danbita/real-steel/docs/img_shop/bearings_1.jpg

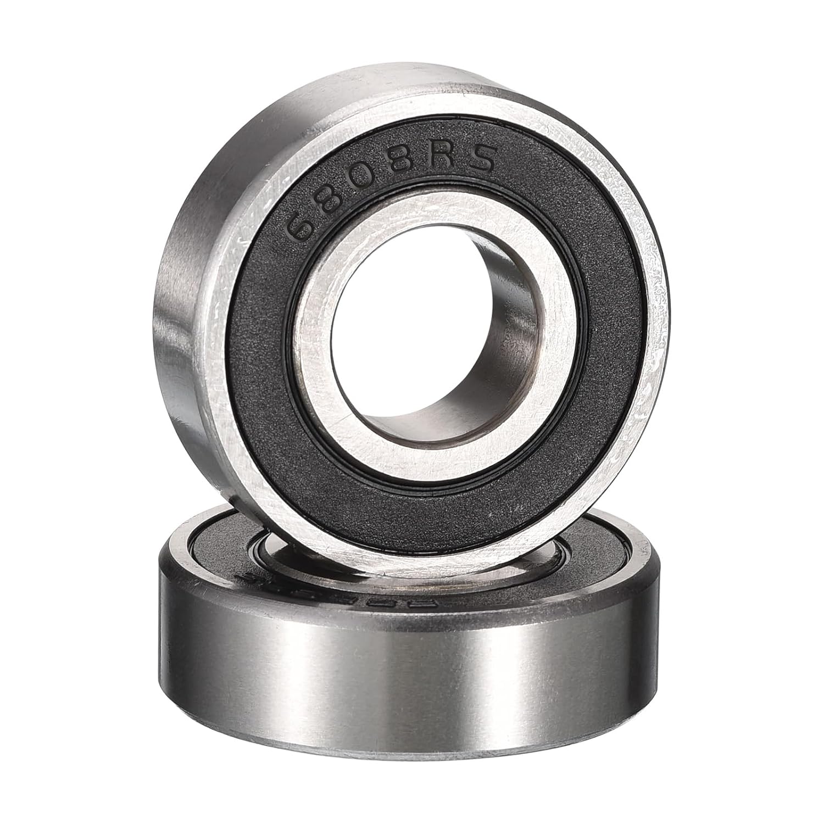
docs/img_shop/bearings_1.jpg
