danbita/real-steel/docs/img_shop/bearings_2.jpg

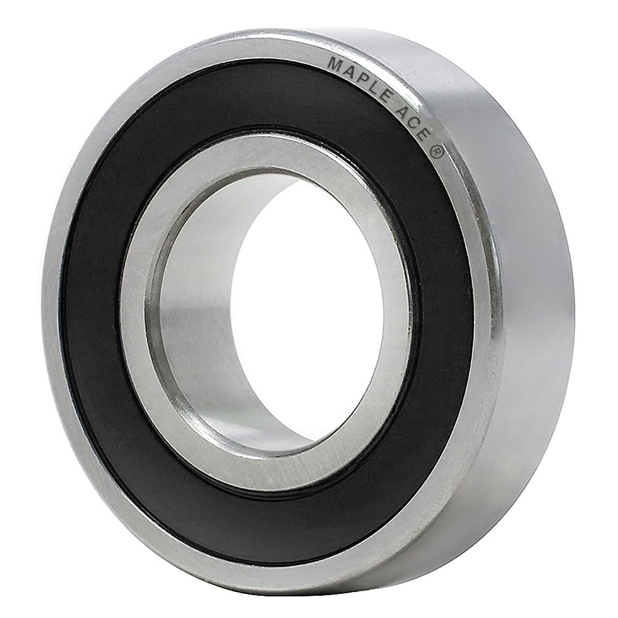
docs/img_shop/bearings_2.jpg
