danbita/real-steel/docs/img_shop/bearings_3.jpg

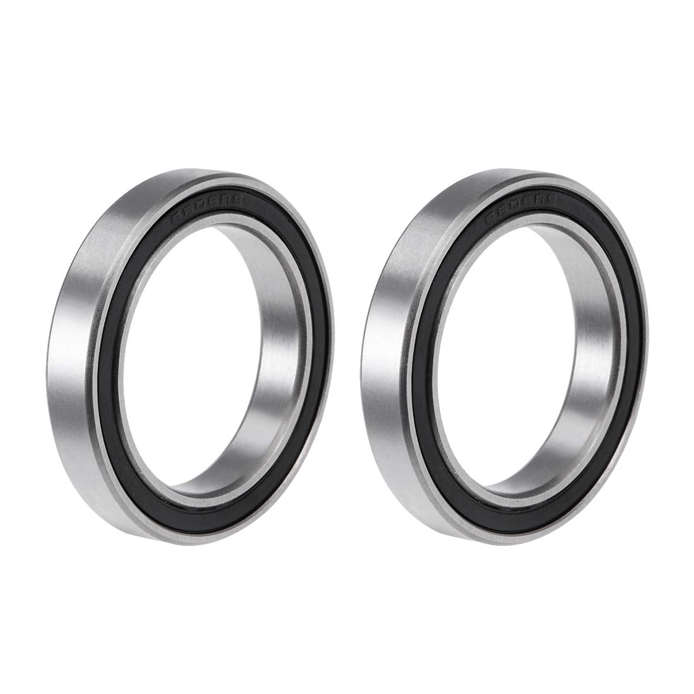
docs/img_shop/bearings_3.jpg
