danbita/real-steel/docs/img_shop/bearings_4.jpg

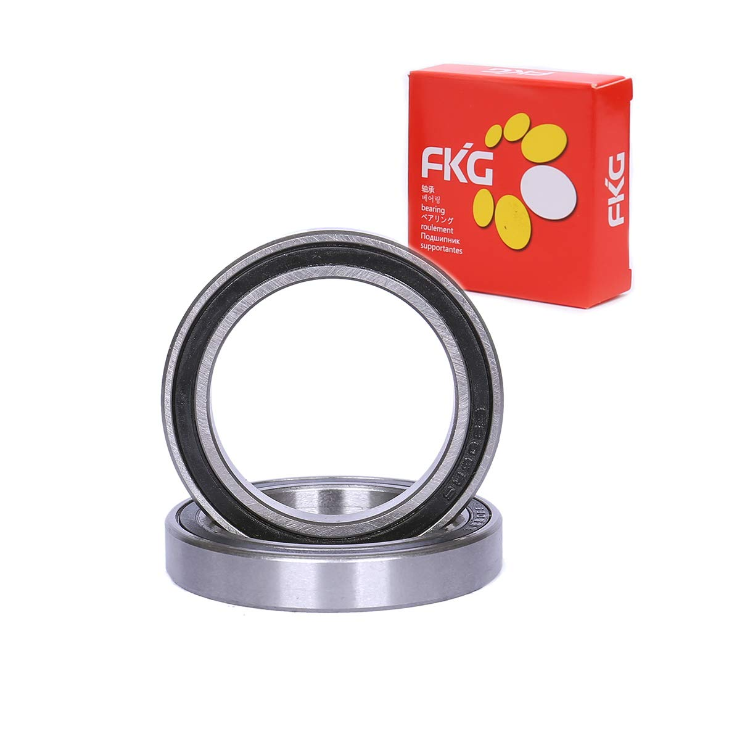
docs/img_shop/bearings_4.jpg
