danbita/real-steel/docs/img_shop/bearings_5.jpg

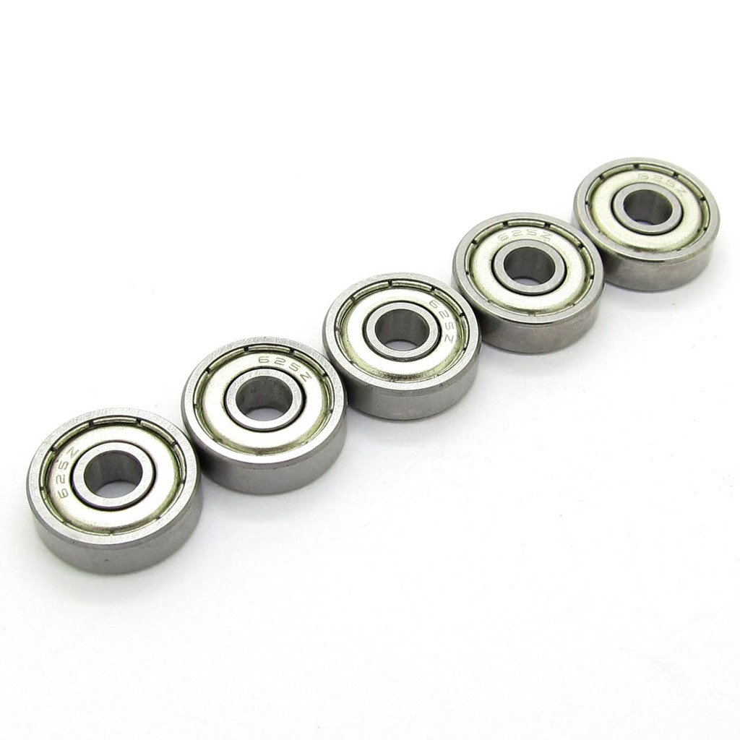
docs/img_shop/bearings_5.jpg
