danbita/real-steel/docs/img_shop/bearings_6.jpg

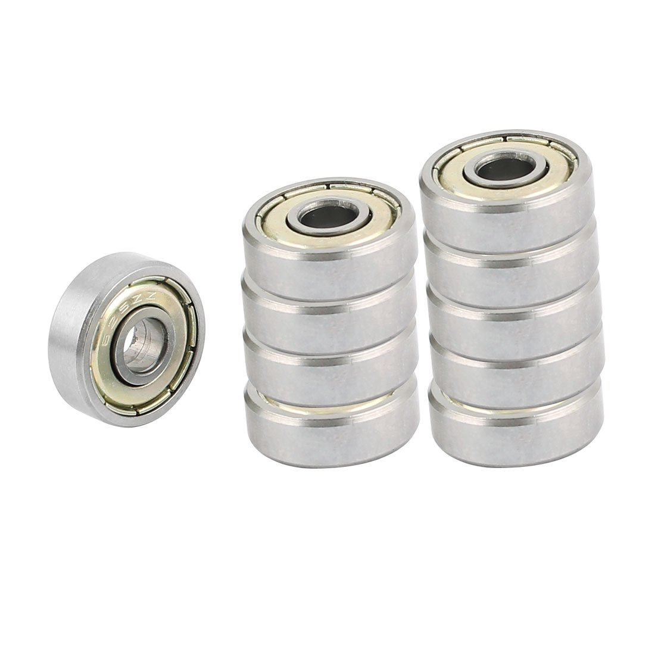
docs/img_shop/bearings_6.jpg
