danbita/real-steel/docs/img_shop/bearings_s1.jpg

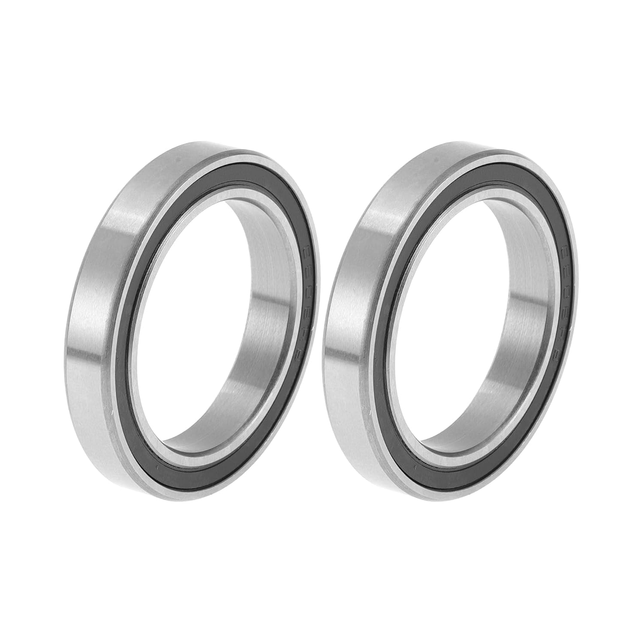
docs/img_shop/bearings_s1.jpg
