danbita/real-steel/docs/img_shop/bearings_s3.jpg

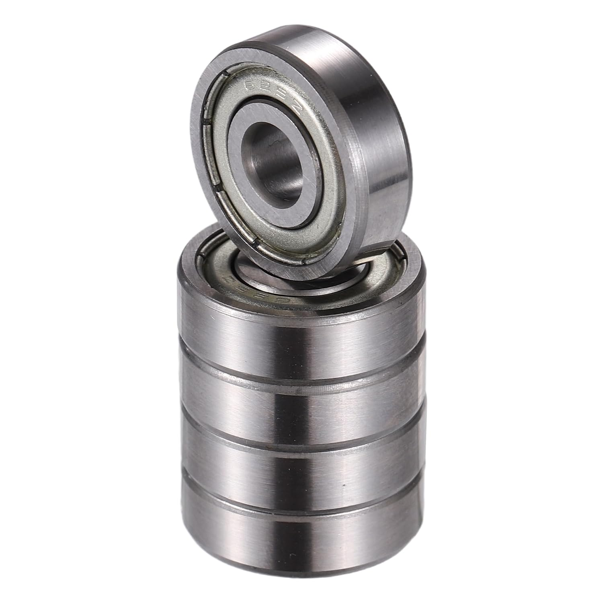
docs/img_shop/bearings_s3.jpg
