danbita/real-steel/docs/img_shop/bearings_s4.jpg

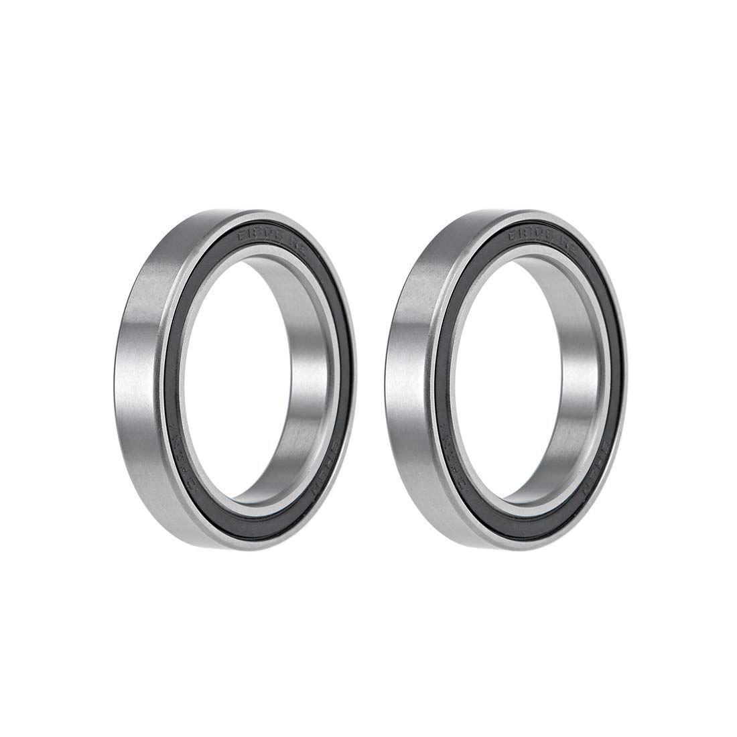
docs/img_shop/bearings_s4.jpg
