danbita/real-steel/docs/img_shop/bearings_s5.jpg

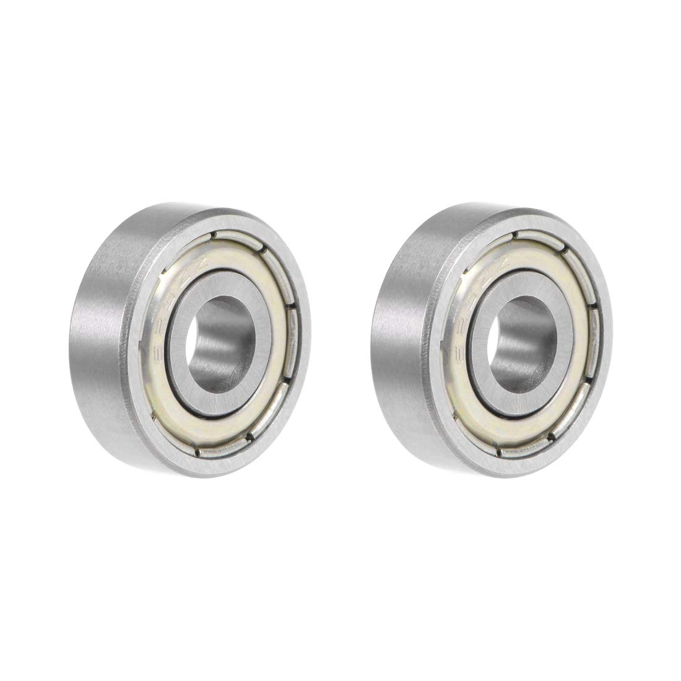
docs/img_shop/bearings_s5.jpg
