danbita/real-steel/docs/img_shop/bearings_s6.jpg

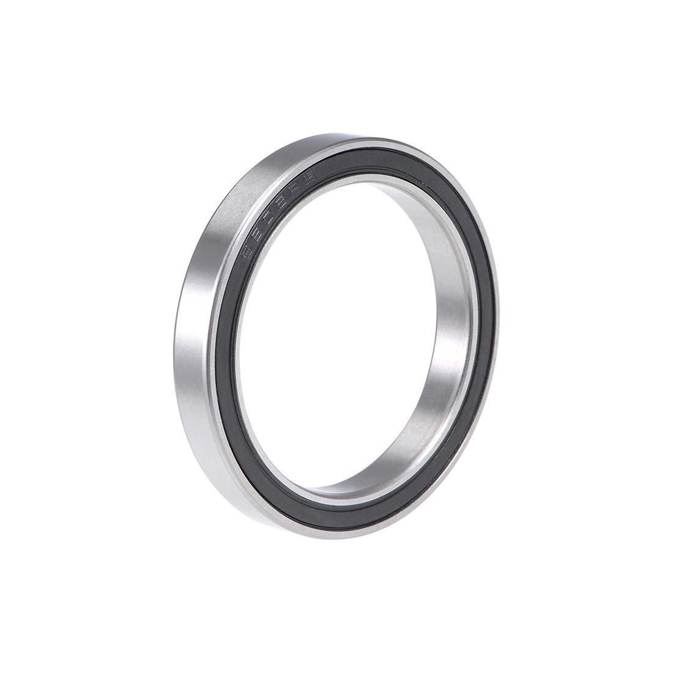
docs/img_shop/bearings_s6.jpg
