danbita/real-steel/docs/img_shop/fasteners_1.jpg

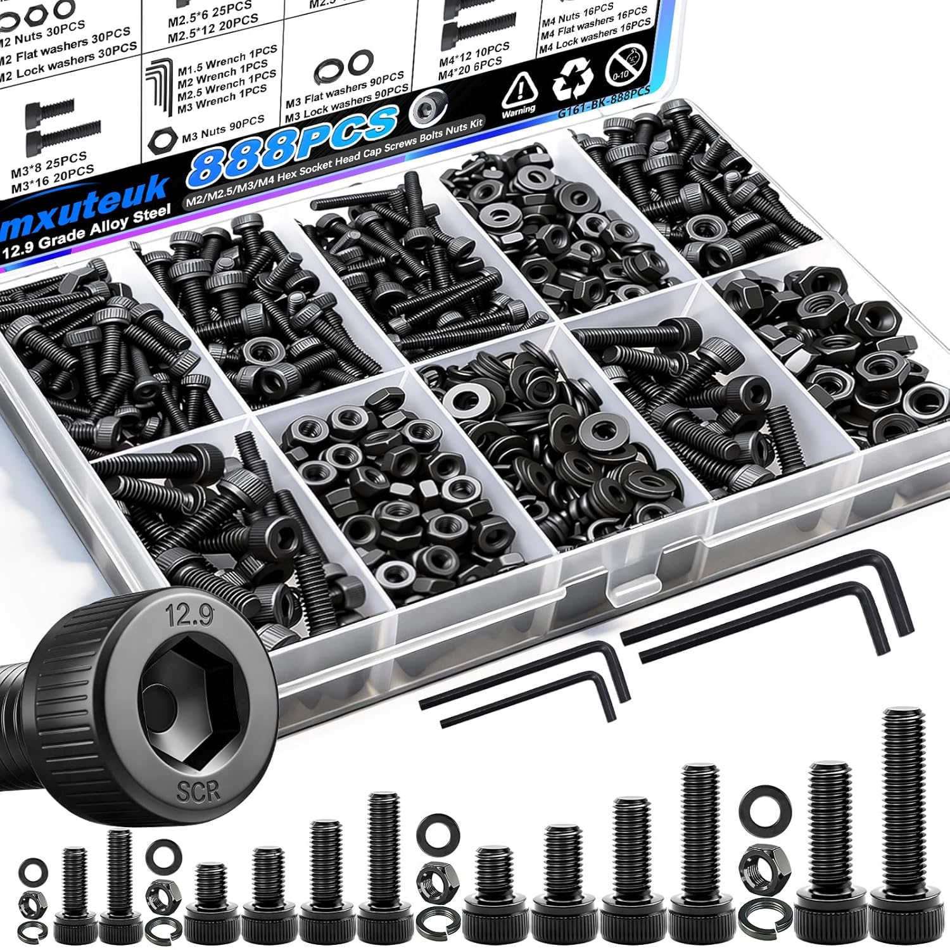
docs/img_shop/fasteners_1.jpg
