danbita/real-steel/docs/img_shop/fasteners_2.jpg

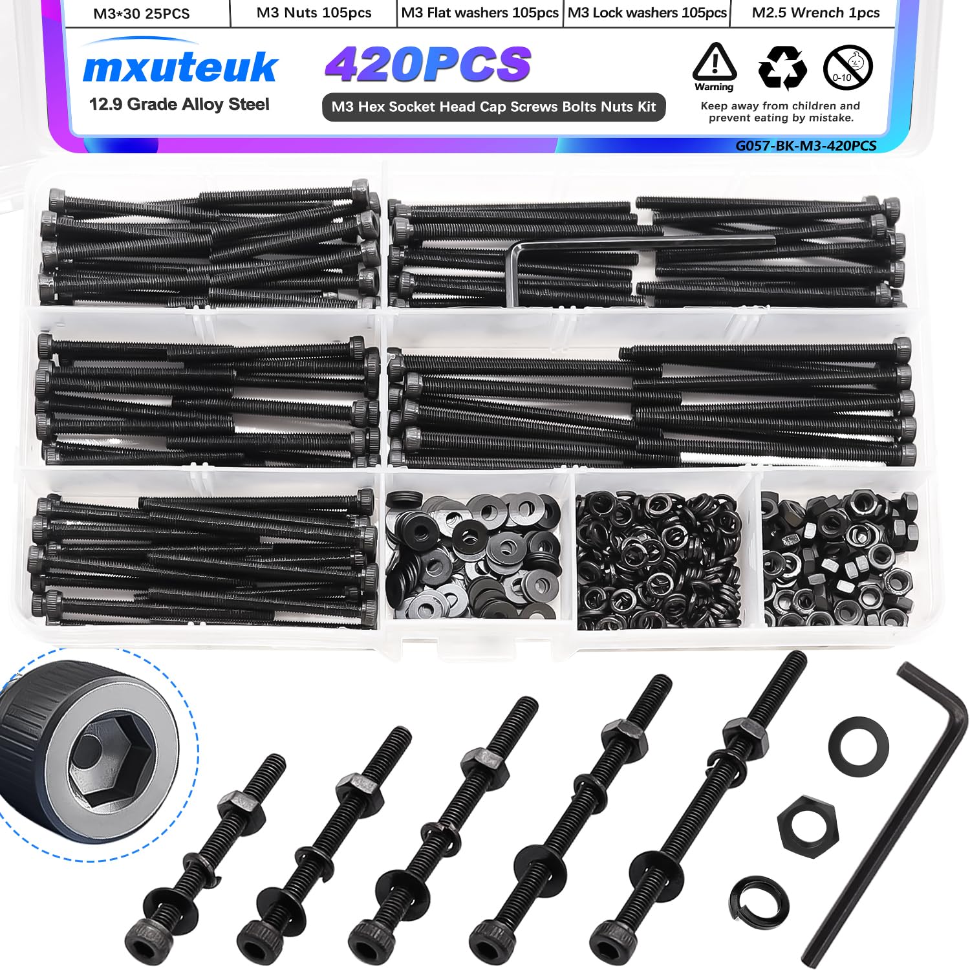
docs/img_shop/fasteners_2.jpg
