danbita/real-steel/docs/img_shop/fasteners_3.jpg

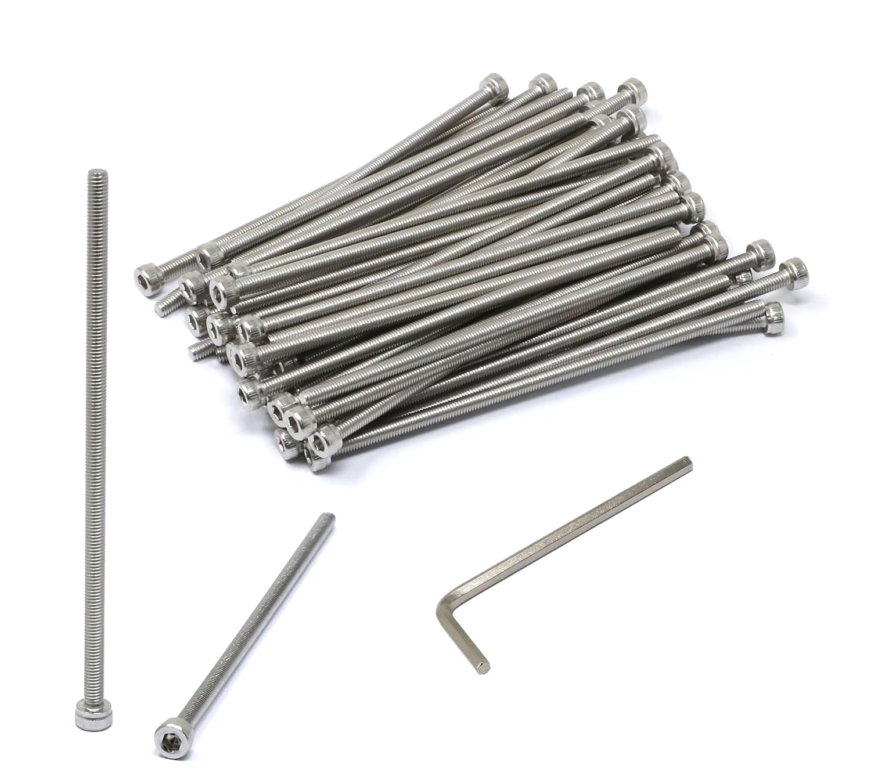
docs/img_shop/fasteners_3.jpg
