danbita/real-steel/docs/img_shop/fasteners_4.jpg

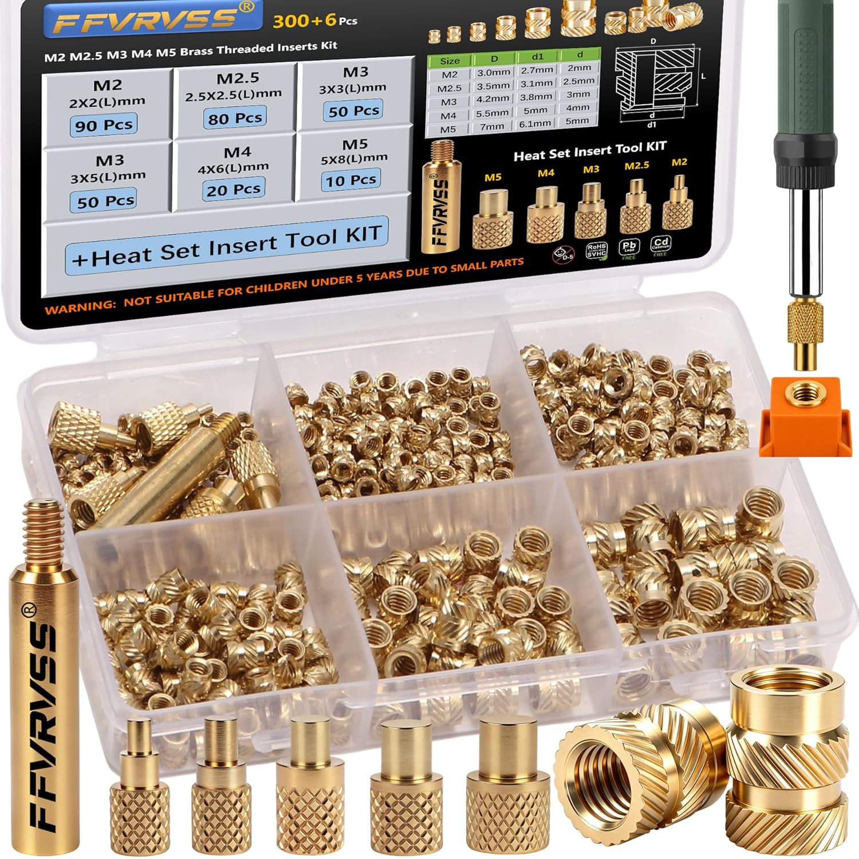
docs/img_shop/fasteners_4.jpg
