danbita/real-steel/docs/img_shop/fasteners_5.jpg

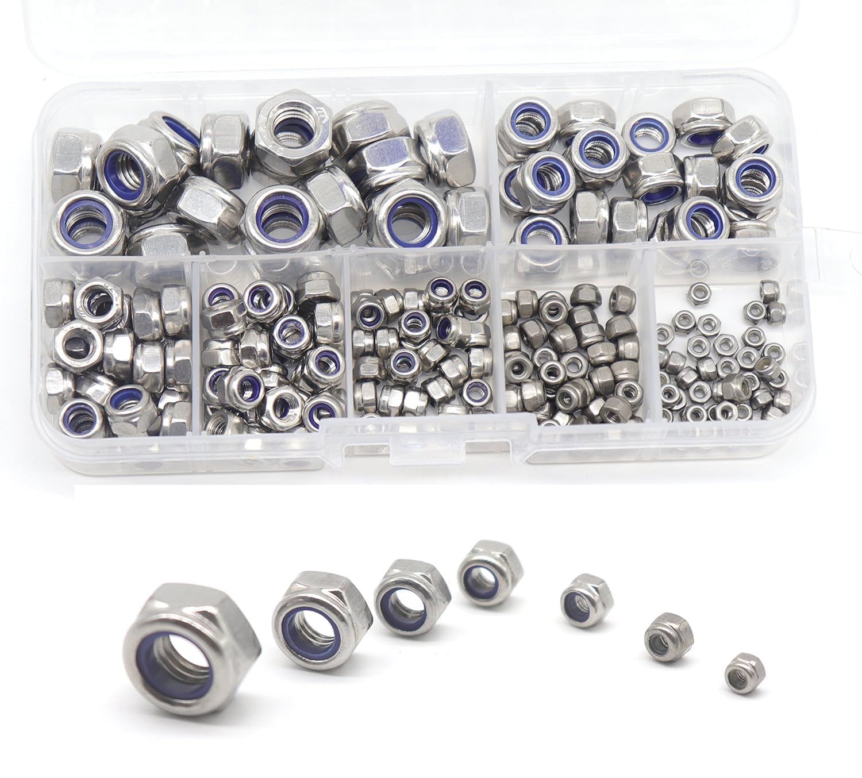
docs/img_shop/fasteners_5.jpg
