danbita/real-steel/docs/img_shop/fasteners_6.jpg

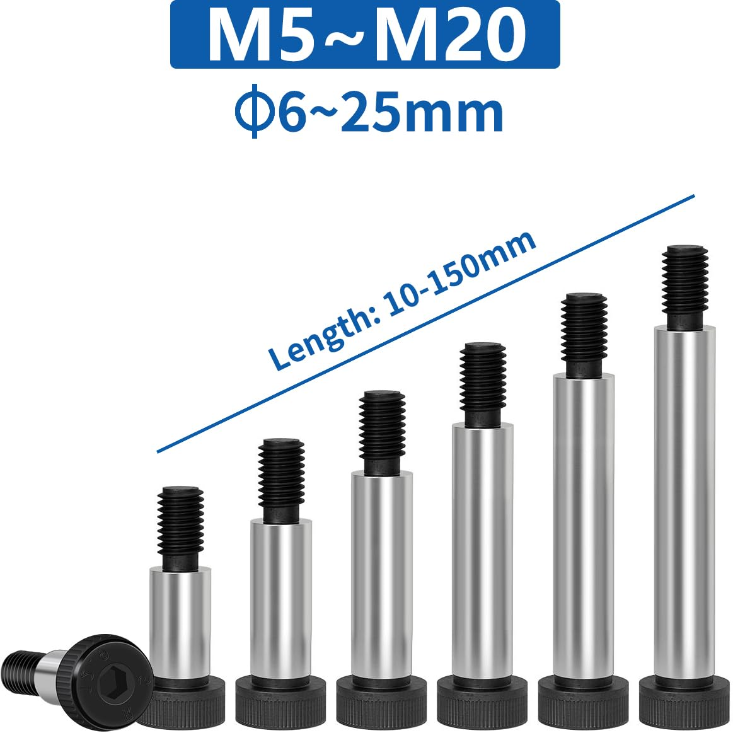
docs/img_shop/fasteners_6.jpg
