danbita/real-steel/docs/img_shop/fasteners_s1.jpg

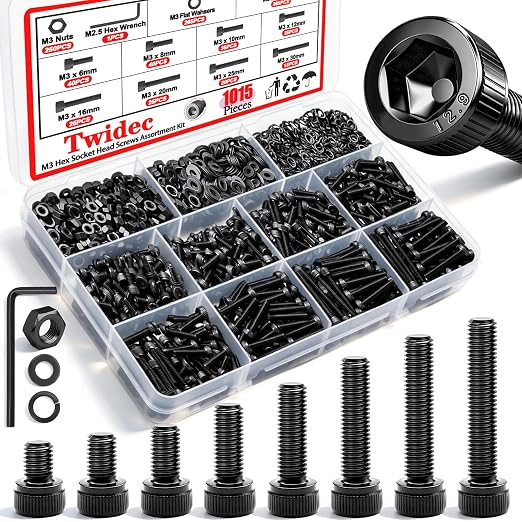
docs/img_shop/fasteners_s1.jpg
