danbita/real-steel/docs/img_shop/fasteners_s2.jpg

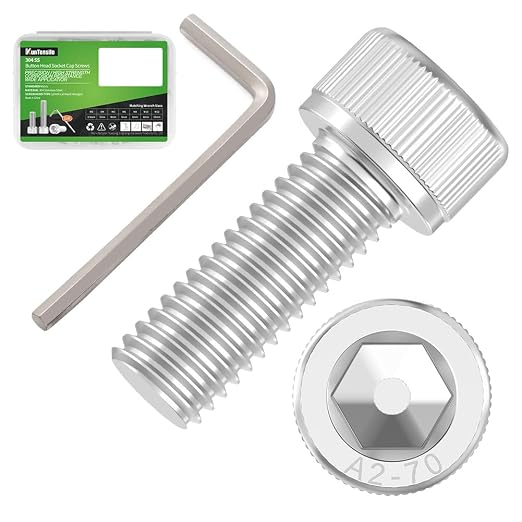
docs/img_shop/fasteners_s2.jpg
