danbita/real-steel/docs/img_shop/fasteners_s3.jpg

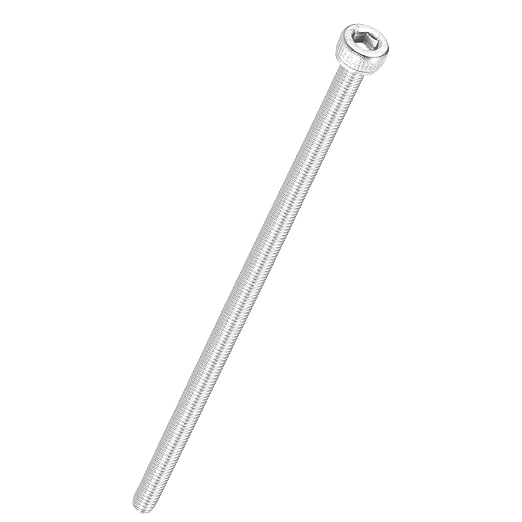
docs/img_shop/fasteners_s3.jpg
