danbita/real-steel/docs/img_shop/fasteners_s4.jpg

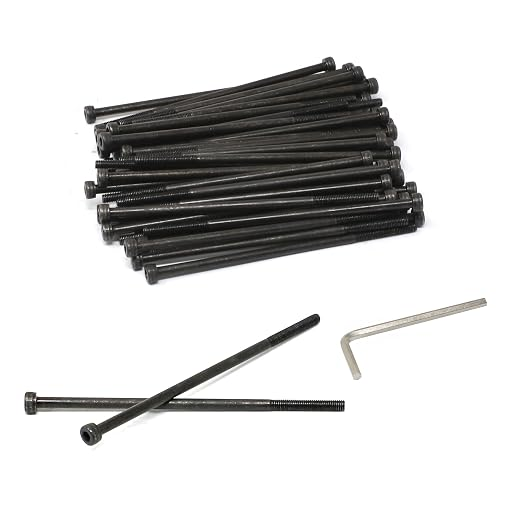
docs/img_shop/fasteners_s4.jpg
