danbita/real-steel/docs/img_shop/fasteners_s5.jpg

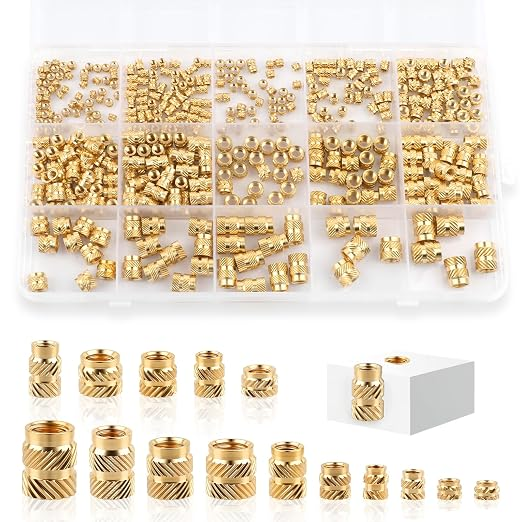
docs/img_shop/fasteners_s5.jpg
