danbita/real-steel/docs/img_shop/fasteners_s6.jpg

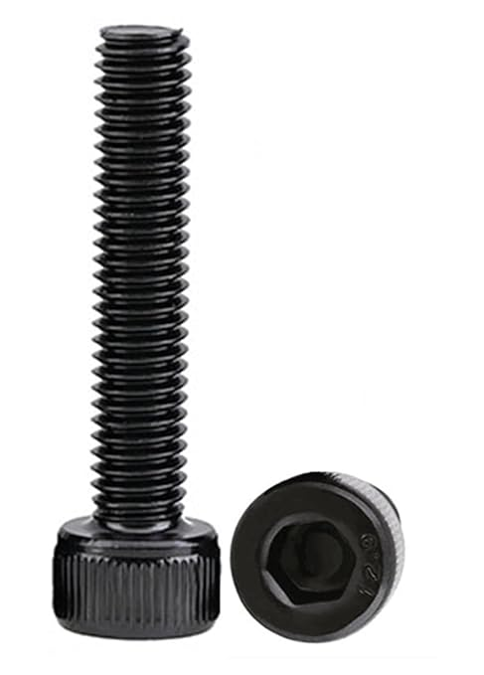
docs/img_shop/fasteners_s6.jpg
