danbita/real-steel/docs/img_shop/hts35h_ref_1.jpg

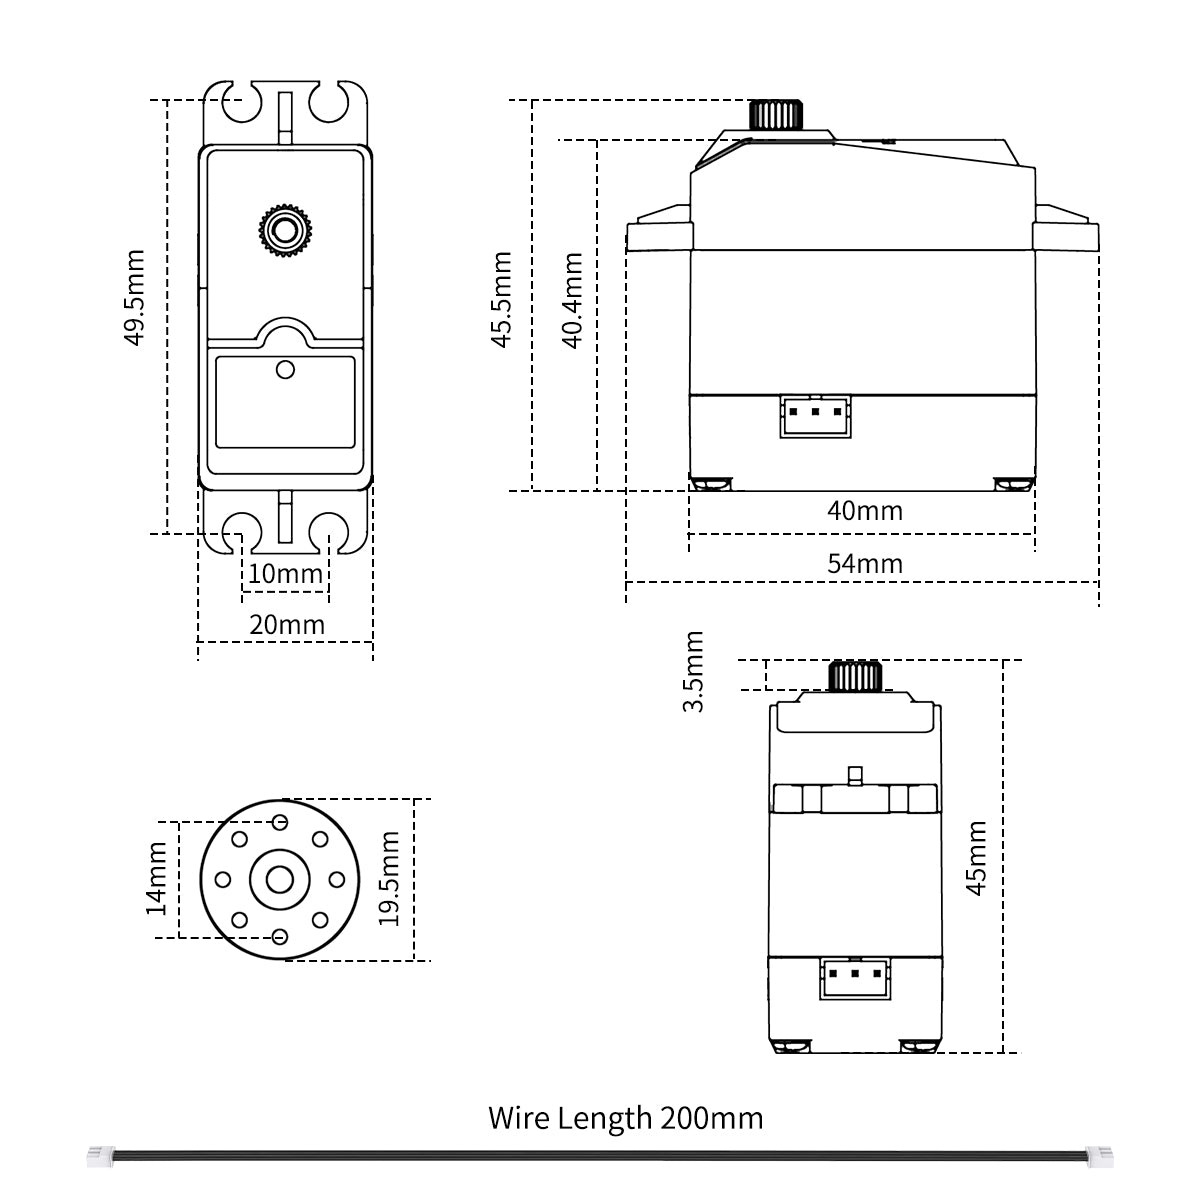
docs/img_shop/hts35h_ref_1.jpg
