danbita/real-steel/docs/img_shop/hts35h_ref_4.jpg

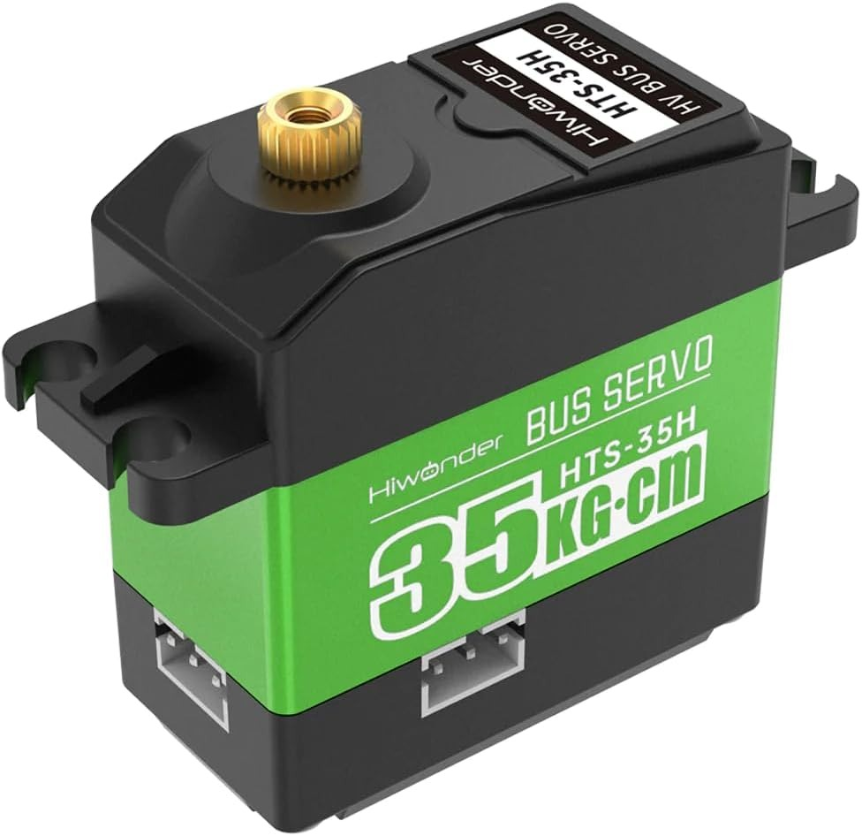
docs/img_shop/hts35h_ref_4.jpg
