danbita/real-steel/docs/img_shop/hts35h_ref_8.jpg

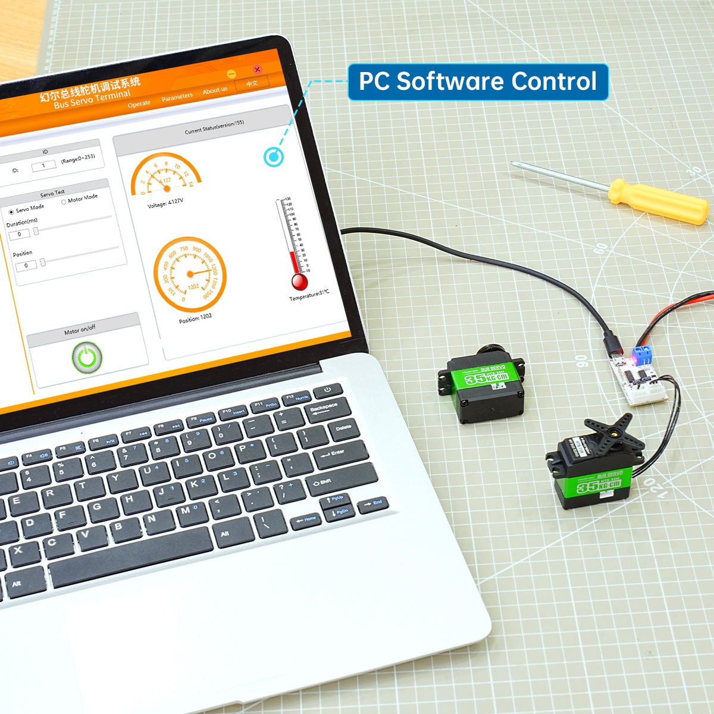
docs/img_shop/hts35h_ref_8.jpg
