danbita/real-steel/docs/img_shop/servo_6.jpg

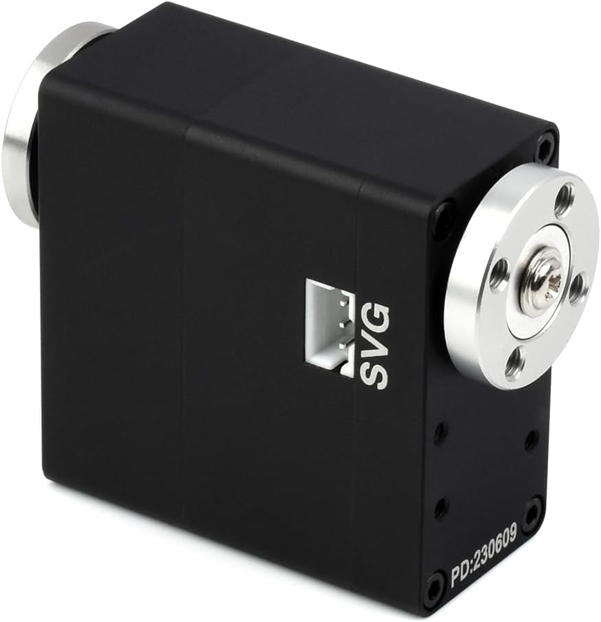
docs/img_shop/servo_6.jpg
