danbita/real-steel/docs/img_shop/servo_distal_1.jpg

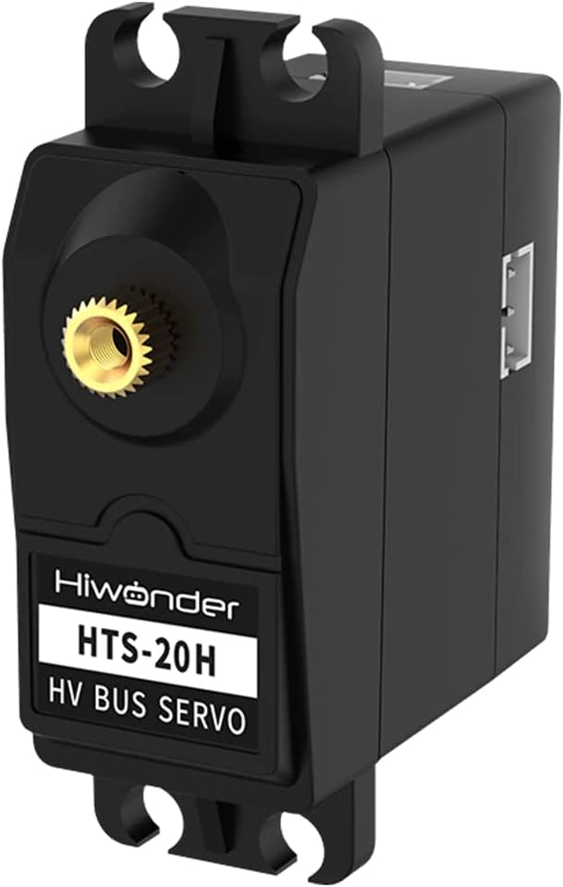
docs/img_shop/servo_distal_1.jpg
