danbita/real-steel/docs/img_shop/servo_distal_2.jpg

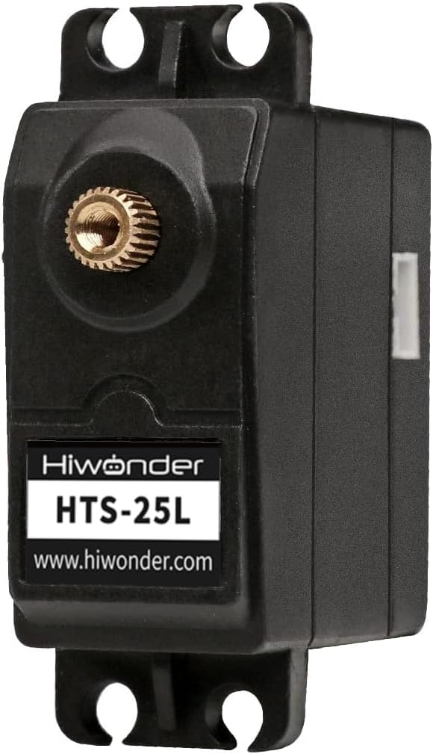
docs/img_shop/servo_distal_2.jpg
