danbita/real-steel/docs/img_shop/servo_distal_3.jpg

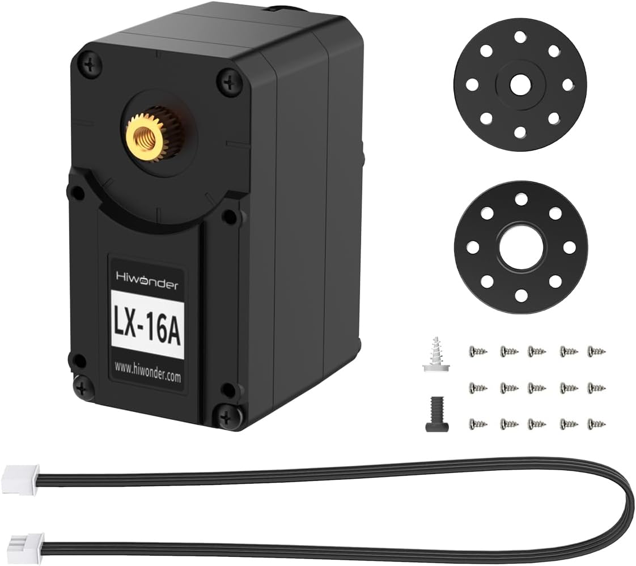
docs/img_shop/servo_distal_3.jpg
