danbita/real-steel/docs/img_shop/servo_distal_4.jpg

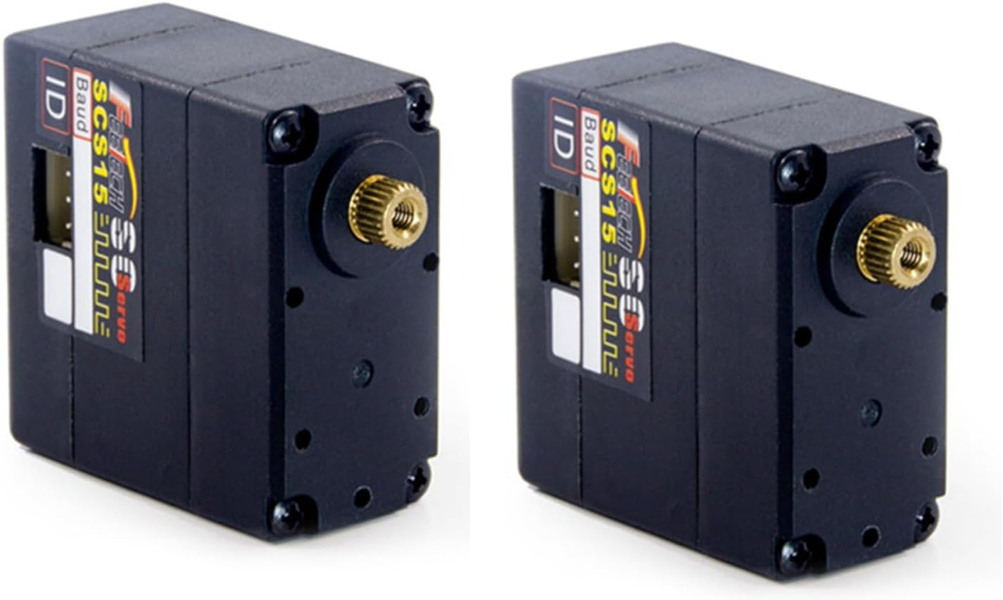
docs/img_shop/servo_distal_4.jpg
