danbita/real-steel/docs/img_shop/servo_distal_5.jpg

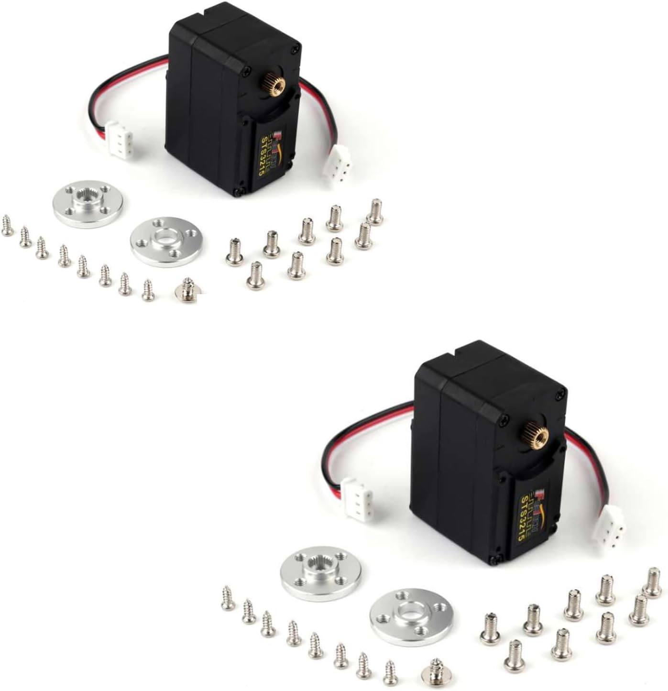
docs/img_shop/servo_distal_5.jpg
