danbita/real-steel/docs/img_shop/servo_distal_6.jpg

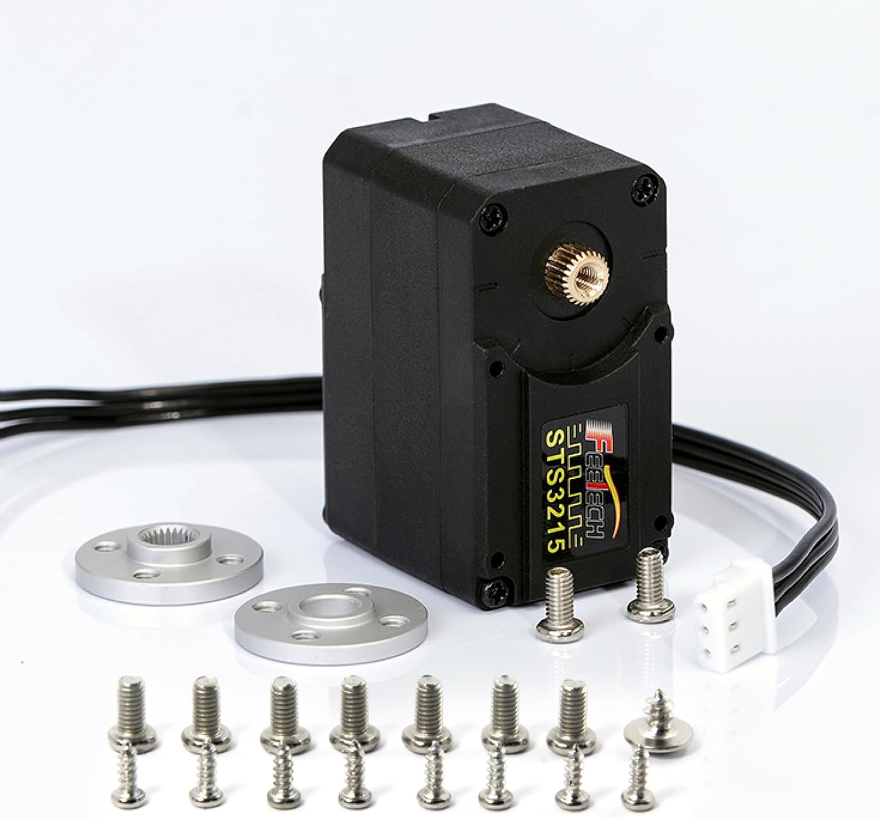
docs/img_shop/servo_distal_6.jpg
