danbita/real-steel/docs/img_shop/servo_open_1.jpg

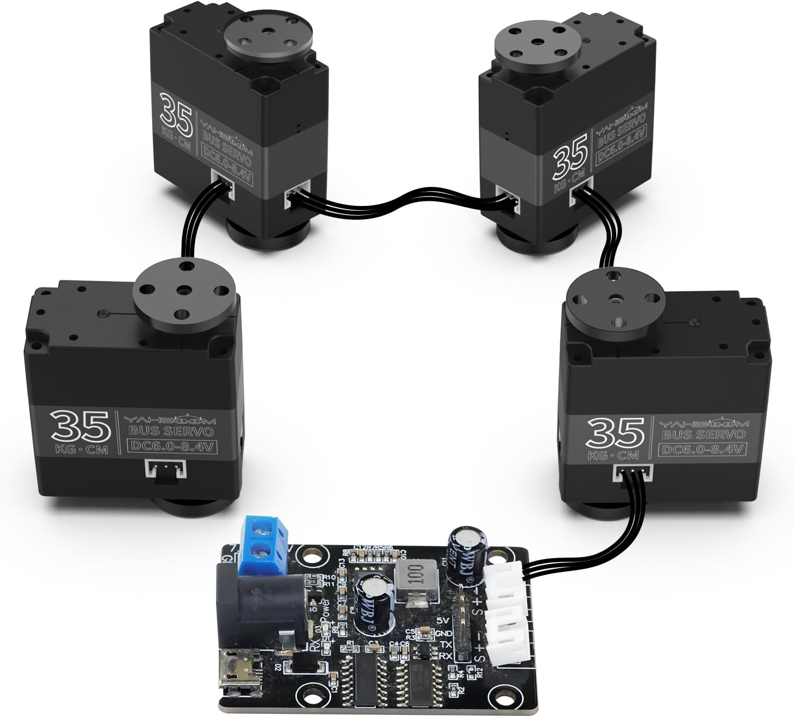
docs/img_shop/servo_open_1.jpg
