danbita/real-steel/docs/img_shop/servo_open_3.jpg

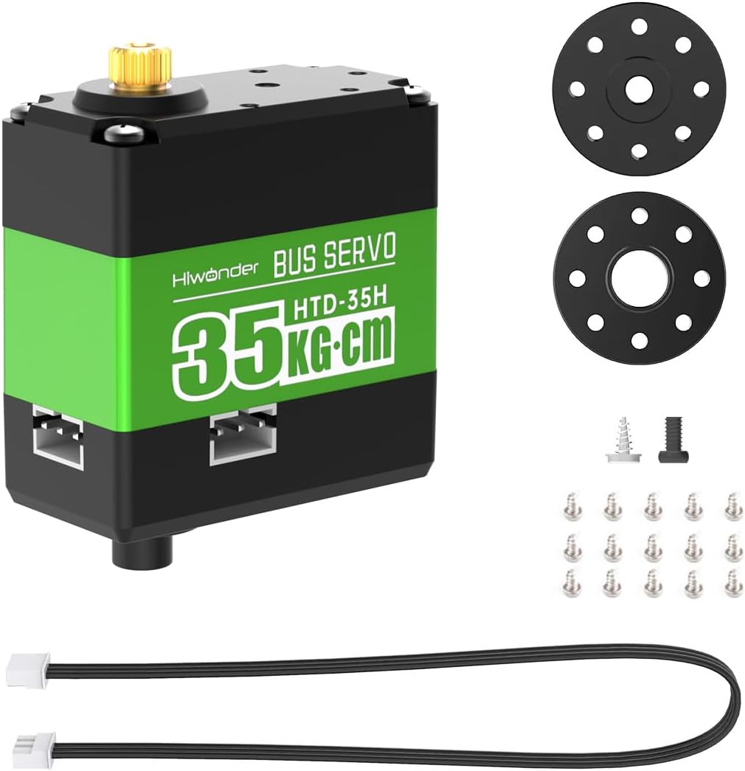
docs/img_shop/servo_open_3.jpg
