danbita/real-steel/docs/img_shop/servo_open_5.jpg

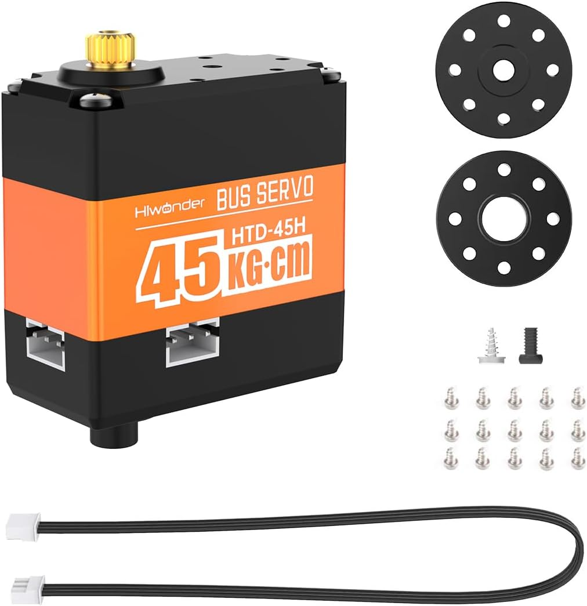
docs/img_shop/servo_open_5.jpg
