danbita/real-steel/docs/img_shop/servo_open_6.jpg

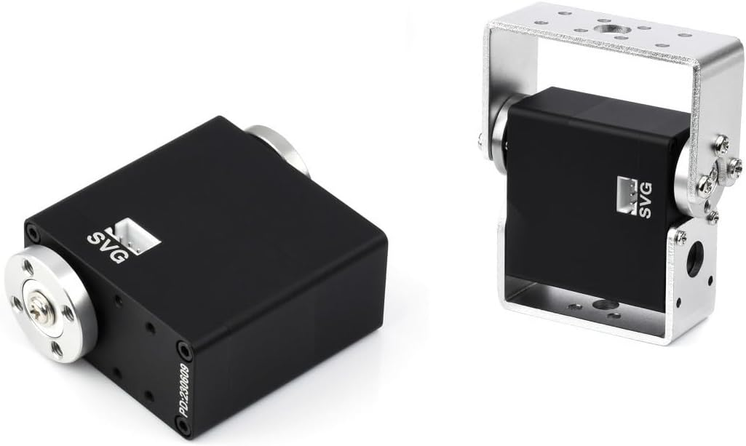
docs/img_shop/servo_open_6.jpg
