danbita/real-steel/docs/img_shop/servo_open_7.jpg

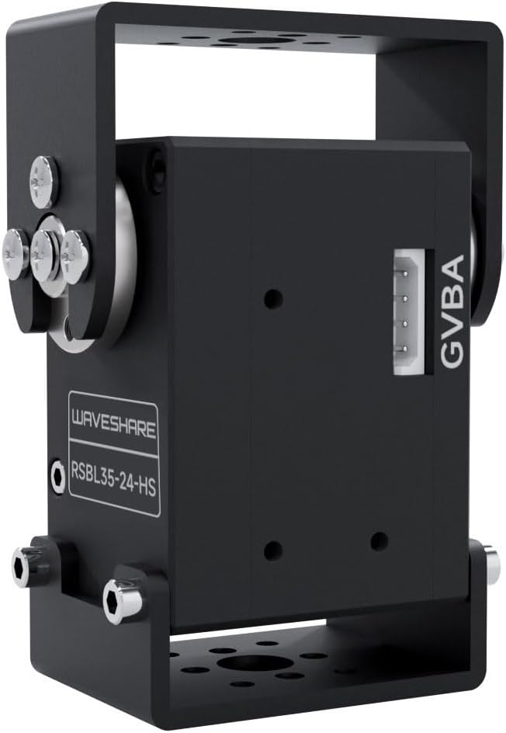
docs/img_shop/servo_open_7.jpg
