danbita/real-steel/docs/img_shop/servohorn_1.jpg

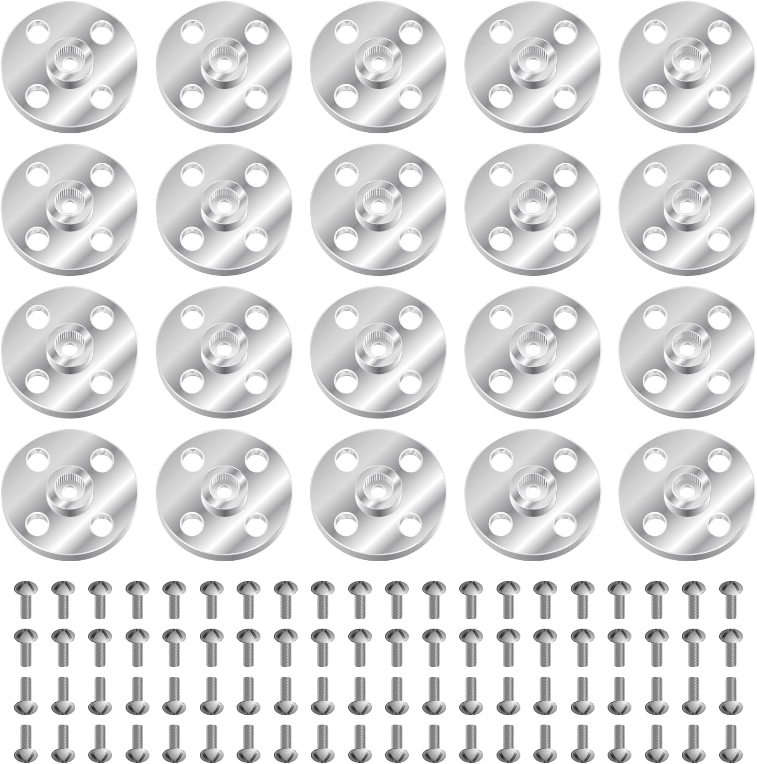
docs/img_shop/servohorn_1.jpg
