danbita/real-steel/docs/img_shop/servohorn_2.jpg

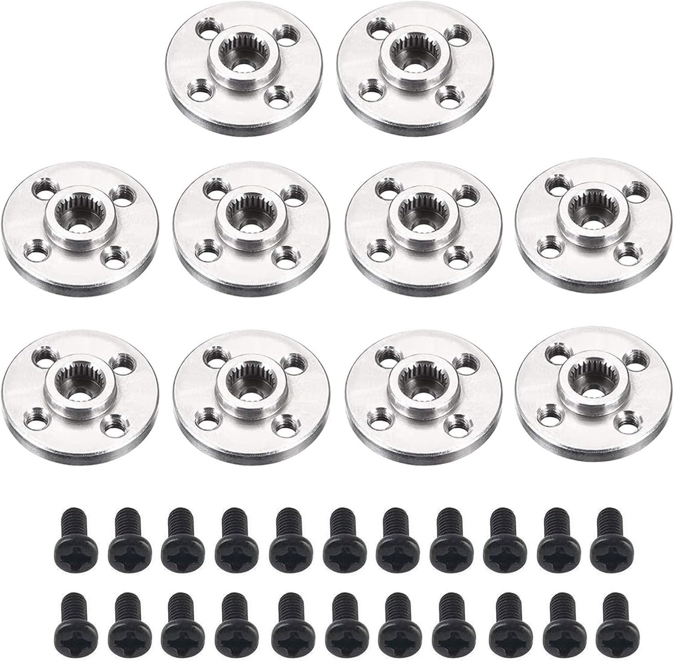
docs/img_shop/servohorn_2.jpg
