danbita/real-steel/docs/img_shop/servohorn_3.jpg

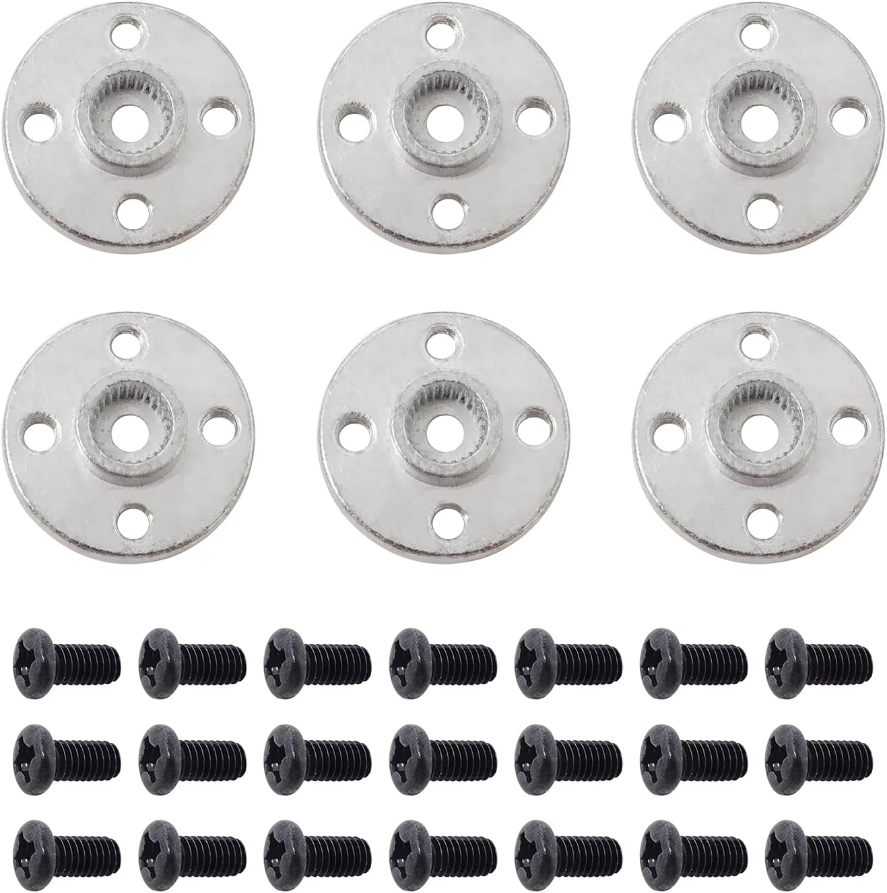
docs/img_shop/servohorn_3.jpg
