danbita/real-steel/docs/img_shop/servohorn_4.jpg

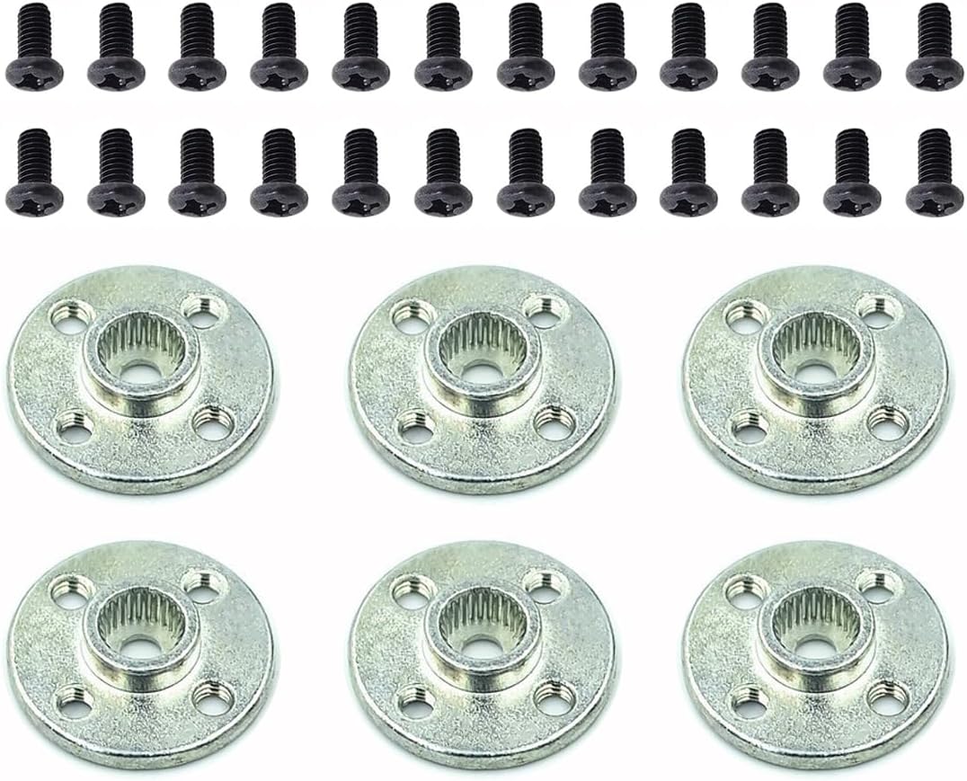
docs/img_shop/servohorn_4.jpg
