danbita/real-steel/docs/img_shop/servohorn_5.jpg

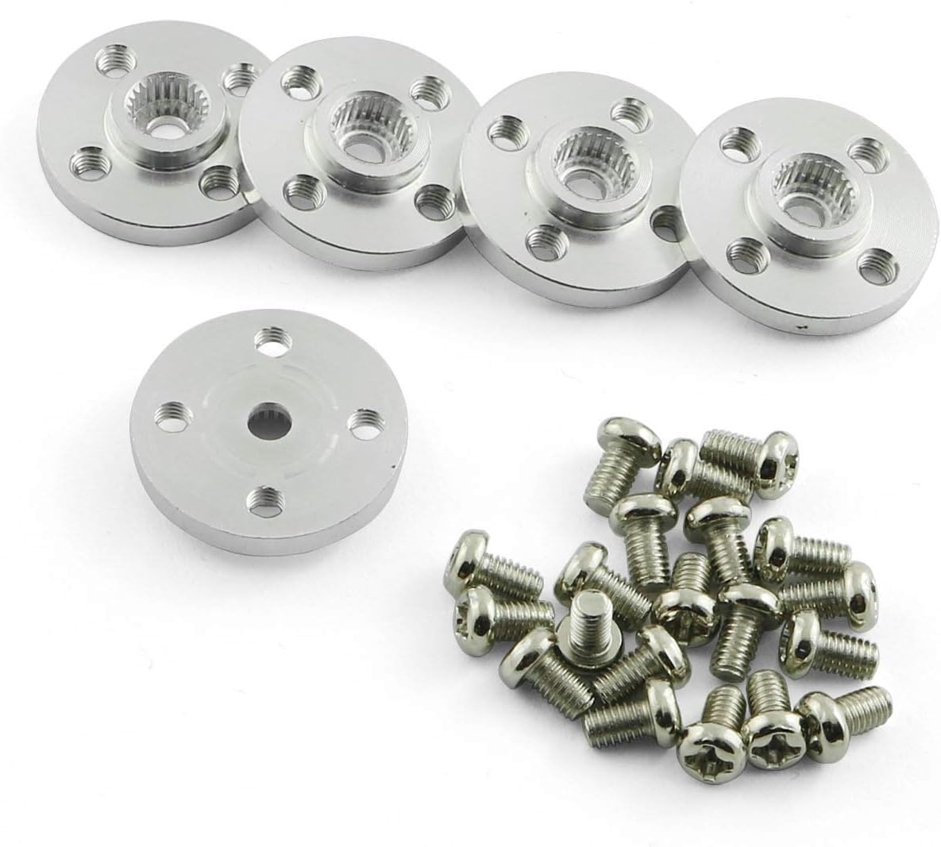
docs/img_shop/servohorn_5.jpg
