danbita/real-steel/docs/img_shop/servohorn_6.jpg

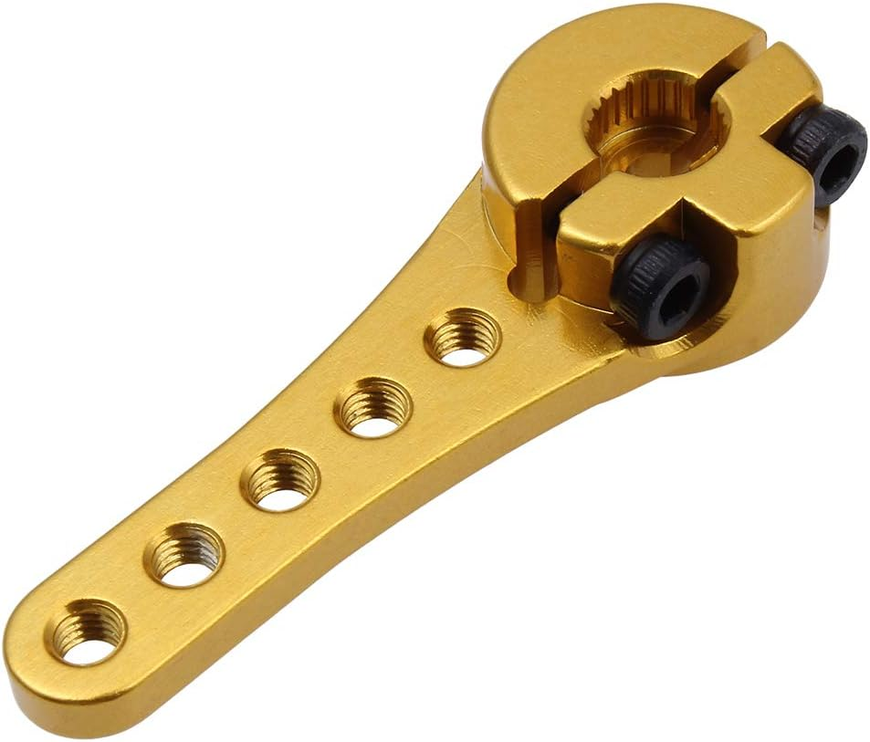
docs/img_shop/servohorn_6.jpg
