danbita/real-steel/docs/img_shop/servohorn_s3.jpg

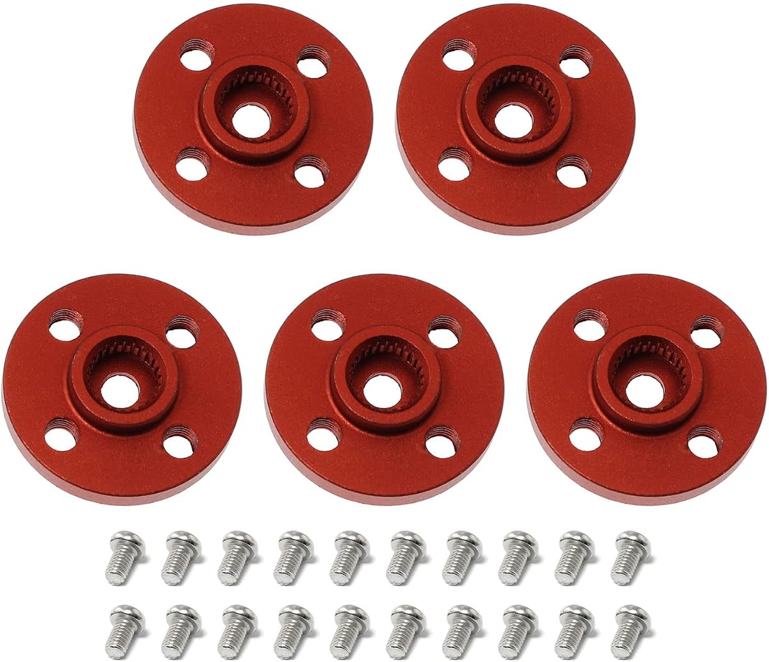
docs/img_shop/servohorn_s3.jpg
