danbita/real-steel/docs/img_shop/servohorn_s5.jpg

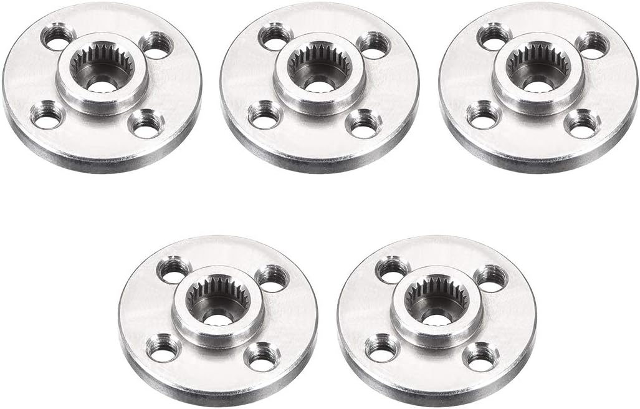
docs/img_shop/servohorn_s5.jpg
