danbita/real-steel/docs/img_shop/servohorn_s6.jpg

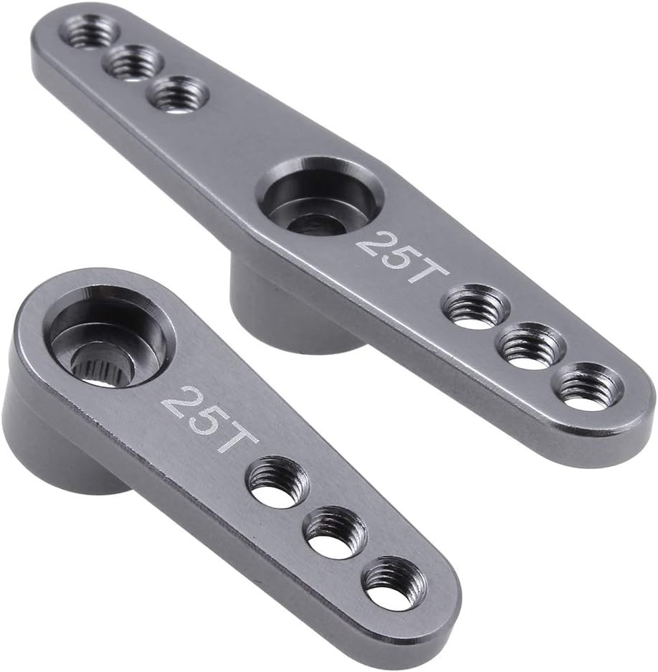
docs/img_shop/servohorn_s6.jpg
