danbita/real-steel/docs/img_shop/servos_s2.jpg

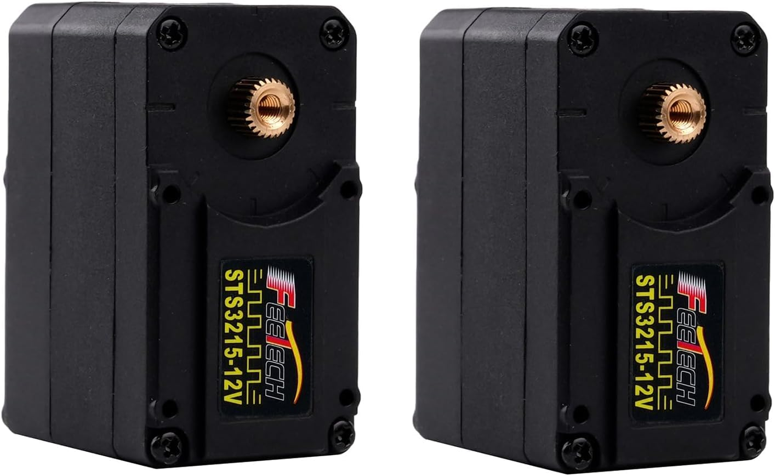
docs/img_shop/servos_s2.jpg
