danbita/real-steel/docs/img_shop/servos_s3.jpg

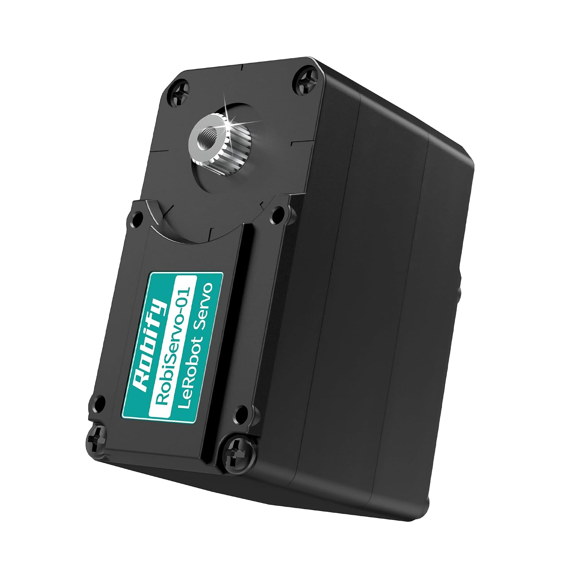
docs/img_shop/servos_s3.jpg
