danbita/real-steel/docs/img_shop/servos_s5.jpg

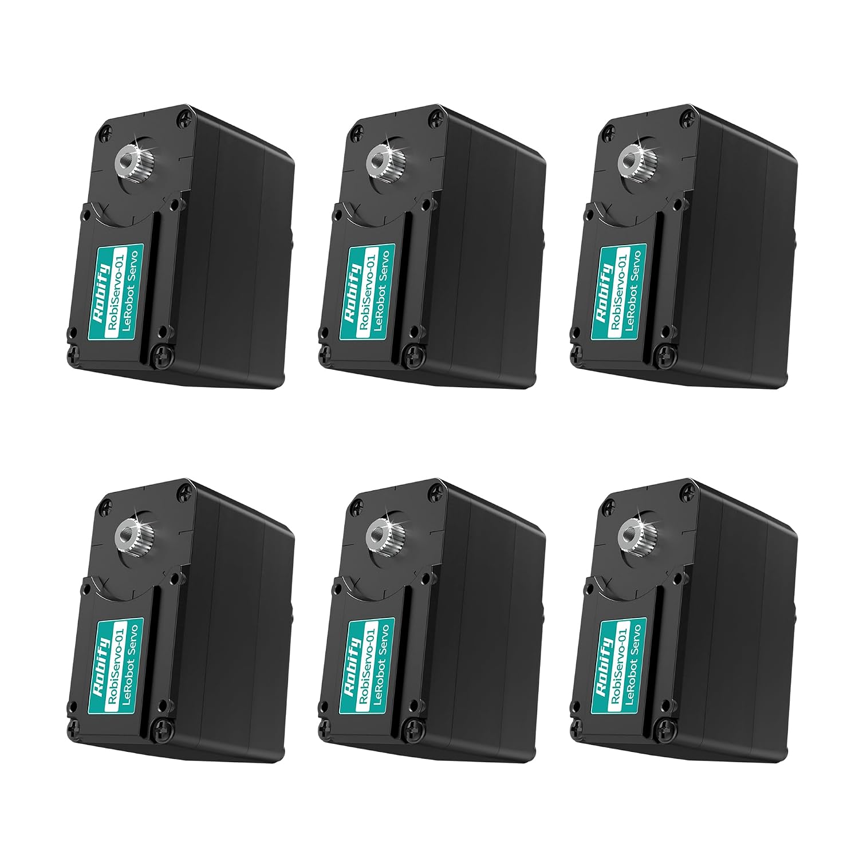
docs/img_shop/servos_s5.jpg
