danbita/real-steel/docs/img_v6/a1.gif

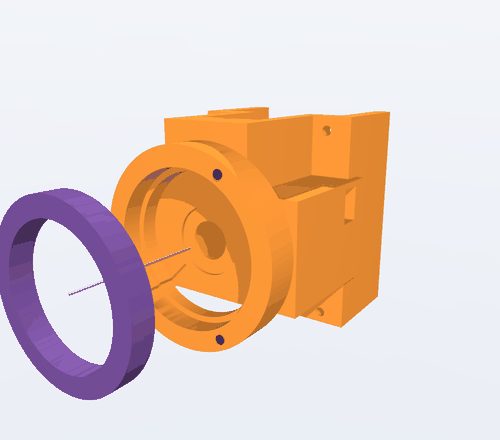
docs/img_v6/a1.gif
