danbita/real-steel/docs/img_v6/a1.png

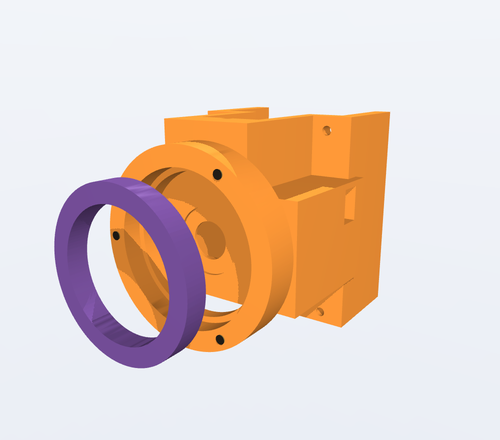
docs/img_v6/a1.png
