danbita/real-steel/docs/img_v6/a2.gif

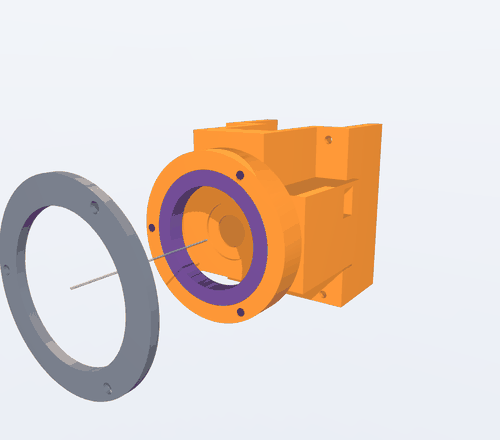
docs/img_v6/a2.gif
