danbita/real-steel/docs/img_v6/a2.png

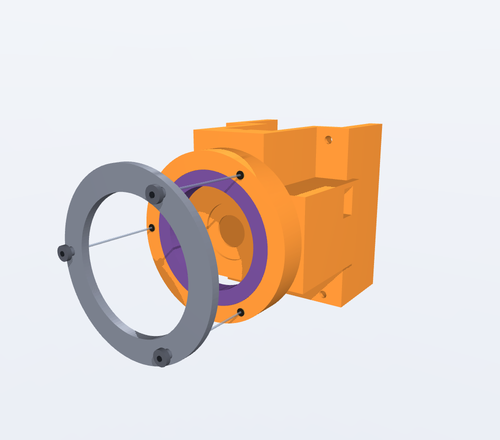
docs/img_v6/a2.png
