danbita/real-steel/docs/img_v6/b1.gif

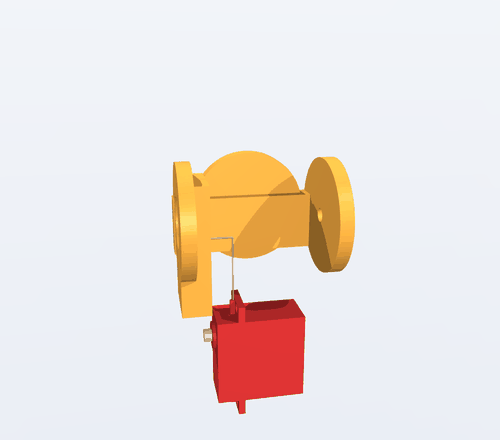
docs/img_v6/b1.gif
