danbita/real-steel/docs/img_v6/b1.png

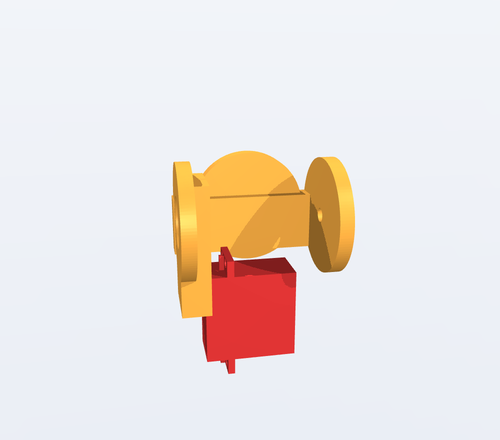
docs/img_v6/b1.png
