danbita/real-steel/docs/img_v6/b2.gif

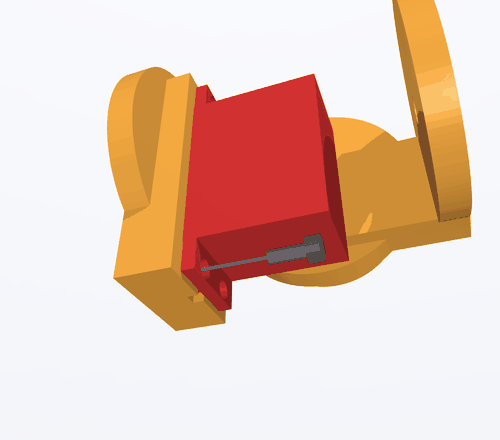
docs/img_v6/b2.gif
