danbita/real-steel/docs/img_v6/b2.png

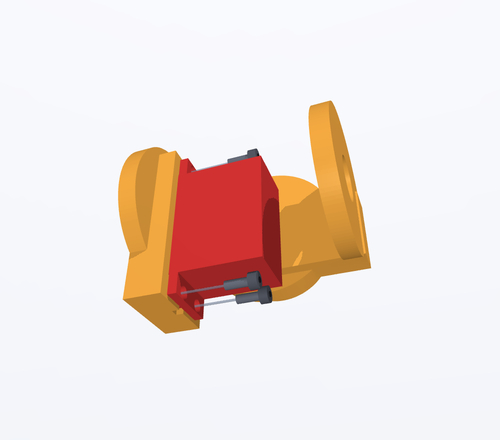
docs/img_v6/b2.png
