danbita/real-steel/docs/img_v6/b3.gif

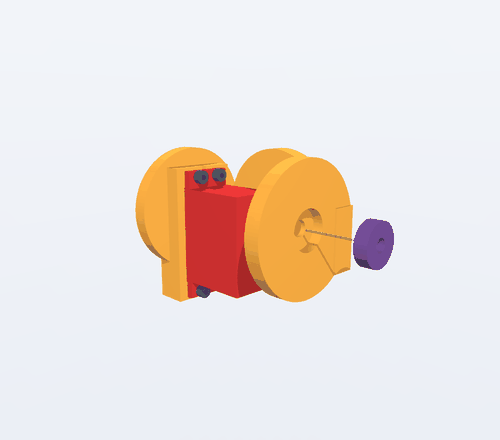
docs/img_v6/b3.gif
