danbita/real-steel/docs/img_v6/b3.png

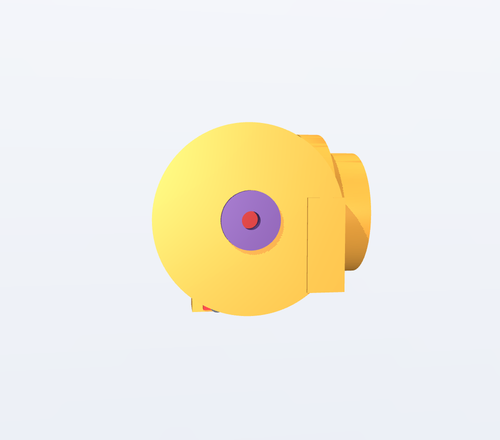
docs/img_v6/b3.png
