danbita/real-steel/docs/img_v6/b4.gif

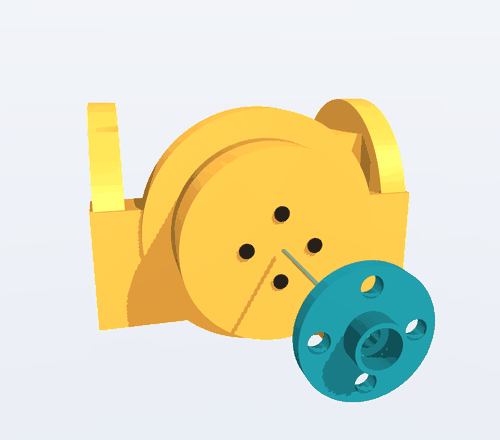
docs/img_v6/b4.gif
