danbita/real-steel/docs/img_v6/b4.png

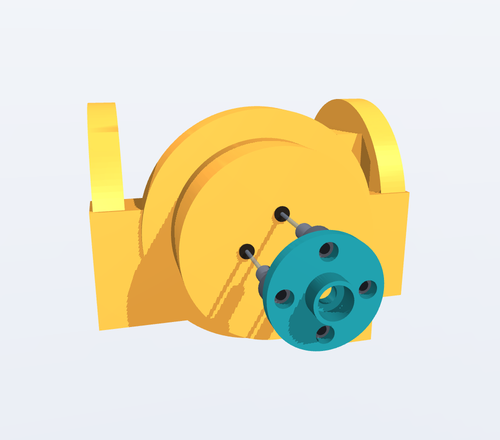
docs/img_v6/b4.png
