danbita/real-steel/docs/img_v6/c1.gif

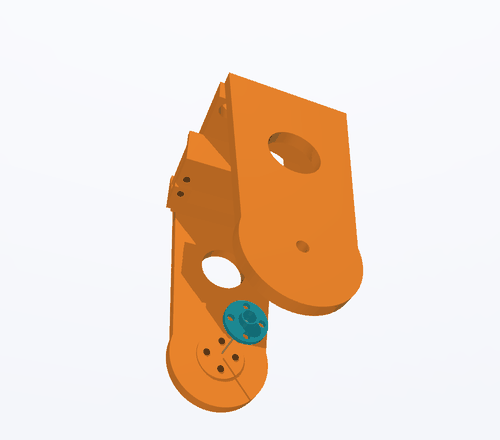
docs/img_v6/c1.gif
