danbita/real-steel/docs/img_v6/c1.png

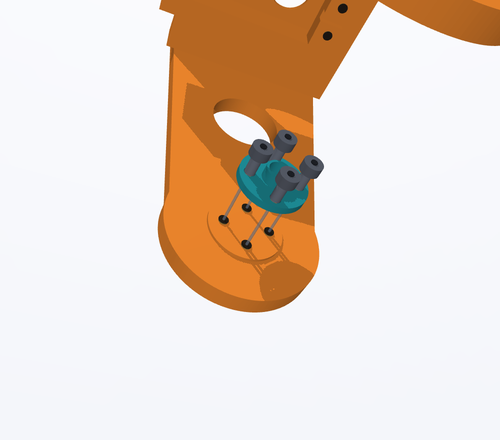
docs/img_v6/c1.png
