danbita/real-steel/docs/img_v6/c2.gif

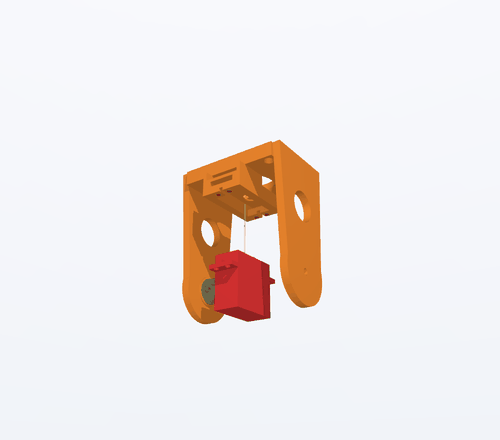
docs/img_v6/c2.gif
