danbita/real-steel/docs/img_v6/c3.gif

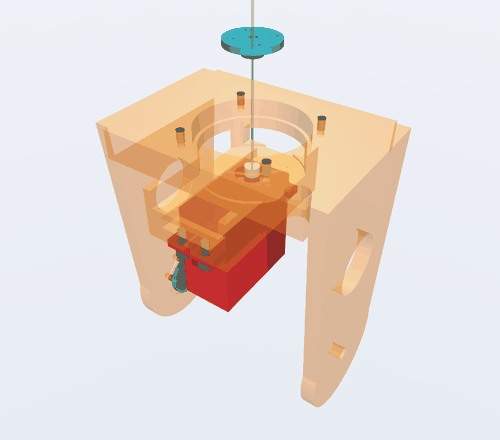
docs/img_v6/c3.gif
