danbita/real-steel/docs/img_v6/c3.png

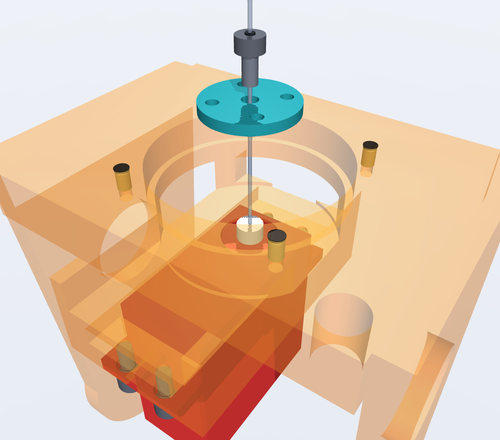
docs/img_v6/c3.png
