danbita/real-steel/docs/img_v6/c4.gif

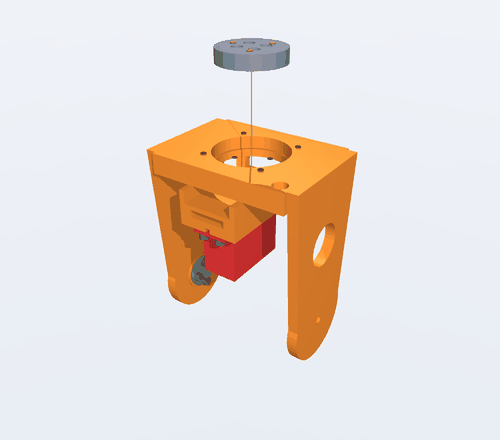
docs/img_v6/c4.gif
