danbita/real-steel/docs/img_v6/c5.gif

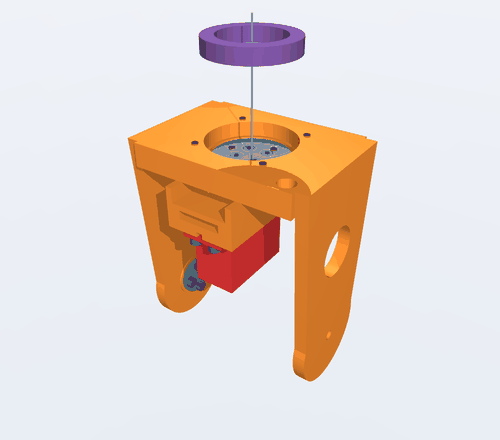
docs/img_v6/c5.gif
