danbita/real-steel/docs/img_v6/c7.gif

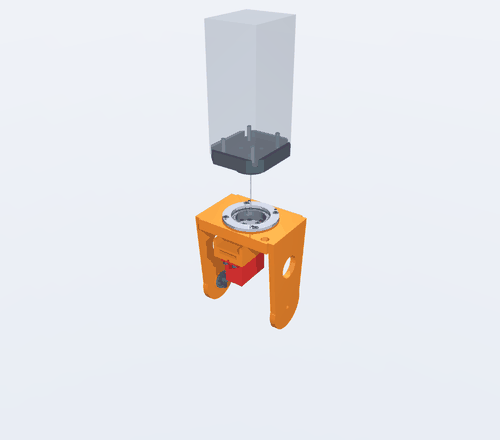
docs/img_v6/c7.gif
