danbita/real-steel/docs/img_v6/c8.gif

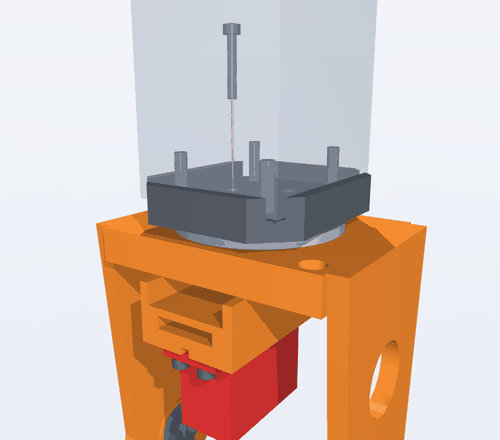
docs/img_v6/c8.gif
