danbita/real-steel/docs/img_v6/c8.png

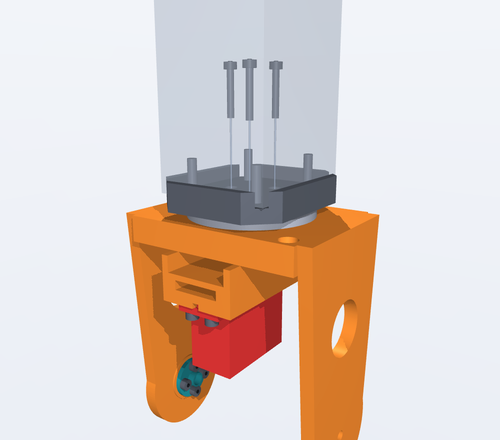
docs/img_v6/c8.png
