danbita/real-steel/docs/img_v6/d1.gif

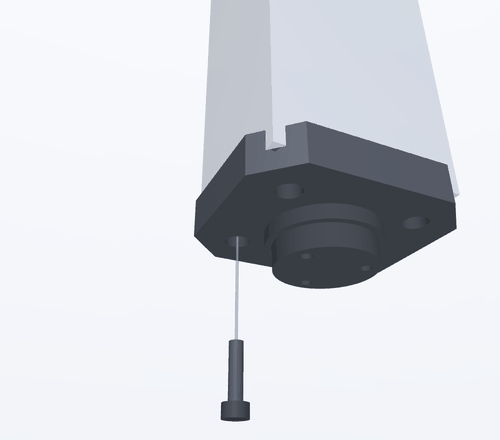
docs/img_v6/d1.gif
