danbita/real-steel/docs/img_v6/d1.png

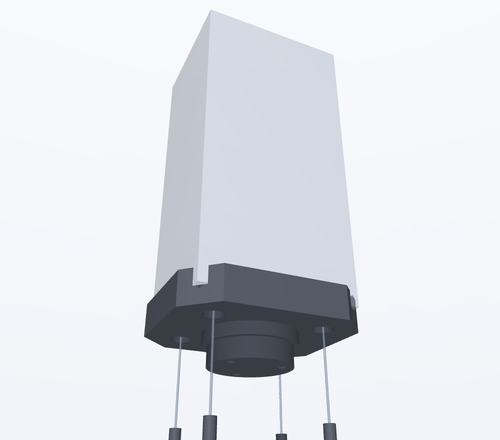
docs/img_v6/d1.png
