danbita/real-steel/docs/img_v6/drive.gif

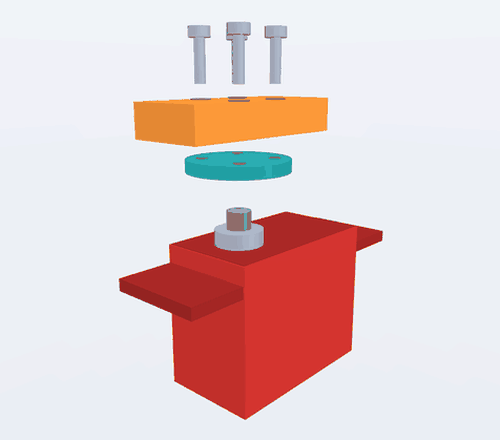
docs/img_v6/drive.gif
