danbita/real-steel/docs/img_v6/drive.png

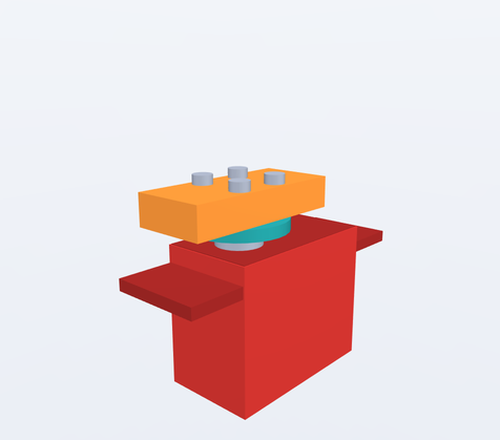
docs/img_v6/drive.png
