danbita/real-steel/docs/img_v6/drive_t.png

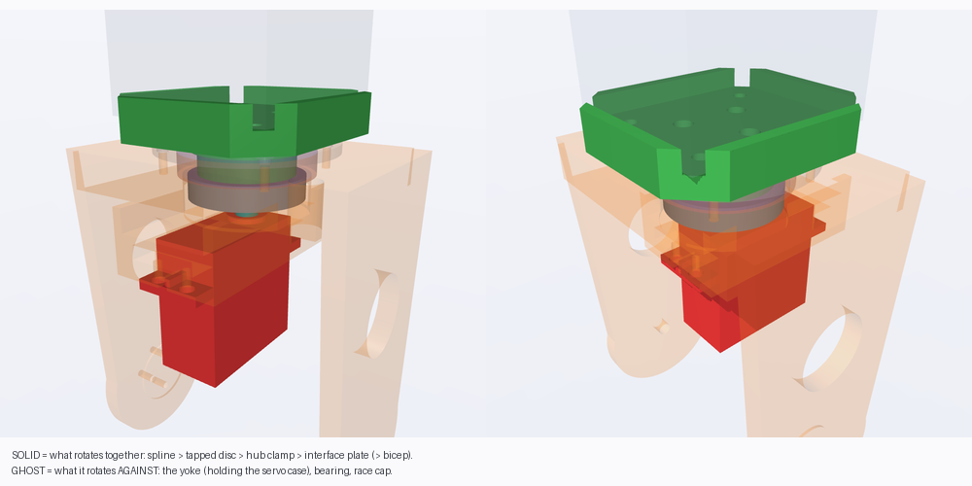
docs/img_v6/drive_t.png
