danbita/real-steel/docs/img_v6/f1.gif

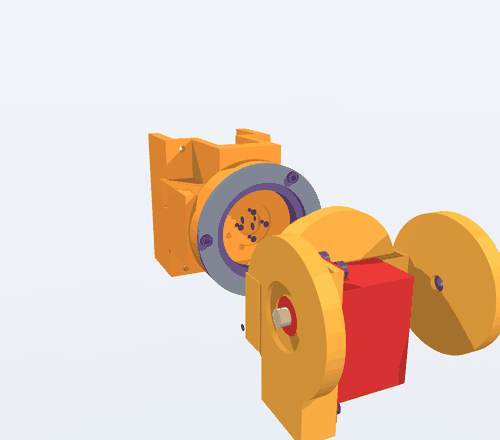
docs/img_v6/f1.gif
