danbita/real-steel/docs/img_v6/f1.png

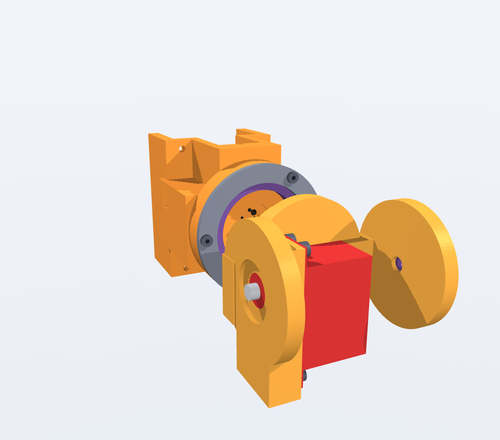
docs/img_v6/f1.png
