danbita/real-steel/docs/img_v6/f2.gif

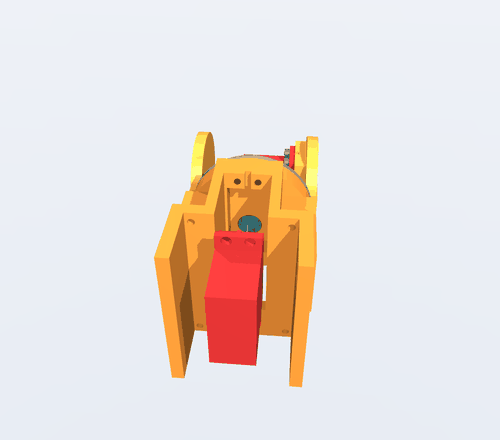
docs/img_v6/f2.gif
