danbita/real-steel/docs/img_v6/f3.gif

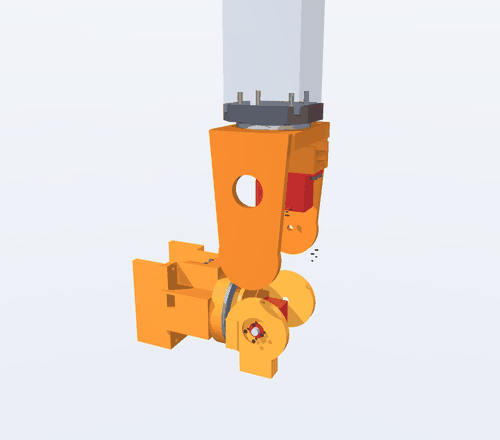
docs/img_v6/f3.gif
