danbita/real-steel/docs/img_v6/f4.gif

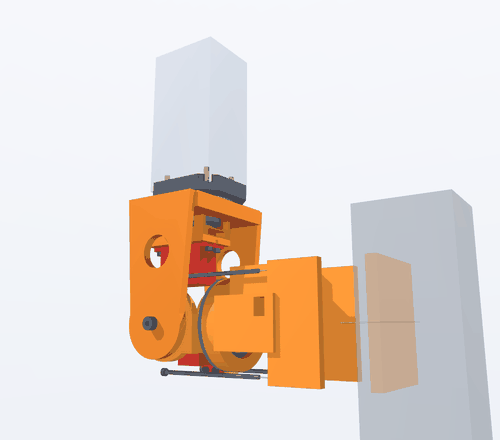
docs/img_v6/f4.gif
