danbita/real-steel/docs/img_v6/hero.gif

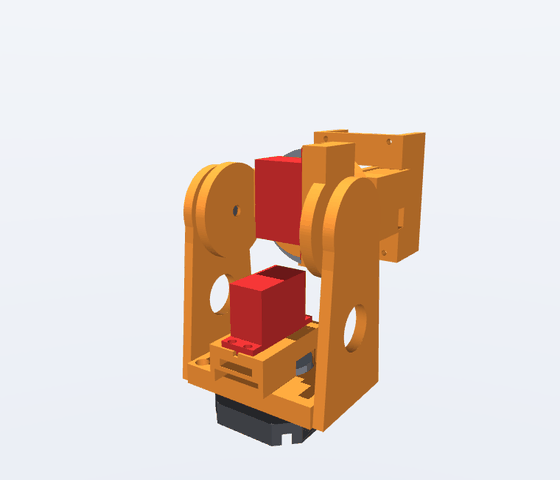
docs/img_v6/hero.gif
