danbita/real-steel/docs/img_v6/inserts.gif

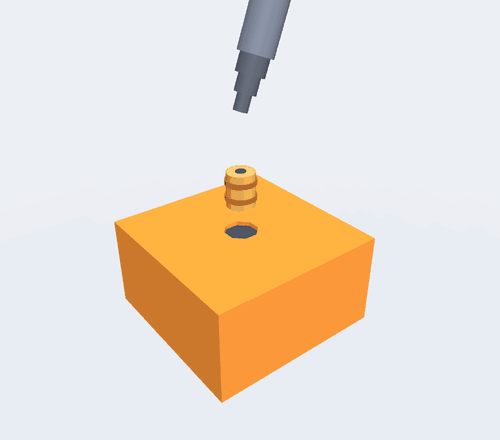
docs/img_v6/inserts.gif
