danbita/real-steel/docs/img_v6/inserts.png

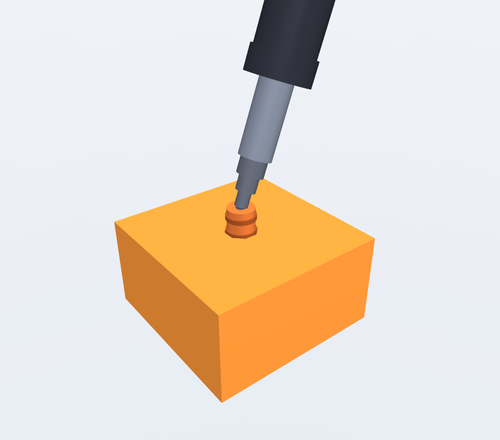
docs/img_v6/inserts.png
