danbita/real-steel/docs/img_v6/legend.png

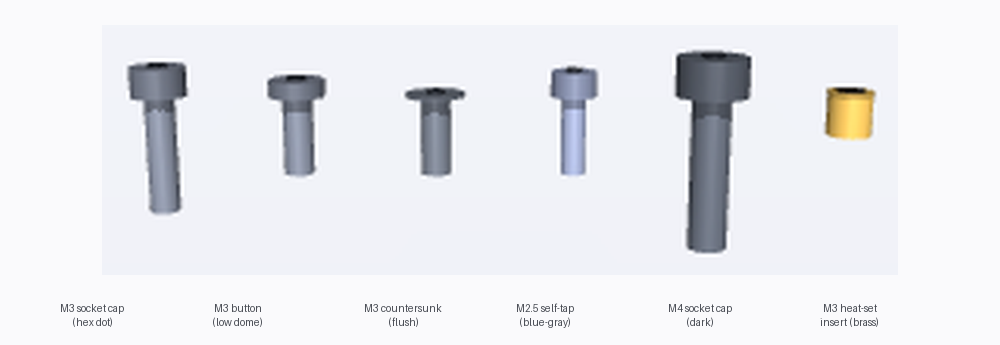
docs/img_v6/legend.png
