danbita/real-steel/docs/img_v6/p1.gif

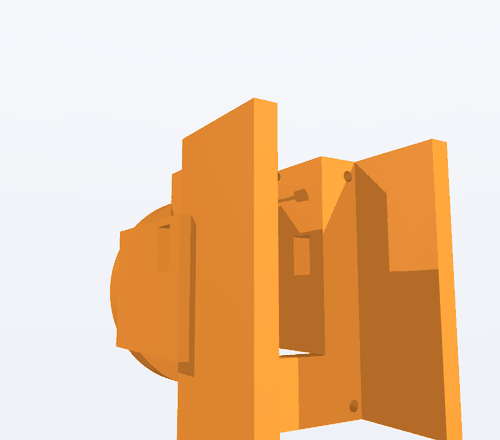
docs/img_v6/p1.gif
