danbita/real-steel/docs/img_v6/p1.png

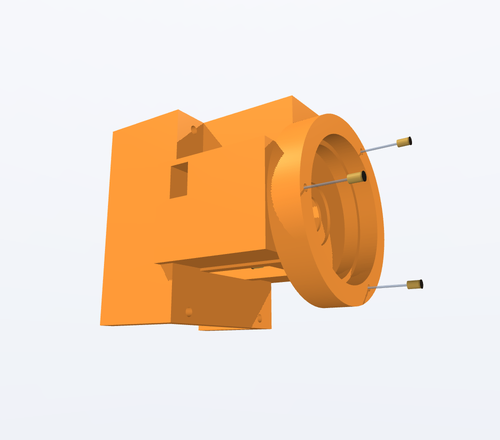
docs/img_v6/p1.png
