danbita/real-steel/docs/img_v6/p2.gif

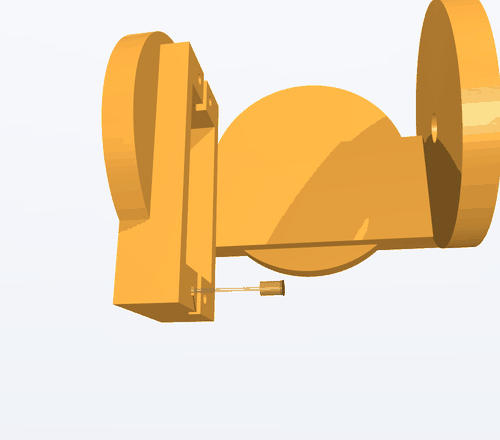
docs/img_v6/p2.gif
