danbita/real-steel/docs/img_v6/p2.png

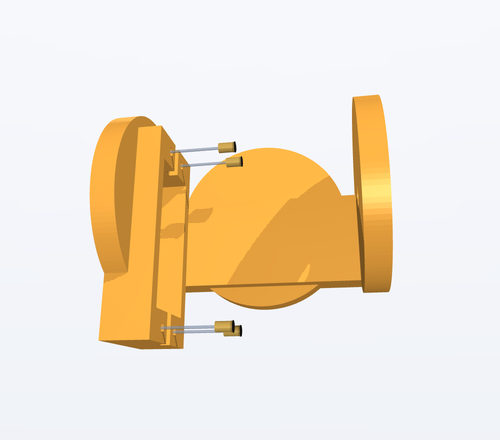
docs/img_v6/p2.png
