danbita/real-steel/docs/img_v6/p3.gif

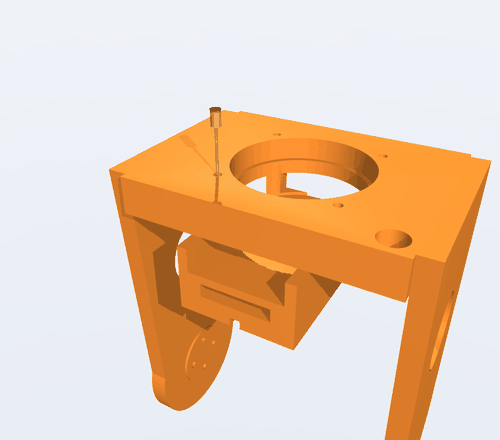
docs/img_v6/p3.gif
