danbita/real-steel/docs/img_v6/p3.png

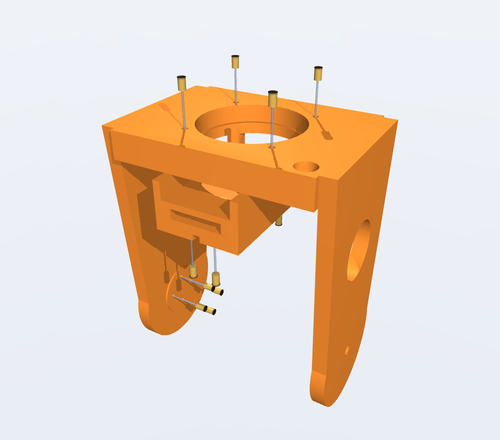
docs/img_v6/p3.png
