danbita/real-steel/docs/img_v6/p4.gif

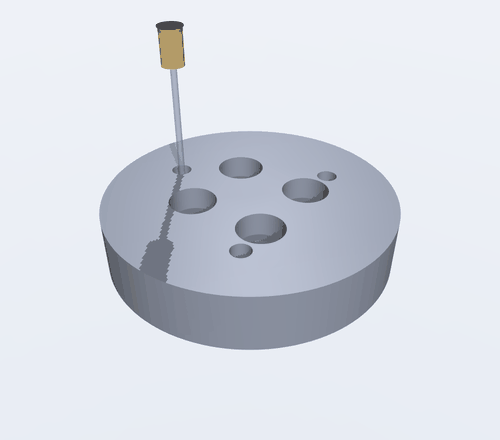
docs/img_v6/p4.gif
