danbita/real-steel/docs/img_v6/p4.png

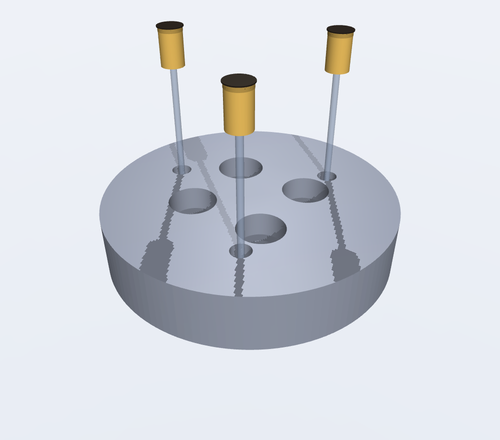
docs/img_v6/p4.png
