danbita/real-steel/docs/img_v6/part_bicep_ref.png

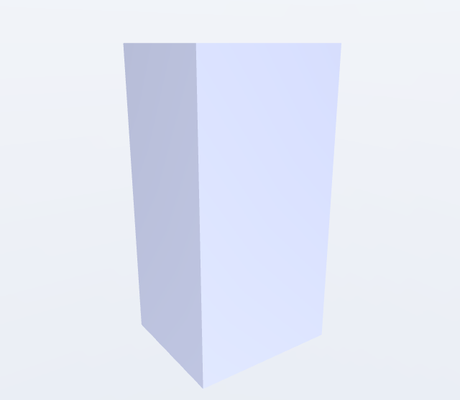
docs/img_v6/part_bicep_ref.png
