danbita/real-steel/docs/img_v6/part_carrier.png

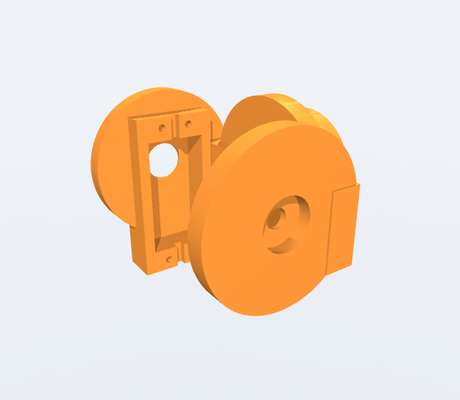
docs/img_v6/part_carrier.png
