danbita/real-steel/docs/img_v6/part_interface_plate.png

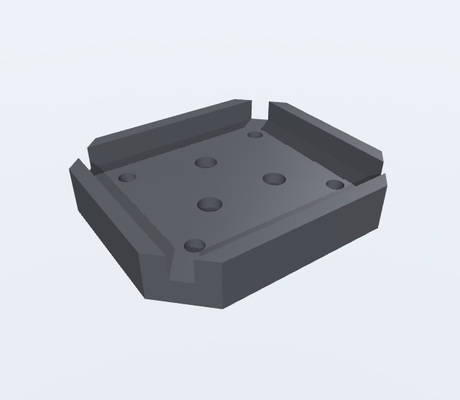
docs/img_v6/part_interface_plate.png
