danbita/real-steel/docs/img_v6/part_mount.png

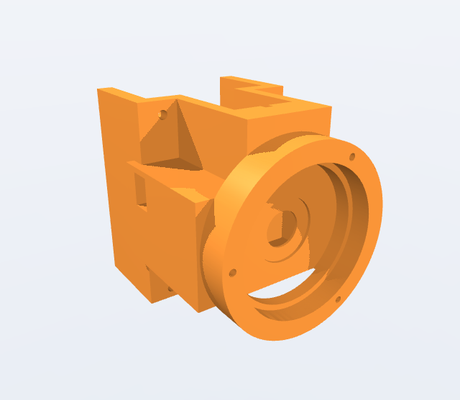
docs/img_v6/part_mount.png
