danbita/real-steel/docs/img_v6/part_pitch_retainer.png

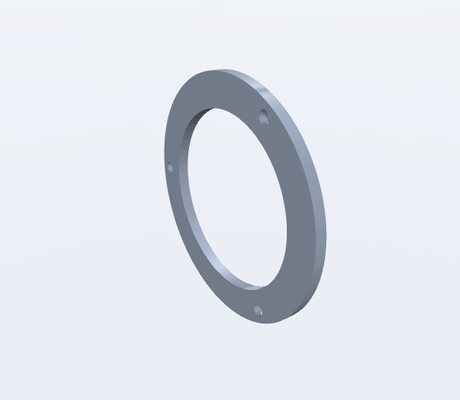
docs/img_v6/part_pitch_retainer.png
