danbita/real-steel/docs/img_v6/part_race_cap.png

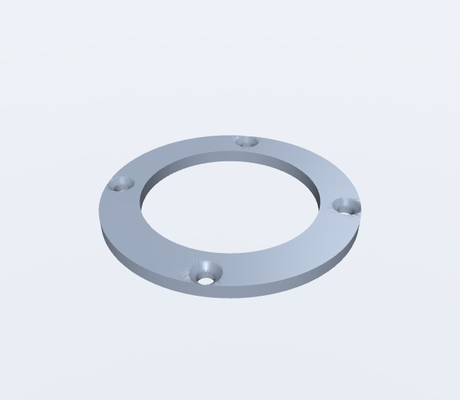
docs/img_v6/part_race_cap.png
