danbita/real-steel/docs/img_v6/part_rings.png

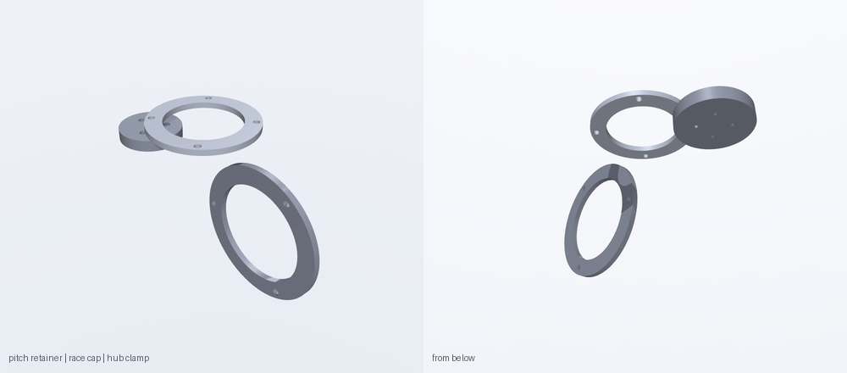
docs/img_v6/part_rings.png
