danbita/real-steel/docs/img_v6/part_roll_idler.png

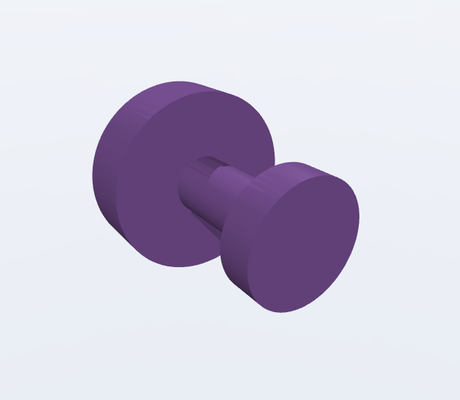
docs/img_v6/part_roll_idler.png
