danbita/real-steel/docs/img_v6/part_yoke.png

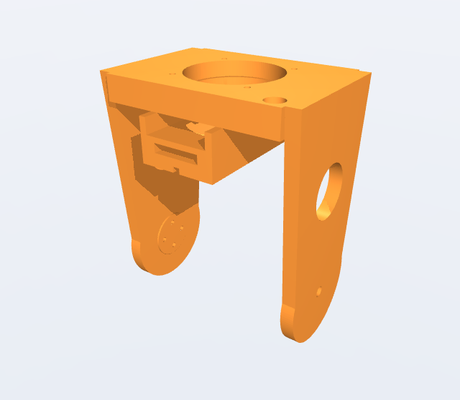
docs/img_v6/part_yoke.png
