danbita/real-steel/docs/img_v6/short_stack_preview.png

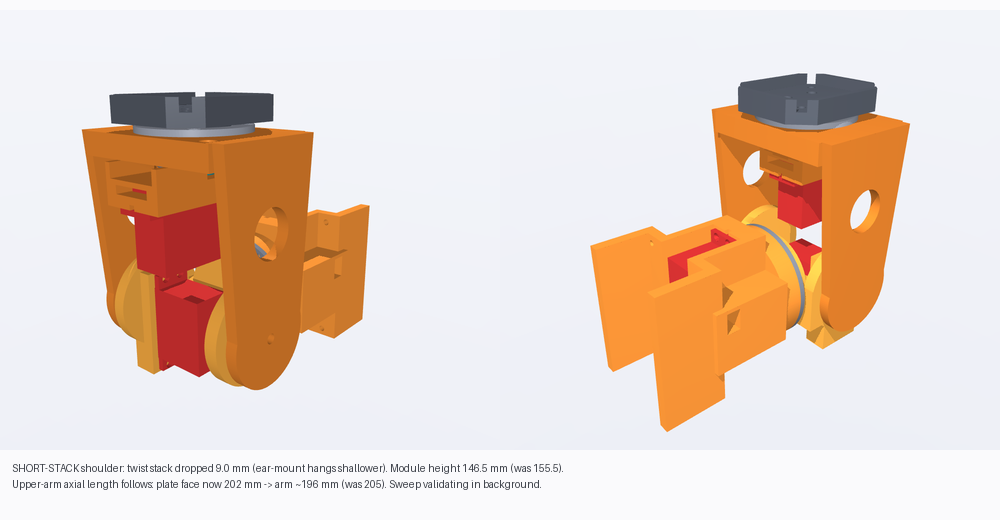
docs/img_v6/short_stack_preview.png
