danbita/real-steel/docs/img_v6/twist_brg.gif

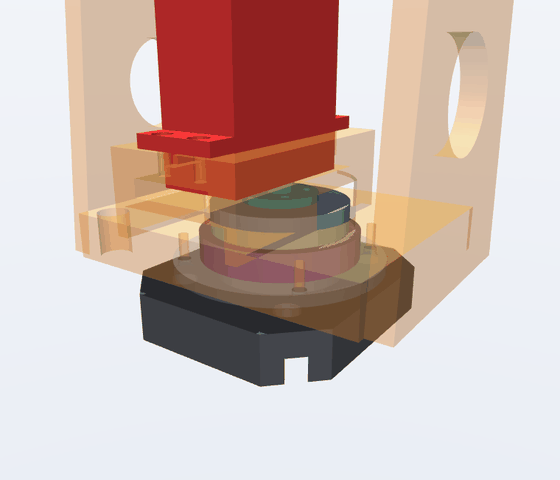
docs/img_v6/twist_brg.gif
