danbita/real-steel/live mimic system/meshes36d/atom_head.png

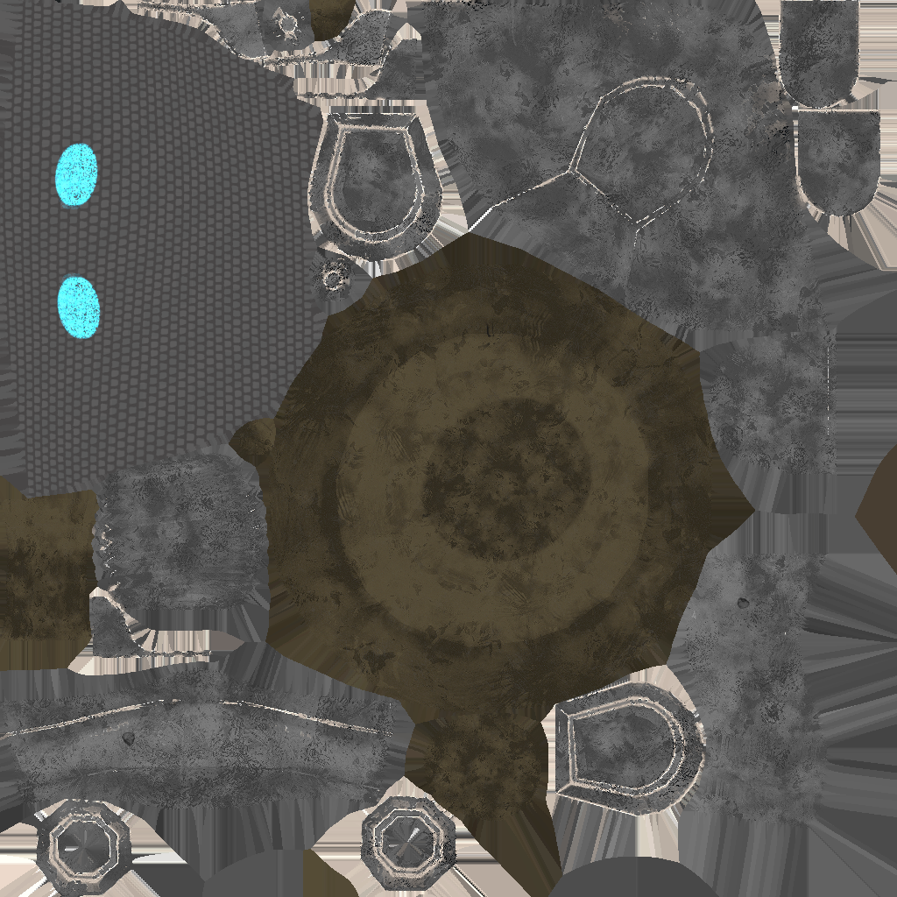
live mimic system/meshes36d/atom_head.png
