danbita/real-steel/cad/shoulder_v6/right/shoulder_assembly.step

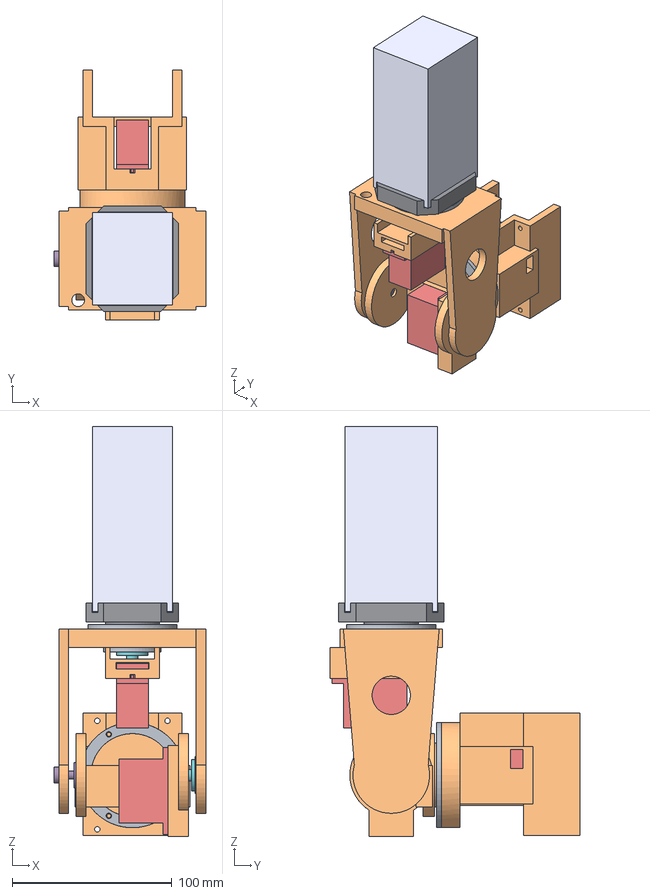
[picture p119: CAD file, 2026-08-21]
cad/shoulder_v6/right/shoulder_assembly.step
95.0 x 156.9 x 257.0 mm
mount
pitch_retainer
servoP_body
servoP_shaft
carrier
servoR_body
servoR_shaft
yoke
roll_idler
brg_pitch
idler625
brg_twist
race_cap
hub_clamp
servoT_body
servoT_shaft
interface_plate
bicep_ref
