danbita/real-steel/cad/shoulder_v6/right/carrier.step

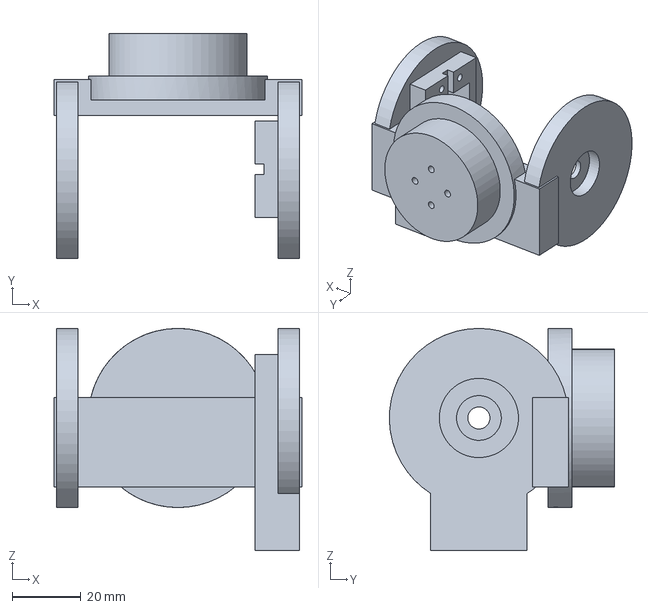
[picture p120: CAD file, 2026-08-21]
cad/shoulder_v6/right/carrier.step
72.0 x 65.4 x 64.5 mm
