danbita/real-steel/cad/shoulder_v6/servoP_body.step

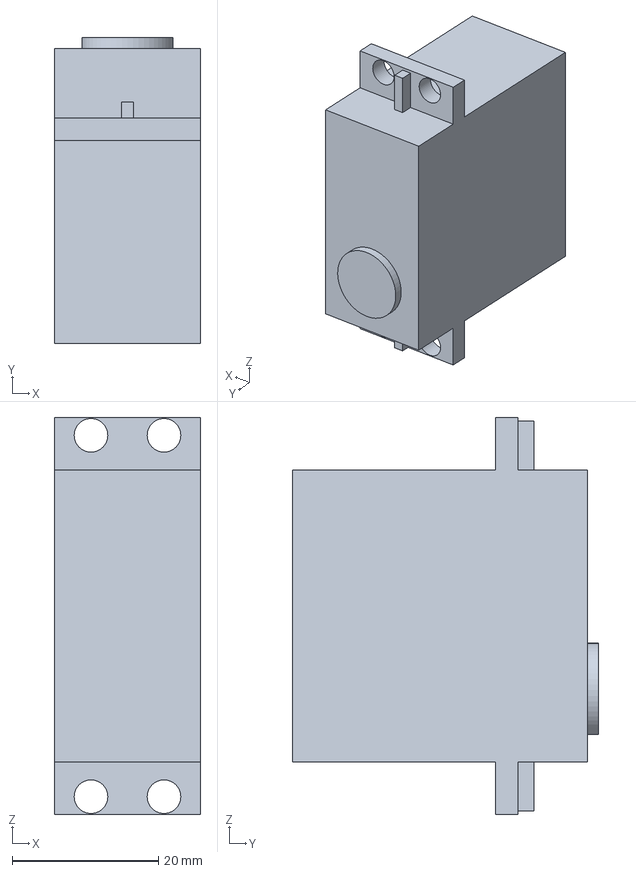
[picture p121: CAD file, 2026-08-21]
cad/shoulder_v6/servoP_body.step
20.0 x 41.9 x 54.4 mm
