danbita/real-steel/live mimic system/meshes/bicep_Link.STL

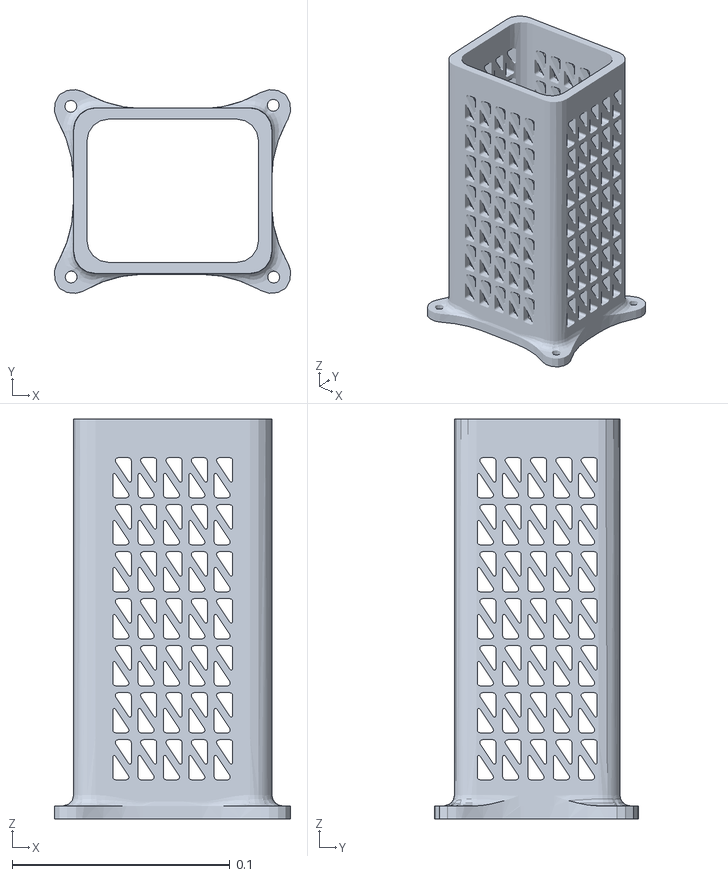
[picture p122: CAD file, 2026-08-21]
live mimic system/meshes/bicep_Link.STL
0.109 x 0.0936 x 0.184
