danbita/real-steel/live mimic system/meshes/shoulder/pivot_gear.stl

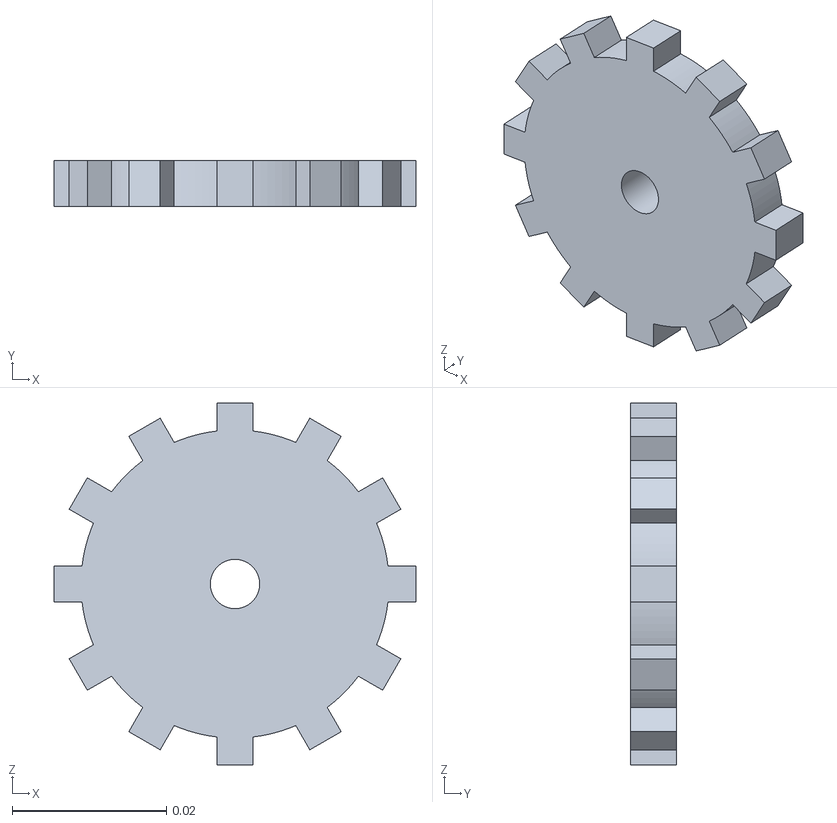
[picture p123: CAD file, 2026-08-21]
live mimic system/meshes/shoulder/pivot_gear.stl
0.047 x 0.006 x 0.047
