danbita/real-steel/live mimic system/meshes/shoulder_v3/carrier_r.stl

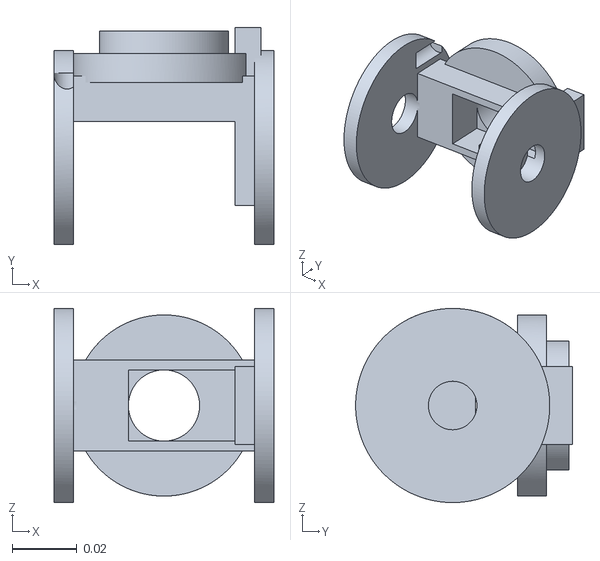
[picture p124: CAD file, 2026-08-21]
live mimic system/meshes/shoulder_v3/carrier_r.stl
0.068 x 0.067 x 0.06
