danbita/real-steel/live mimic system/meshes36/shoulder_v3/servoR_body.stl

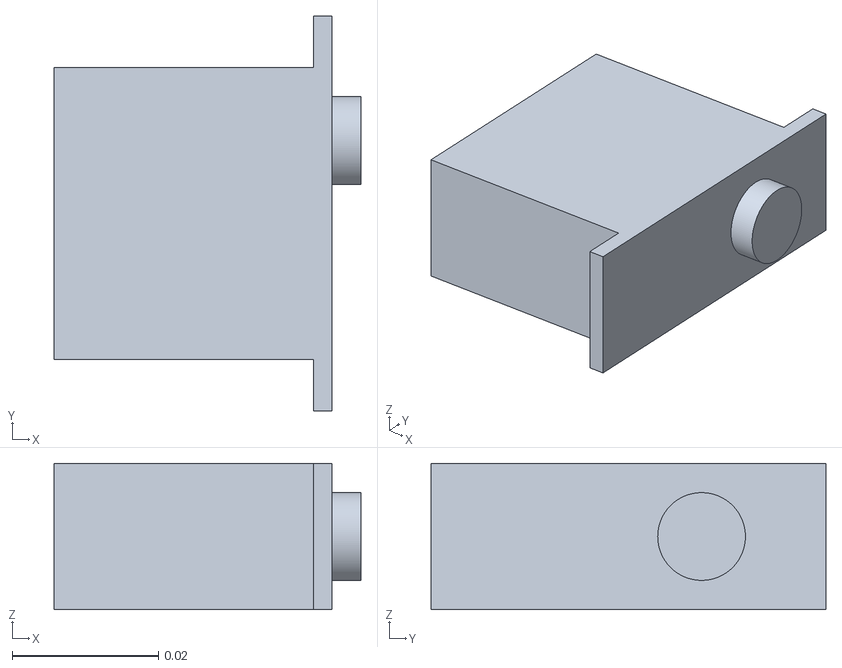
[picture p126: CAD file, 2026-08-21]
live mimic system/meshes36/shoulder_v3/servoR_body.stl
0.042 x 0.054 x 0.02
