danbita/real-steel/live mimic system/meshes36b/short_arm_link.STL

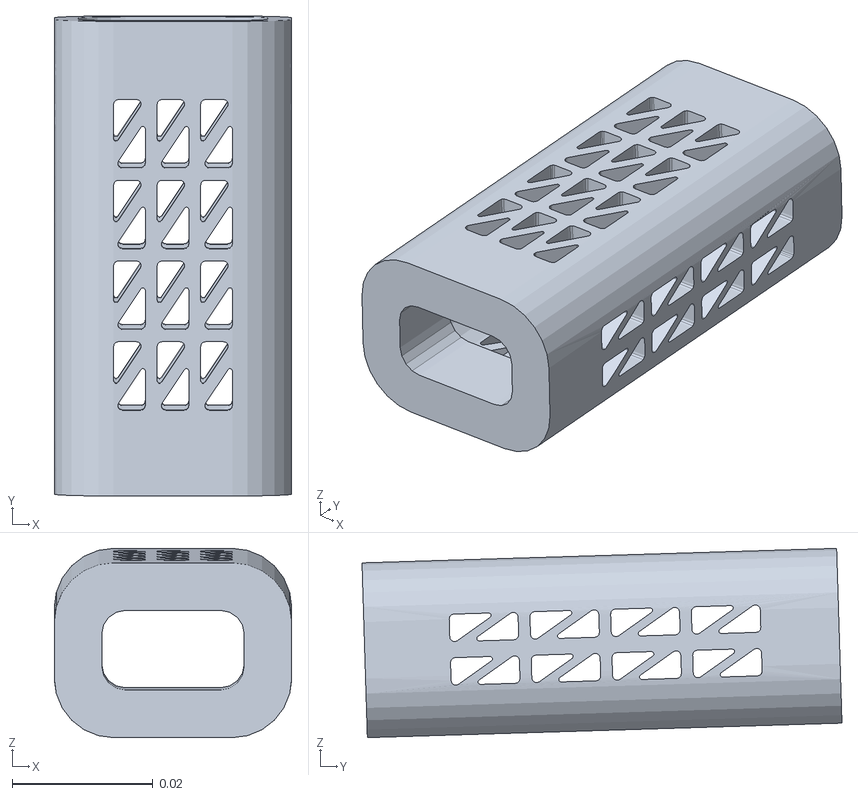
[picture p127: CAD file, 2026-08-21]
live mimic system/meshes36b/short_arm_link.STL
0.0337 x 0.0682 x 0.0269
