danbita/real-steel/live mimic system/meshes36b/shoulder_v4/servoR_body.stl

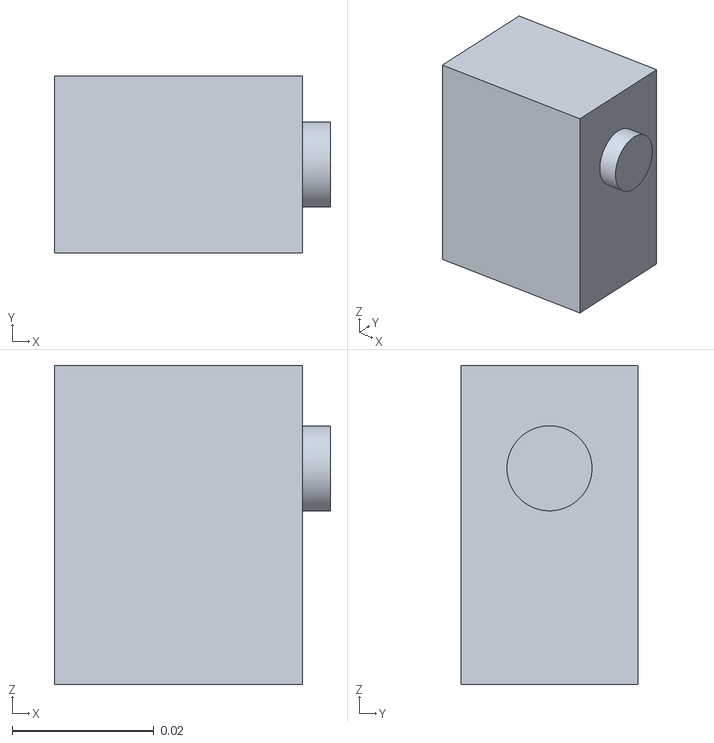
[picture p128: CAD file, 2026-08-21]
live mimic system/meshes36b/shoulder_v4/servoR_body.stl
0.039 x 0.025 x 0.045
