danbita/real-steel/live mimic system/meshes36c/shoulder_v5/servoT_shaft_r.stl

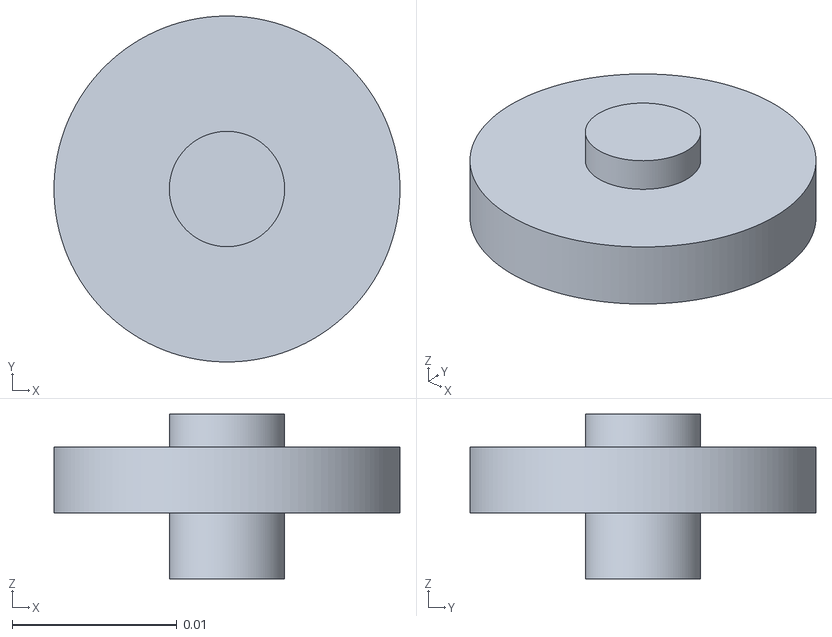
[picture p129: CAD file, 2026-08-21]
live mimic system/meshes36c/shoulder_v5/servoT_shaft_r.stl
0.021 x 0.021 x 0.01
