danbita/real-steel/live mimic system/meshes36d/bicep_Link.STL

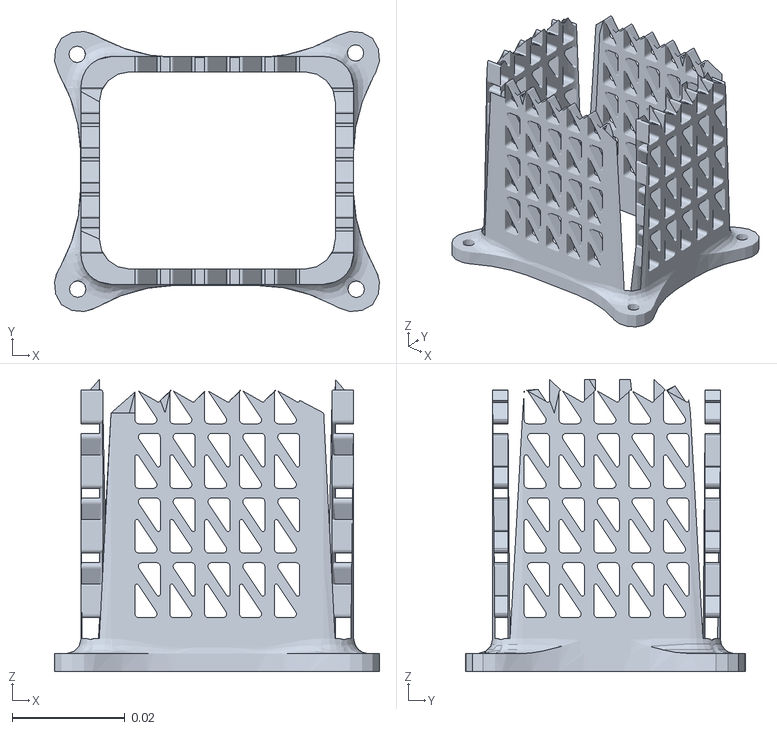
[picture p130: CAD file, 2026-08-21]
live mimic system/meshes36d/bicep_Link.STL
0.0577 x 0.0497 x 0.0518
