danbita/real-steel/live mimic system/meshes36d/shoulder_v6/servoR_shaft.stl

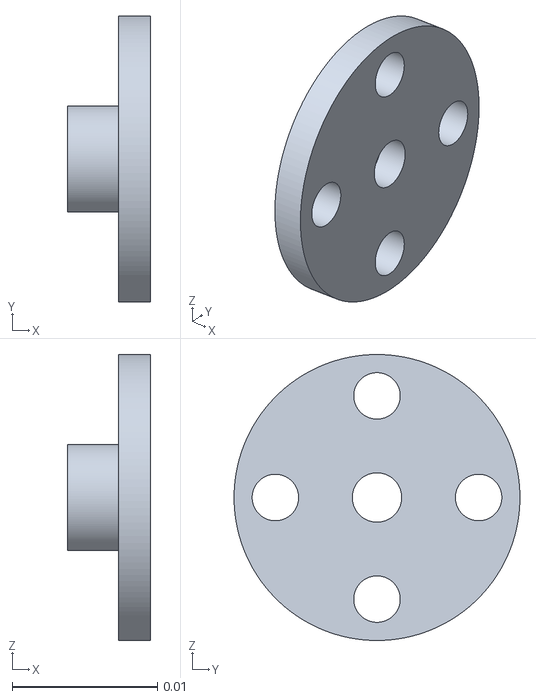
[picture p131: CAD file, 2026-08-21]
live mimic system/meshes36d/shoulder_v6/servoR_shaft.stl
0.0057 x 0.0197 x 0.0197
