danbita/real-steel/cad/shoulder_v6/brg_pitch.step

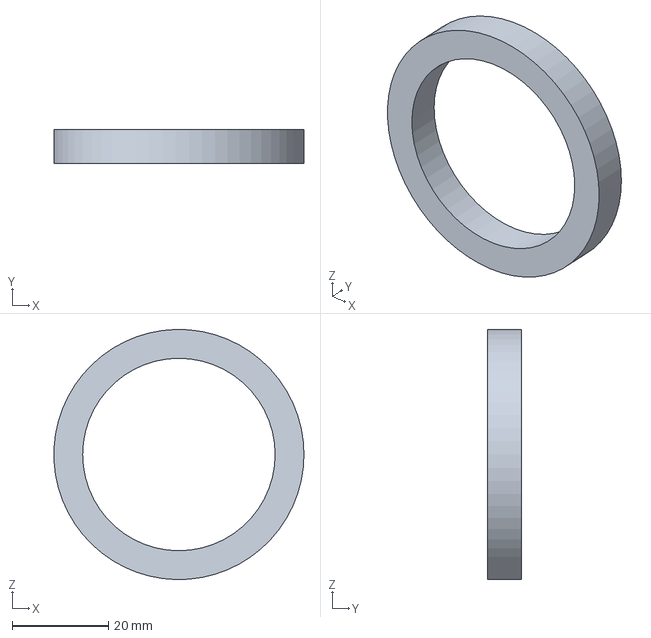
[picture p132: CAD file, 2026-08-21]
cad/shoulder_v6/brg_pitch.step
52.0 x 7.00 x 52.0 mm
