danbita/real-steel/cad/shoulder_v6/right/yoke.step

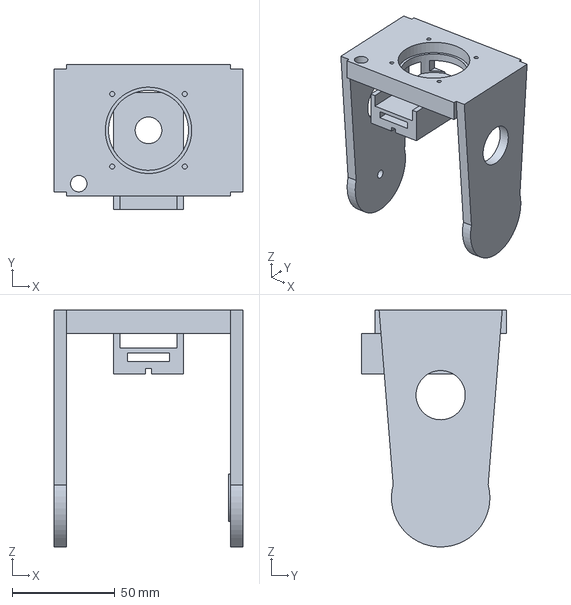
[picture p133: CAD file, 2026-08-21]
cad/shoulder_v6/right/yoke.step
92.0 x 70.5 x 115.5 mm
