danbita/real-steel/live mimic system/meshes/shoulder/turntable.stl

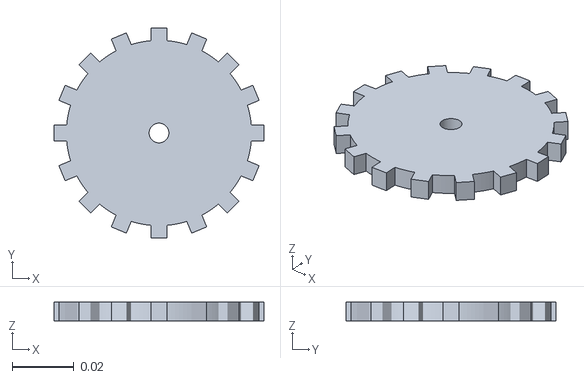
[picture p134: CAD file, 2026-08-21]
live mimic system/meshes/shoulder/turntable.stl
0.068 x 0.068 x 0.006
