danbita/real-steel/live mimic system/meshes/shoulder_v3/hub_collar.stl

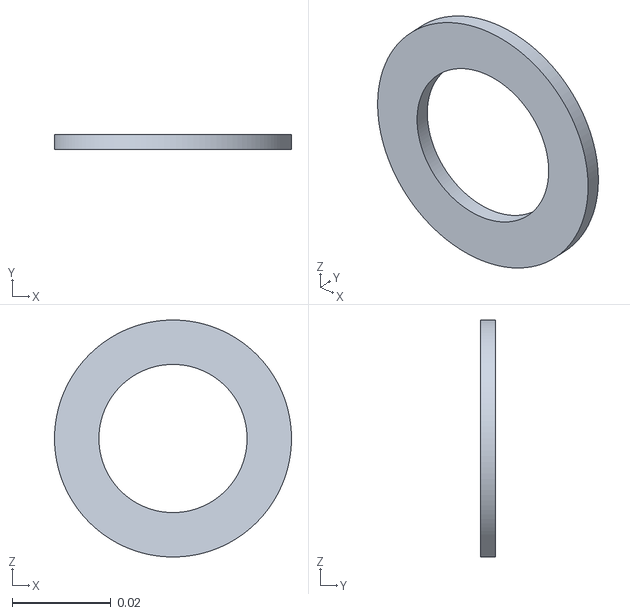
[picture p135: CAD file, 2026-08-21]
live mimic system/meshes/shoulder_v3/hub_collar.stl
0.048 x 0.003 x 0.048
