danbita/real-steel/live mimic system/meshes/small_gear_Link.STL

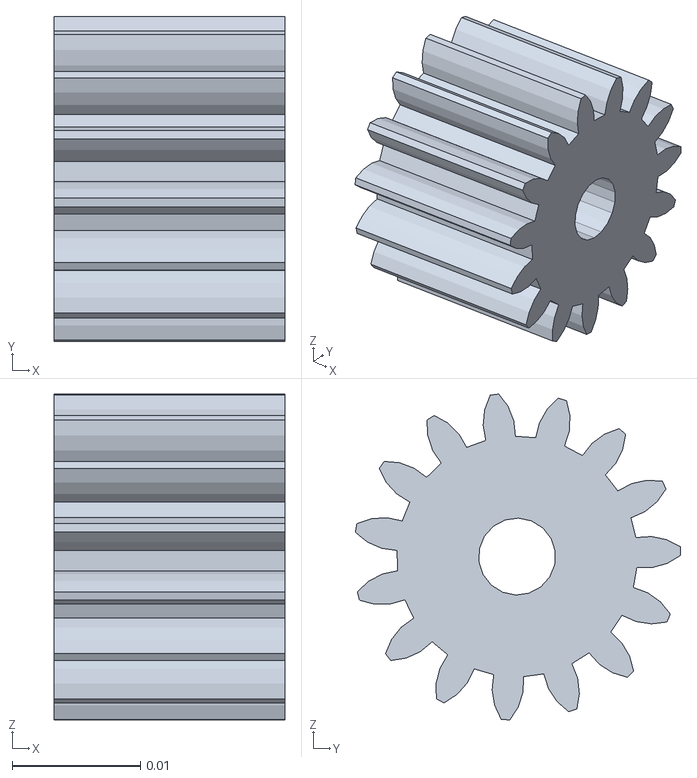
[picture p136: CAD file, 2026-08-21]
live mimic system/meshes/small_gear_Link.STL
0.018 x 0.0254 x 0.0254
