danbita/real-steel/live mimic system/meshes36/shoulder_v3/servoR_shaft_r.stl

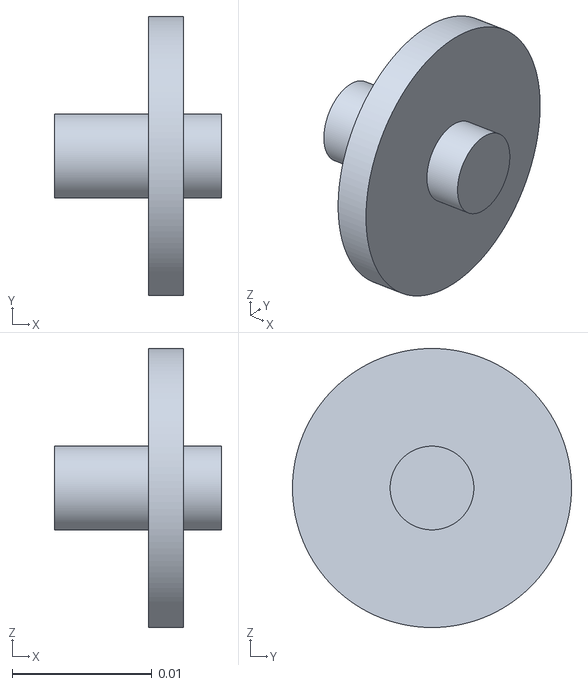
[picture p138: CAD file, 2026-08-21]
live mimic system/meshes36/shoulder_v3/servoR_shaft_r.stl
0.012 x 0.02 x 0.02
