danbita/real-steel/live mimic system/meshes36b/shoulder_v4/carrier_r.stl

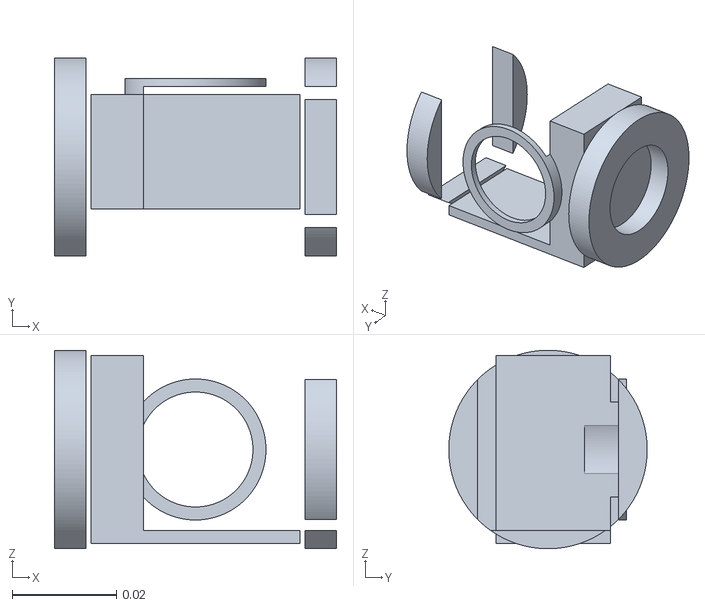
[picture p139: CAD file, 2026-08-21]
live mimic system/meshes36b/shoulder_v4/carrier_r.stl
0.054 x 0.038 x 0.038
