danbita/real-steel/live mimic system/meshes36c/big_gear_Link.STL

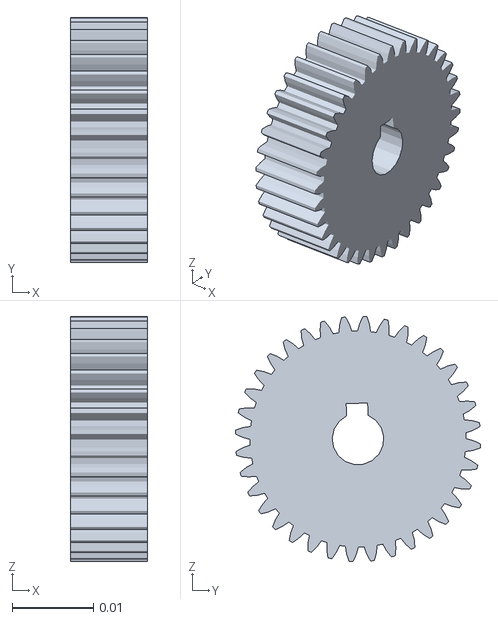
[picture p140: CAD file, 2026-08-21]
live mimic system/meshes36c/big_gear_Link.STL
0.00956 x 0.0302 x 0.0302
