danbita/real-steel/live mimic system/meshes36c/shoulder_v5/servoP_body.stl

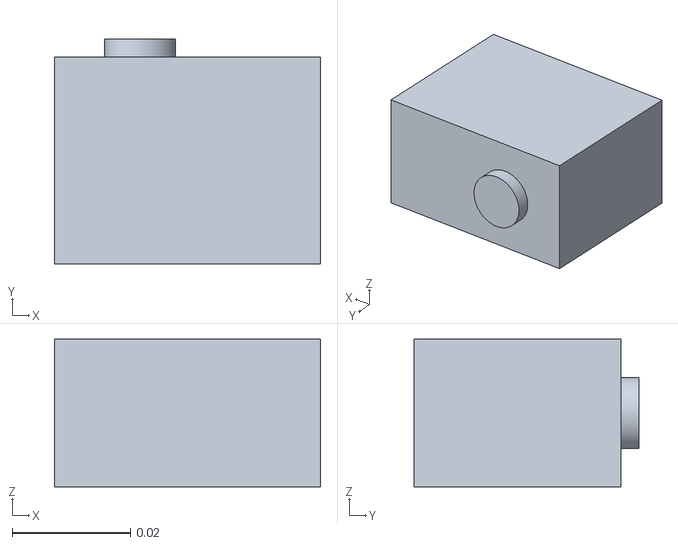
[picture p141: CAD file, 2026-08-21]
live mimic system/meshes36c/shoulder_v5/servoP_body.stl
0.045 x 0.038 x 0.025
