danbita/real-steel/live mimic system/meshes36d/shoulder_v6/race_cap.stl

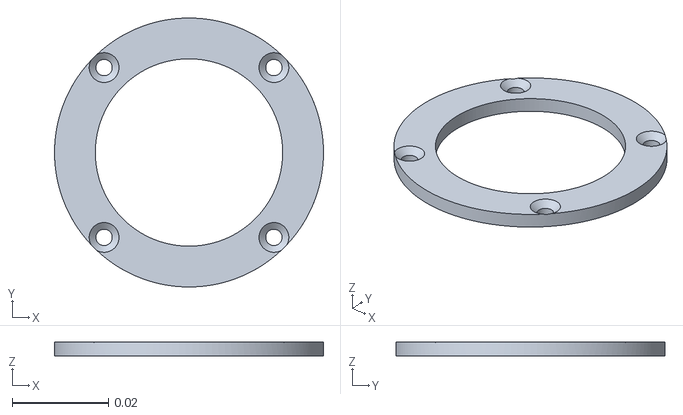
[picture p142: CAD file, 2026-08-21]
live mimic system/meshes36d/shoulder_v6/race_cap.stl
0.056 x 0.056 x 0.003
