danbita/real-steel/cad/shoulder_v6/brg_twist.step

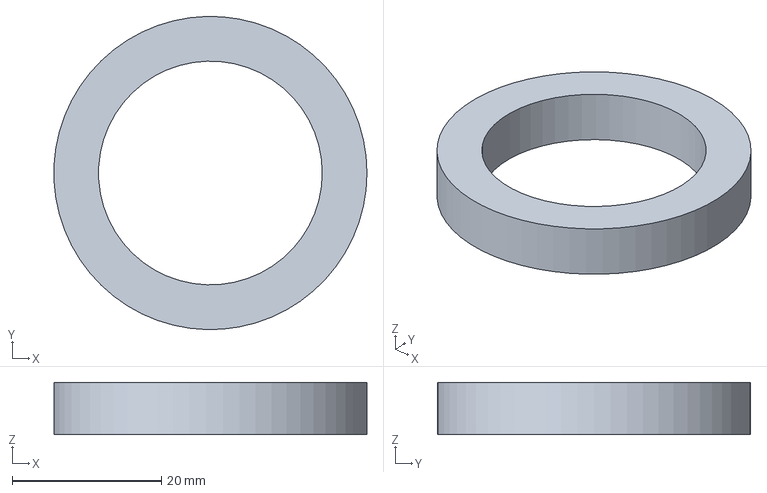
[picture p143: CAD file, 2026-08-21]
cad/shoulder_v6/brg_twist.step
42.0 x 42.0 x 7.00 mm
