danbita/real-steel/cad/shoulder_v6/right/servoP_shaft.step

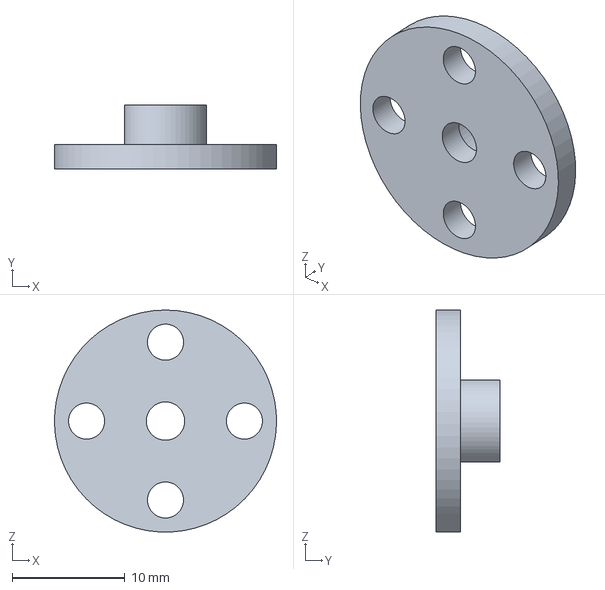
[picture p144: CAD file, 2026-08-21]
cad/shoulder_v6/right/servoP_shaft.step
19.7 x 5.70 x 19.7 mm
