danbita/real-steel/live mimic system/meshes/elbow_Link.STL

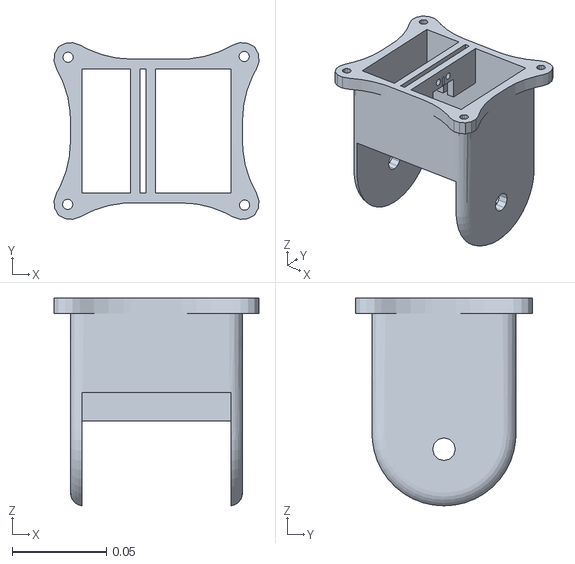
[picture p145: CAD file, 2026-08-21]
live mimic system/meshes/elbow_Link.STL
0.109 x 0.0936 x 0.11
