danbita/real-steel/live mimic system/meshes/shoulder/housing.stl

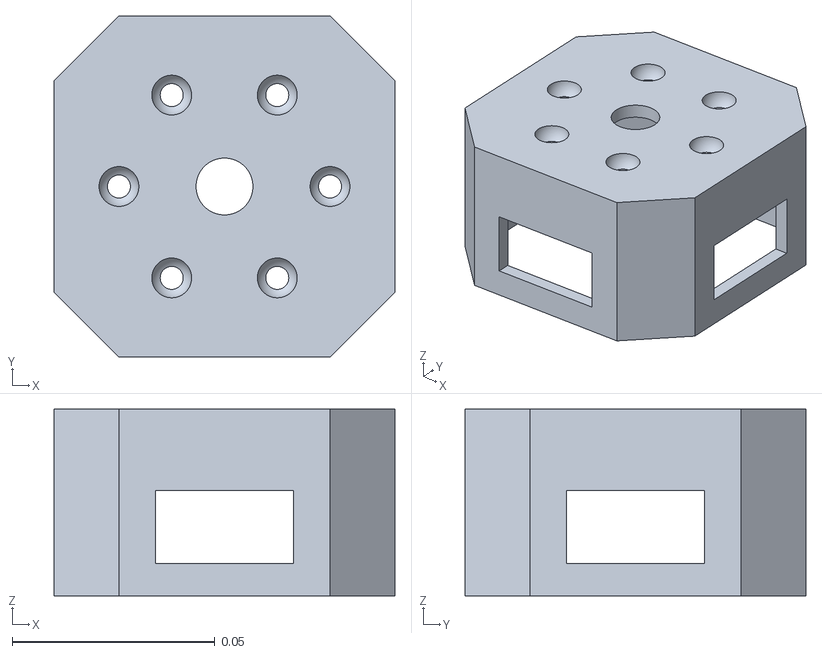
[picture p146: CAD file, 2026-08-21]
live mimic system/meshes/shoulder/housing.stl
0.084 x 0.084 x 0.046
