danbita/real-steel/live mimic system/meshes/shoulder_v3/servoP_shaft_r.stl

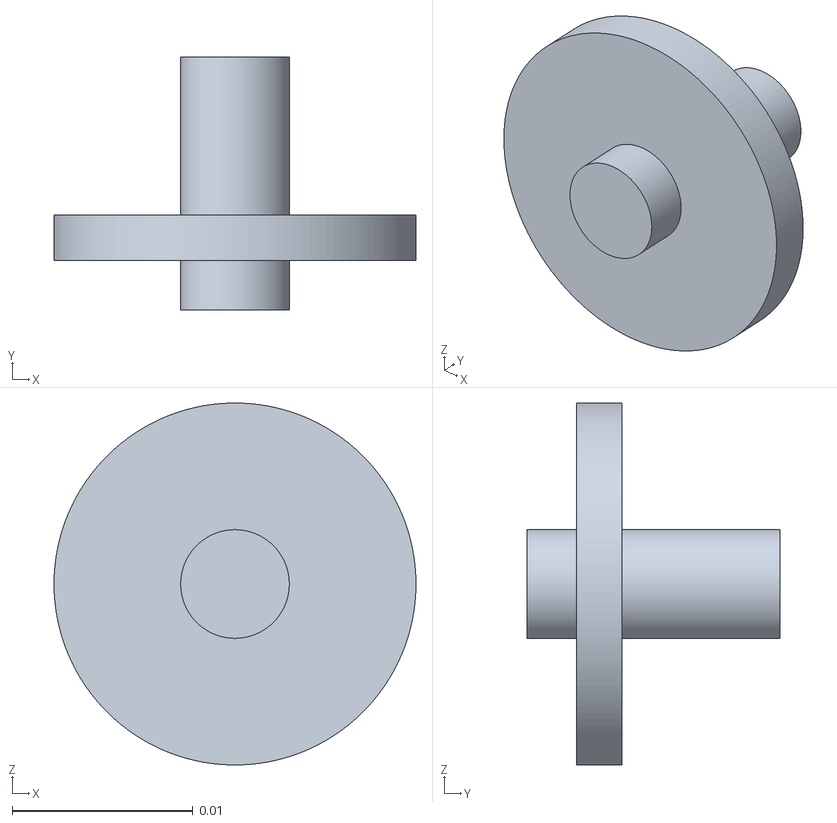
[picture p147: CAD file, 2026-08-21]
live mimic system/meshes/shoulder_v3/servoP_shaft_r.stl
0.02 x 0.014 x 0.02
