danbita/real-steel/live mimic system/meshes36/shoulder_v3/yoke.stl

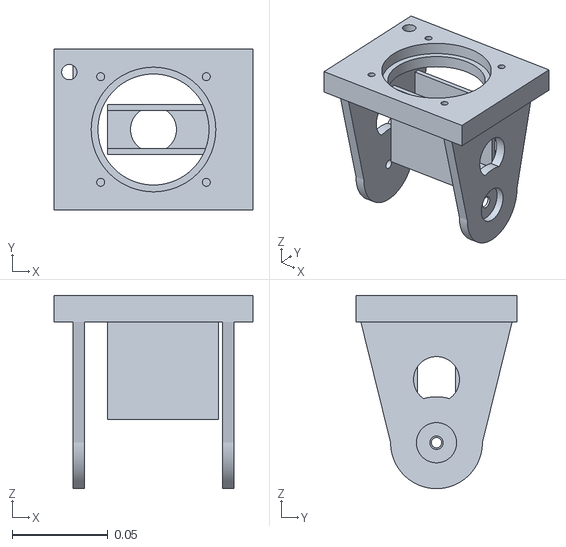
[picture p148: CAD file, 2026-08-21]
live mimic system/meshes36/shoulder_v3/yoke.stl
0.104 x 0.084 x 0.101
