danbita/real-steel/live mimic system/meshes36c/bicep_Link.STL

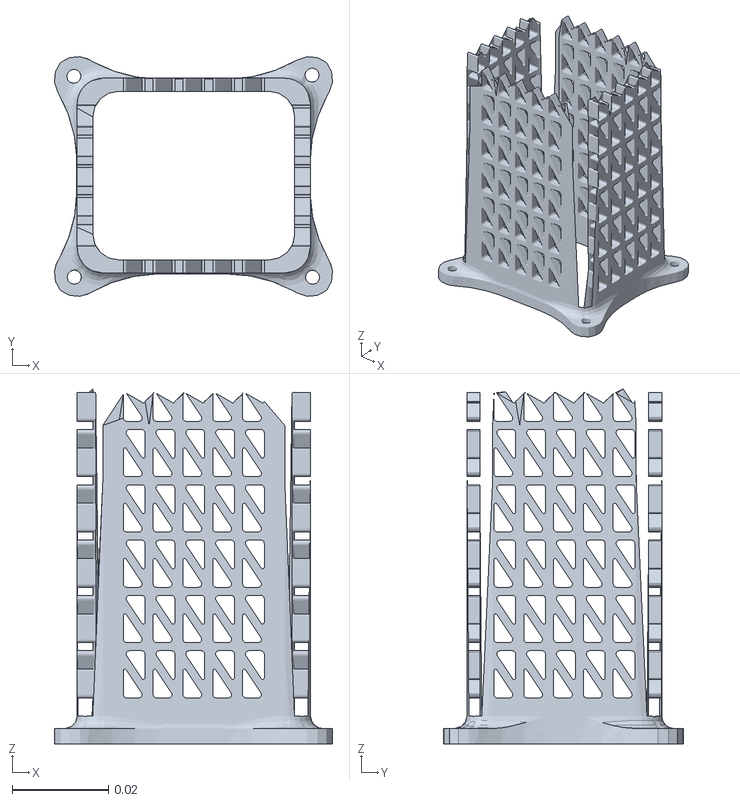
[picture p149: CAD file, 2026-08-21]
live mimic system/meshes36c/bicep_Link.STL
0.0577 x 0.0497 x 0.0736
