danbita/real-steel/live mimic system/meshes36d/shoulder_v6/interface_plate.stl

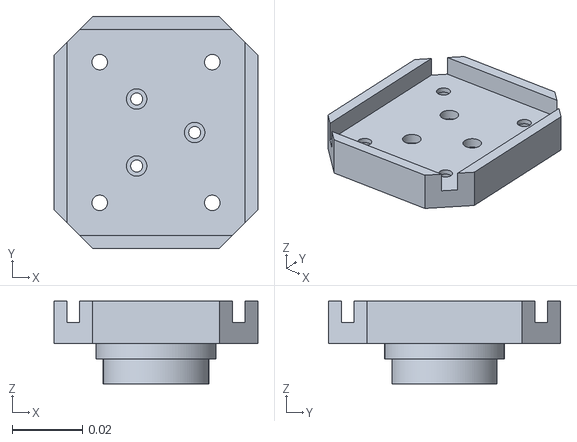
[picture p150: CAD file, 2026-08-21]
live mimic system/meshes36d/shoulder_v6/interface_plate.stl
0.058 x 0.066 x 0.0235
