danbita/real-steel/live mimic system/meshes36d/small_gear_Link.STL

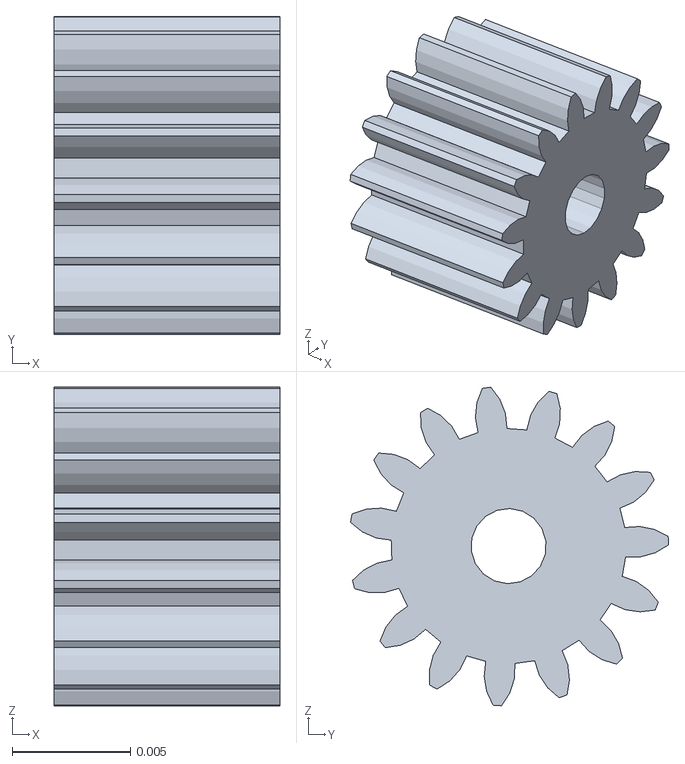
[picture p151: CAD file, 2026-08-21]
live mimic system/meshes36d/small_gear_Link.STL
0.00956 x 0.0135 x 0.0135
