danbita/real-steel/cad/shoulder_v6/race_cap.step

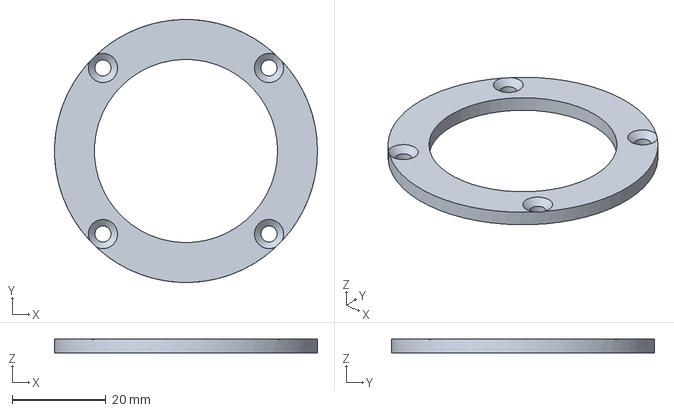
[picture p152: CAD file, 2026-08-21]
cad/shoulder_v6/race_cap.step
56.0 x 56.0 x 3.00 mm
