danbita/real-steel/live mimic system/meshes/big_gear_Link.STL

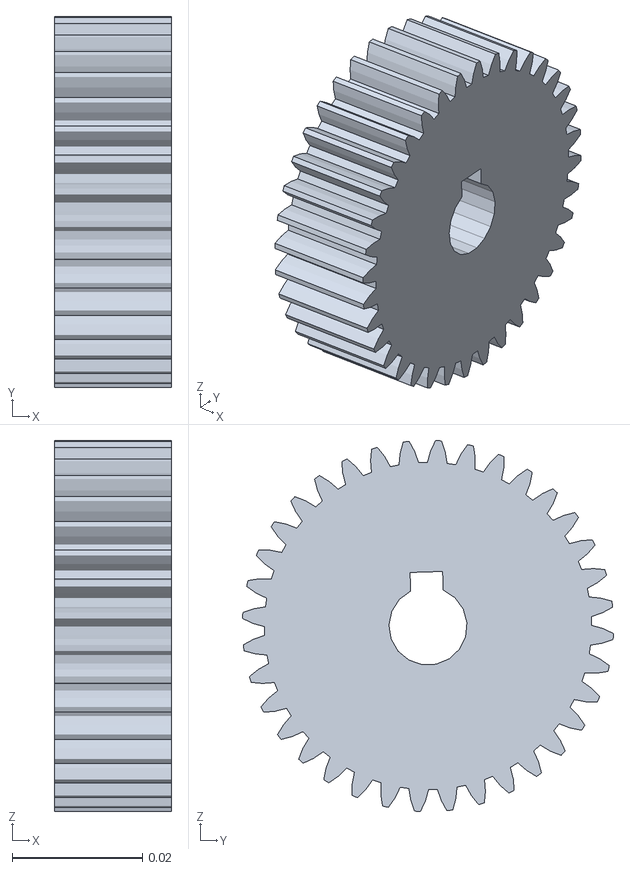
[picture p153: CAD file, 2026-08-21]
live mimic system/meshes/big_gear_Link.STL
0.018 x 0.057 x 0.057
