danbita/real-steel/live mimic system/meshes/shoulder/arm.stl

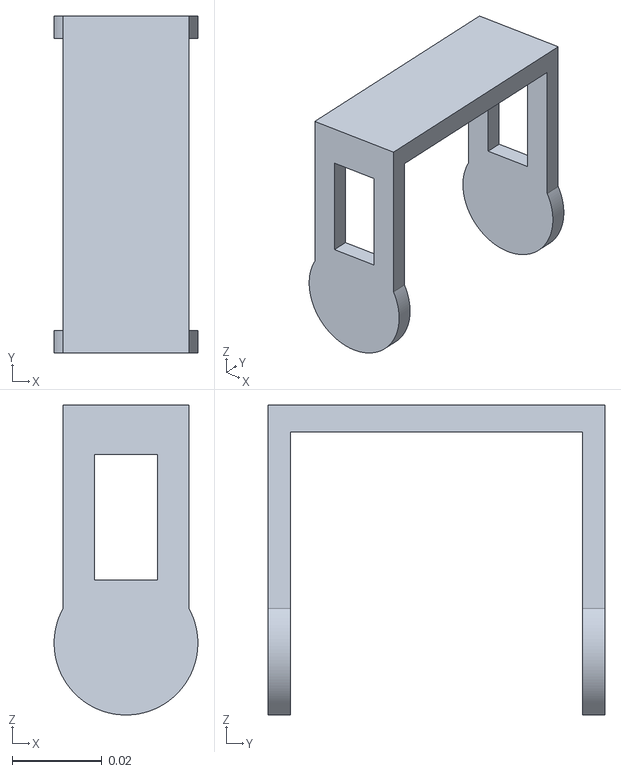
[picture p154: CAD file, 2026-08-21]
live mimic system/meshes/shoulder/arm.stl
0.032 x 0.075 x 0.069
