danbita/real-steel/live mimic system/meshes36b/shoulder_v4/mount_r.stl

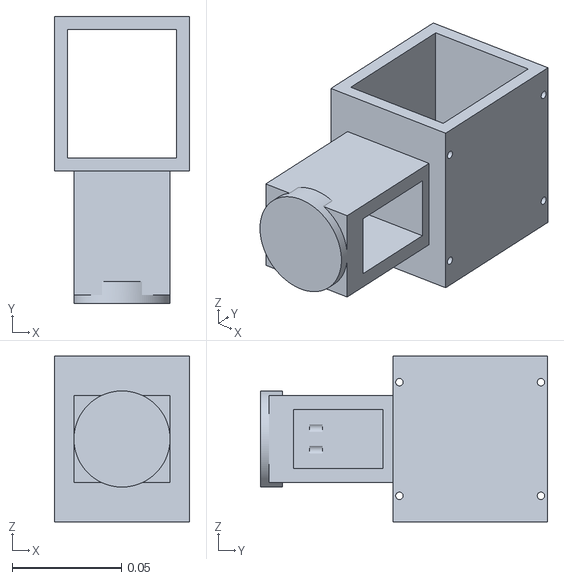
[picture p155: CAD file, 2026-08-21]
live mimic system/meshes36b/shoulder_v4/mount_r.stl
0.062 x 0.131 x 0.076
