danbita/real-steel/live mimic system/meshes36c/shoulder_v5/brg_roll_r.stl

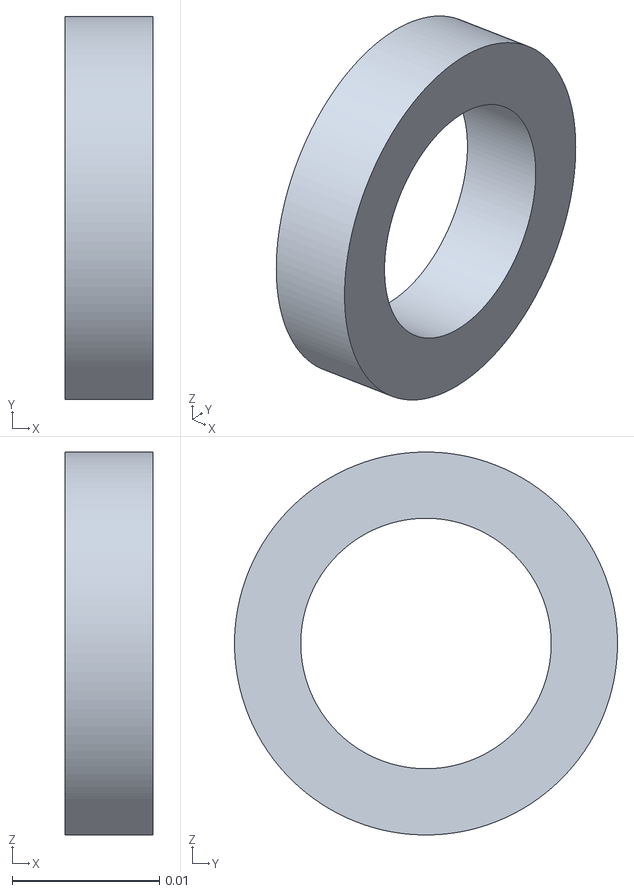
[picture p156: CAD file, 2026-08-21]
live mimic system/meshes36c/shoulder_v5/brg_roll_r.stl
0.006 x 0.026 x 0.026
