danbita/real-steel/live mimic system/meshes36d/shoulder_v6/brg_twist_r.stl

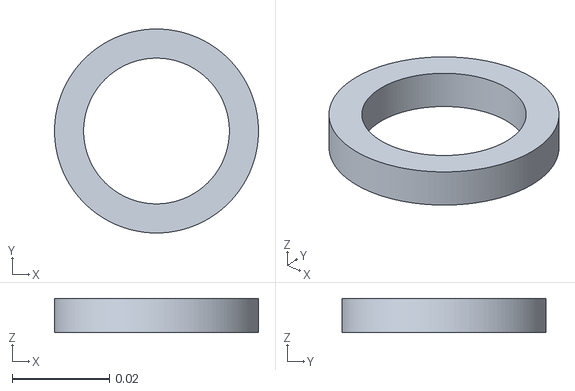
[picture p157: CAD file, 2026-08-21]
live mimic system/meshes36d/shoulder_v6/brg_twist_r.stl
0.042 x 0.042 x 0.007
