danbita/real-steel/live mimic system/meshes/short_arm_link.STL

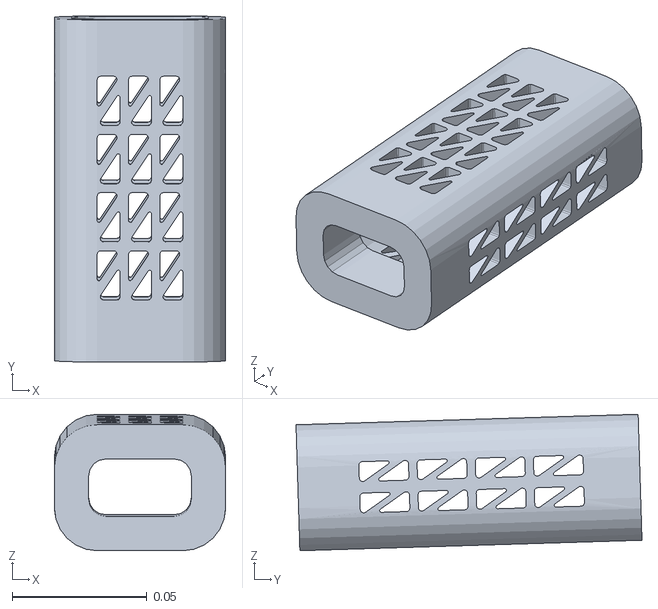
[picture p158: CAD file, 2026-08-21]
live mimic system/meshes/short_arm_link.STL
0.0635 x 0.128 x 0.0506
