danbita/real-steel/live mimic system/meshes36/shoulder_v3/brg_twist.stl

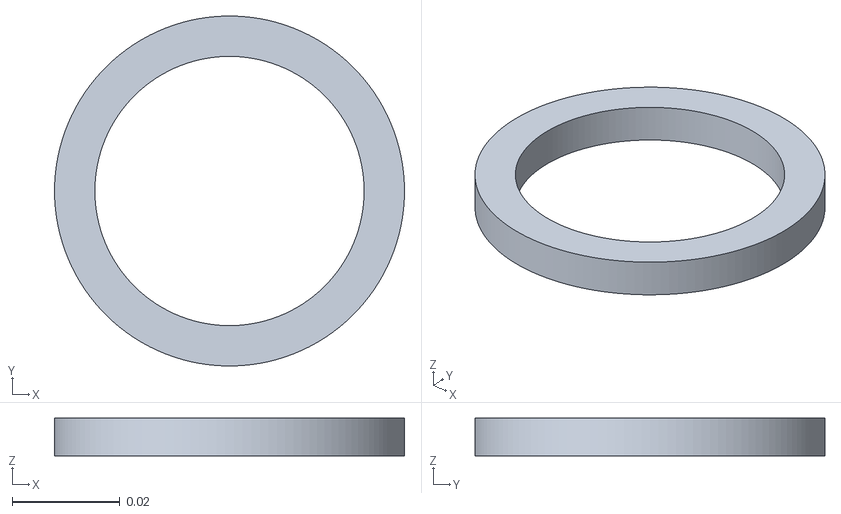
[picture p159: CAD file, 2026-08-21]
live mimic system/meshes36/shoulder_v3/brg_twist.stl
0.065 x 0.065 x 0.007
