danbita/real-steel/live mimic system/meshes36d/shoulder_v6/yoke_r.stl

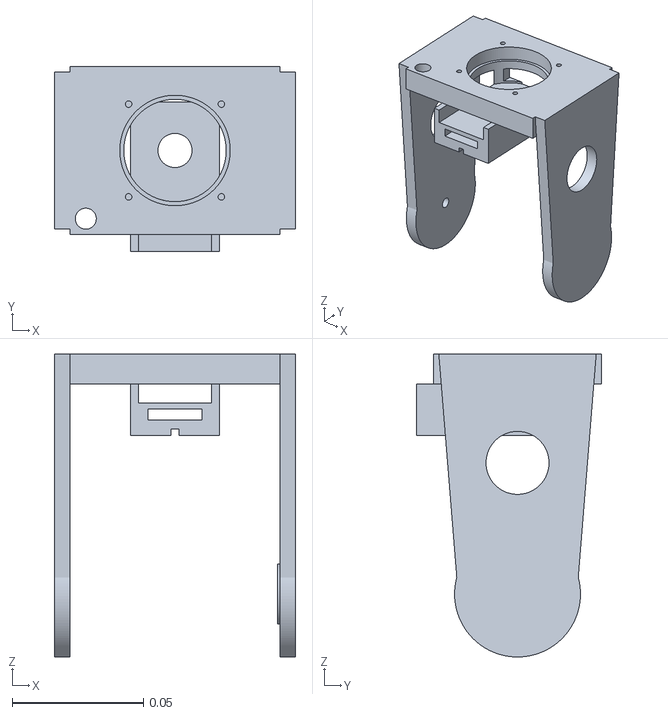
[picture p161: CAD file, 2026-08-21]
live mimic system/meshes36d/shoulder_v6/yoke_r.stl
0.092 x 0.0705 x 0.115
