danbita/real-steel/cad/shoulder_v6/idler625.step

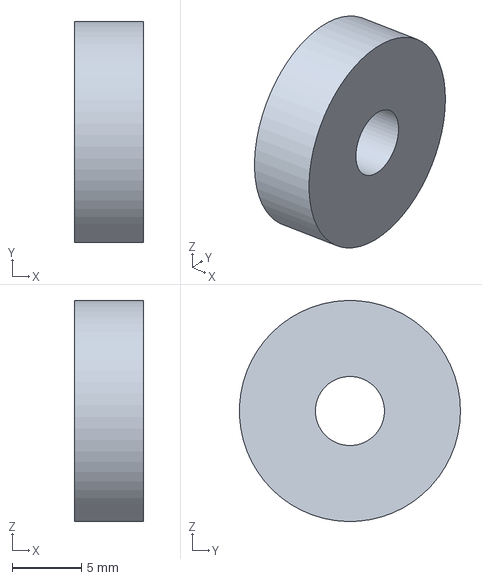
[picture p162: CAD file, 2026-08-21]
cad/shoulder_v6/idler625.step
5.00 x 16.0 x 16.0 mm
