danbita/real-steel/live mimic system/meshes/shoulder_v3/hub_clamp_r.stl

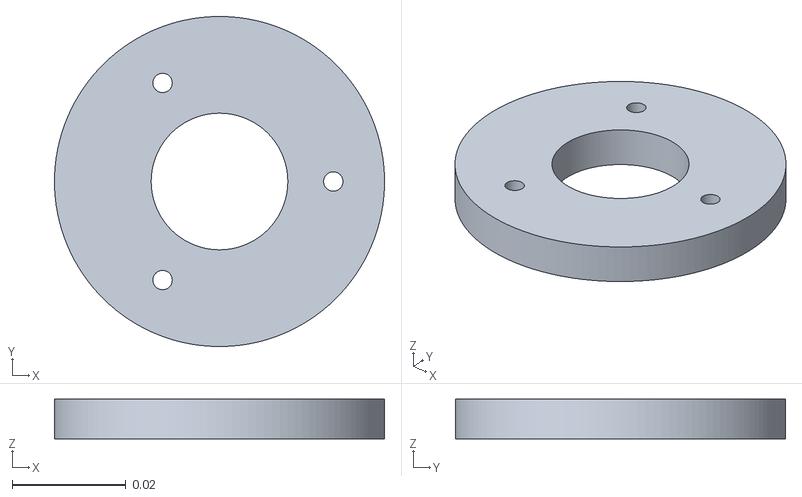
[picture p163: CAD file, 2026-08-21]
live mimic system/meshes/shoulder_v3/hub_clamp_r.stl
0.058 x 0.058 x 0.007
