danbita/real-steel/live mimic system/meshes36d/atom_head.obj

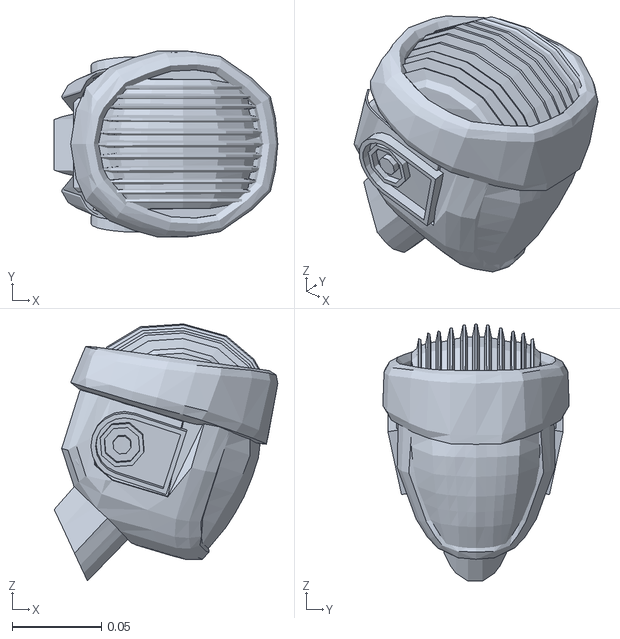
[picture p164: CAD file, 2026-08-21]
live mimic system/meshes36d/atom_head.obj
0.125 x 0.104 x 0.144
