danbita/real-steel/cad/shoulder_v6/interface_plate.step

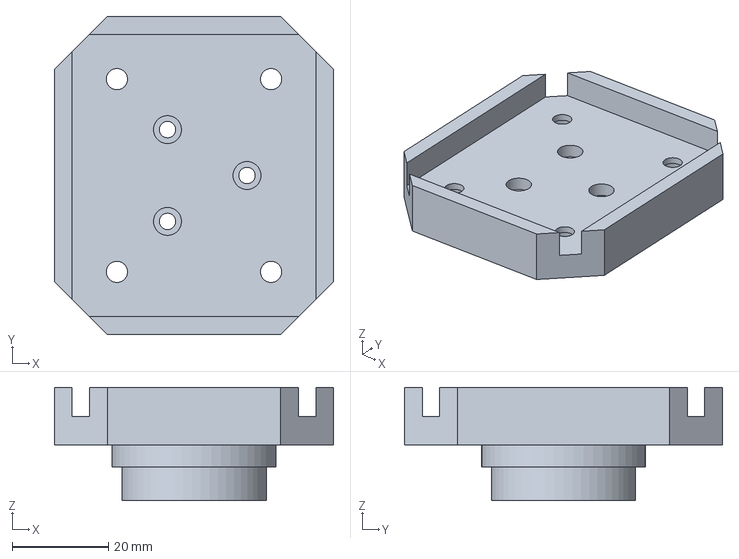
[picture p165: CAD file, 2026-08-21]
cad/shoulder_v6/interface_plate.step
58.0 x 66.0 x 23.5 mm
