danbita/real-steel/live mimic system/meshes/shoulder/yoke.stl

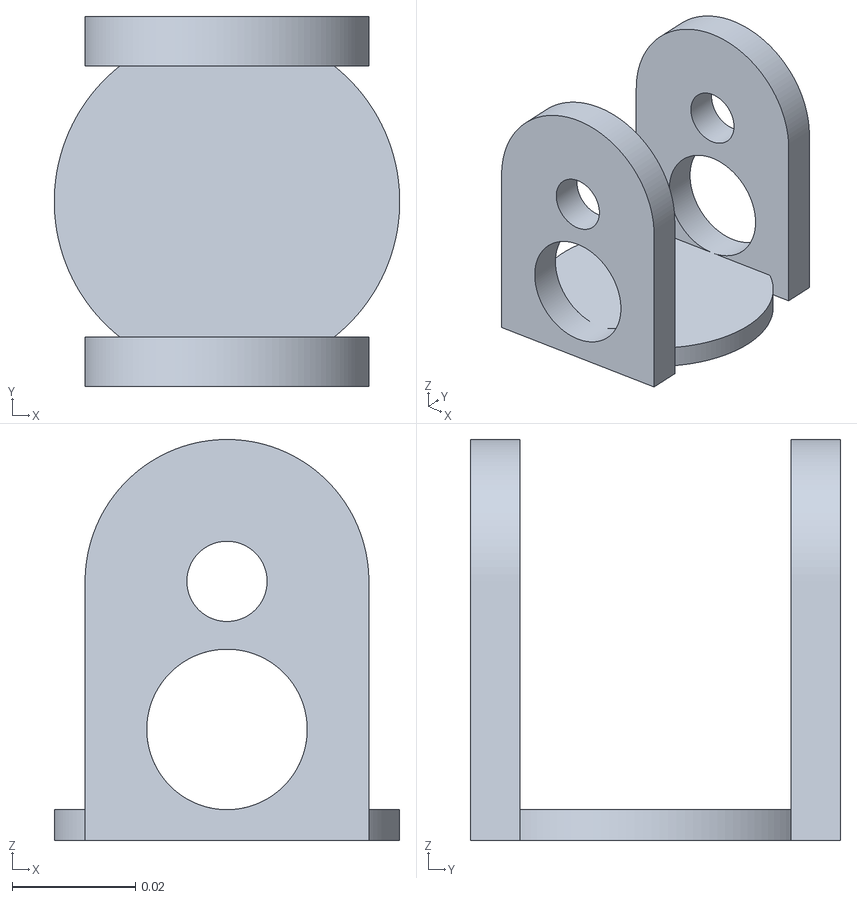
[picture p166: CAD file, 2026-08-21]
live mimic system/meshes/shoulder/yoke.stl
0.056 x 0.06 x 0.065
