danbita/real-steel/live mimic system/meshes36b/shoulder_v4/brg_pitch.stl

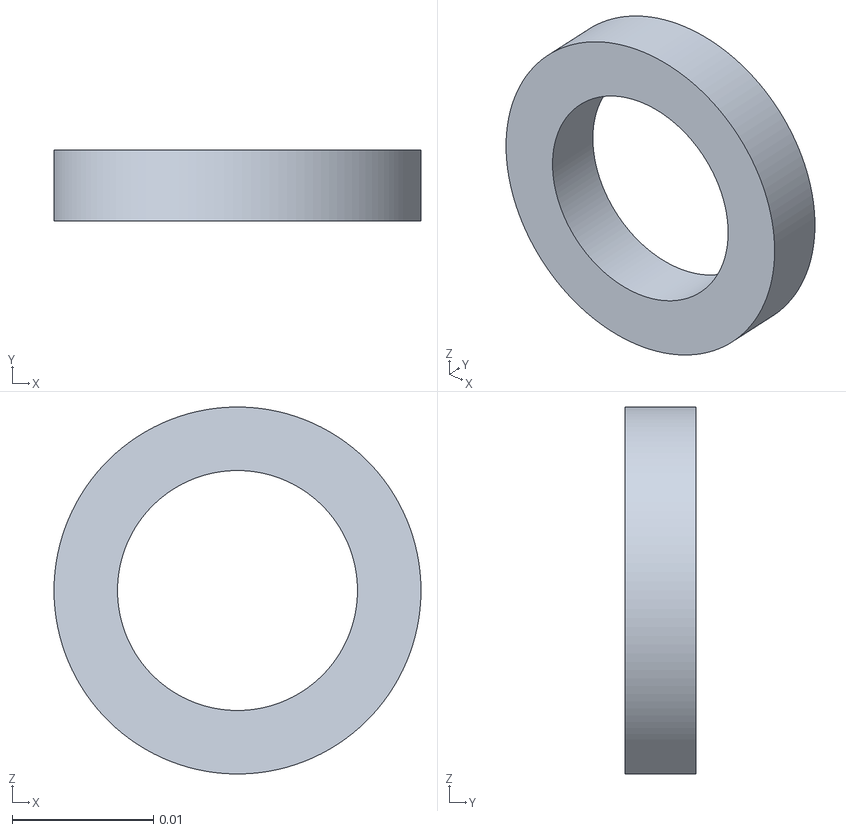
[picture p168: CAD file, 2026-08-21]
live mimic system/meshes36b/shoulder_v4/brg_pitch.stl
0.026 x 0.005 x 0.026
