danbita/real-steel/live mimic system/meshes36c/shoulder_v5/mount.stl

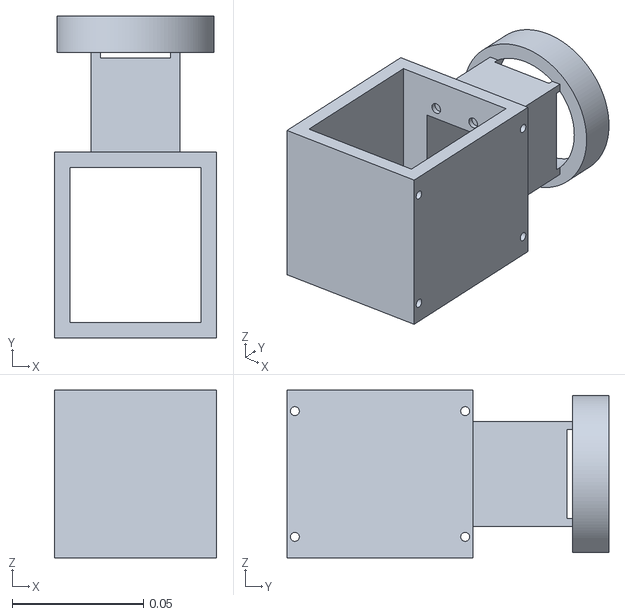
[picture p169: CAD file, 2026-08-21]
live mimic system/meshes36c/shoulder_v5/mount.stl
0.062 x 0.123 x 0.064
