danbita/real-steel/live mimic system/meshes36d/shoulder_v6/roll_idler.stl

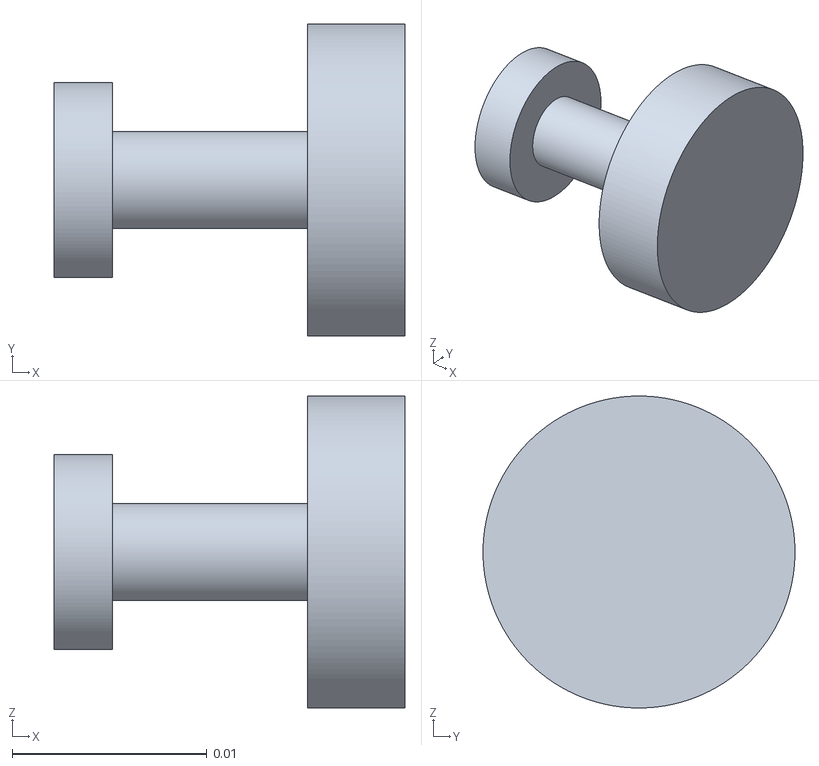
[picture p170: CAD file, 2026-08-21]
live mimic system/meshes36d/shoulder_v6/roll_idler.stl
0.018 x 0.016 x 0.016
