danbita/real-steel/cad/shoulder_v6/right/mount.step

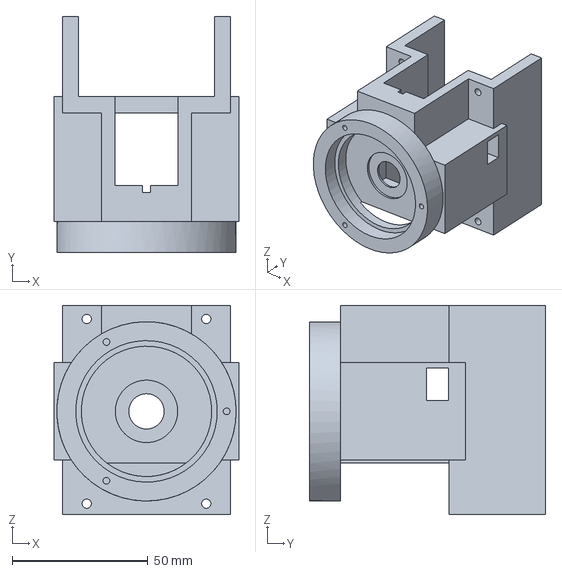
[picture p171: CAD file, 2026-08-21]
cad/shoulder_v6/right/mount.step
68.0 x 86.9 x 77.0 mm
