danbita/real-steel/live mimic system/meshes/shoulder/servoB_shaft.stl

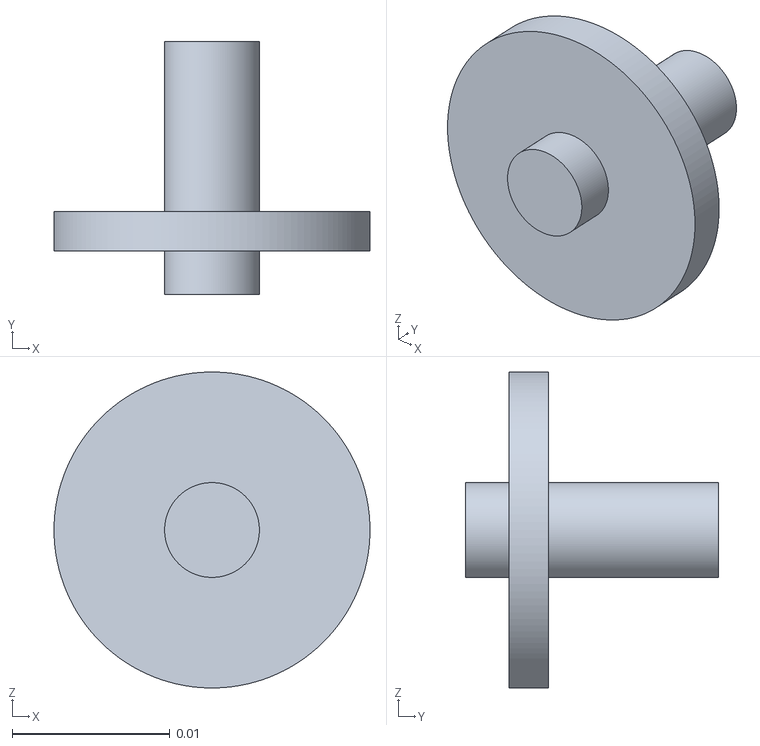
[picture p172: CAD file, 2026-08-21]
live mimic system/meshes/shoulder/servoB_shaft.stl
0.02 x 0.016 x 0.02
