danbita/real-steel/live mimic system/meshes36/shoulder_v3/pitch_retainer_r.stl

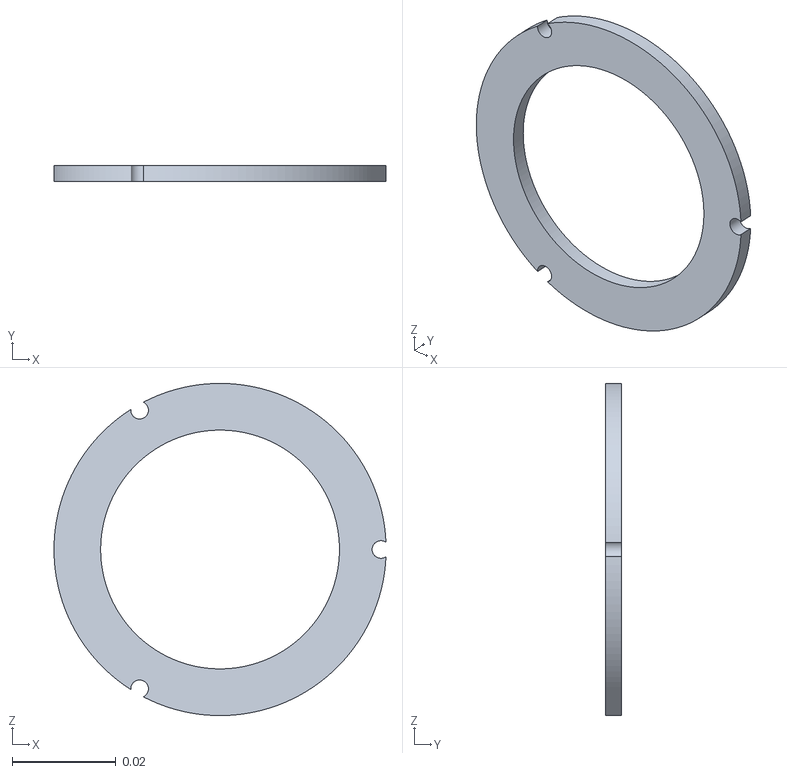
[picture p173: CAD file, 2026-08-21]
live mimic system/meshes36/shoulder_v3/pitch_retainer_r.stl
0.064 x 0.003 x 0.064
