danbita/real-steel/live mimic system/meshes36d/shoulder_v6/servoT_body.stl

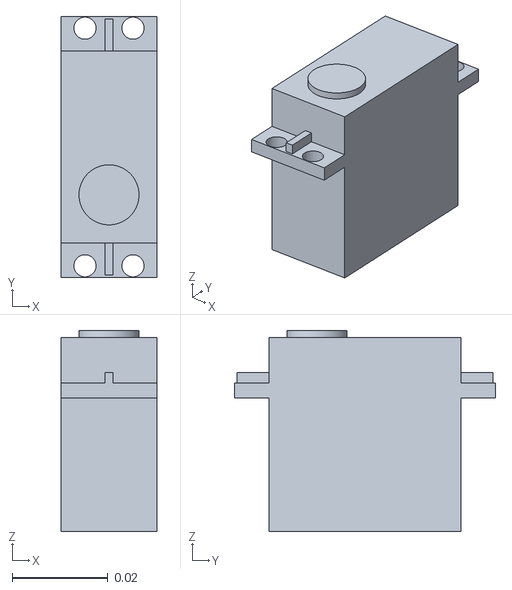
[picture p174: CAD file, 2026-08-21]
live mimic system/meshes36d/shoulder_v6/servoT_body.stl
0.02 x 0.0544 x 0.0419
