danbita/real-steel/cad/shoulder_v6/right/bicep_ref.step

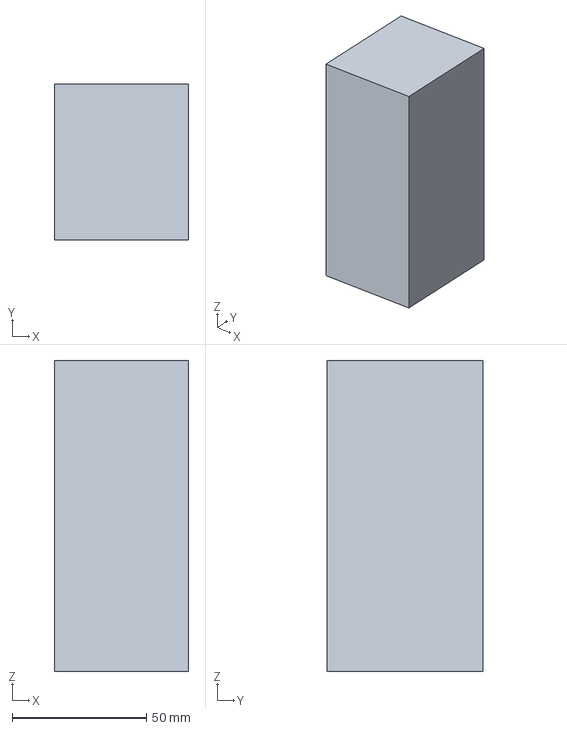
[picture p175: CAD file, 2026-08-21]
cad/shoulder_v6/right/bicep_ref.step
50.0 x 58.0 x 116.0 mm
