danbita/real-steel/live mimic system/meshes36c/shoulder_v5/brg_pitch_r.stl

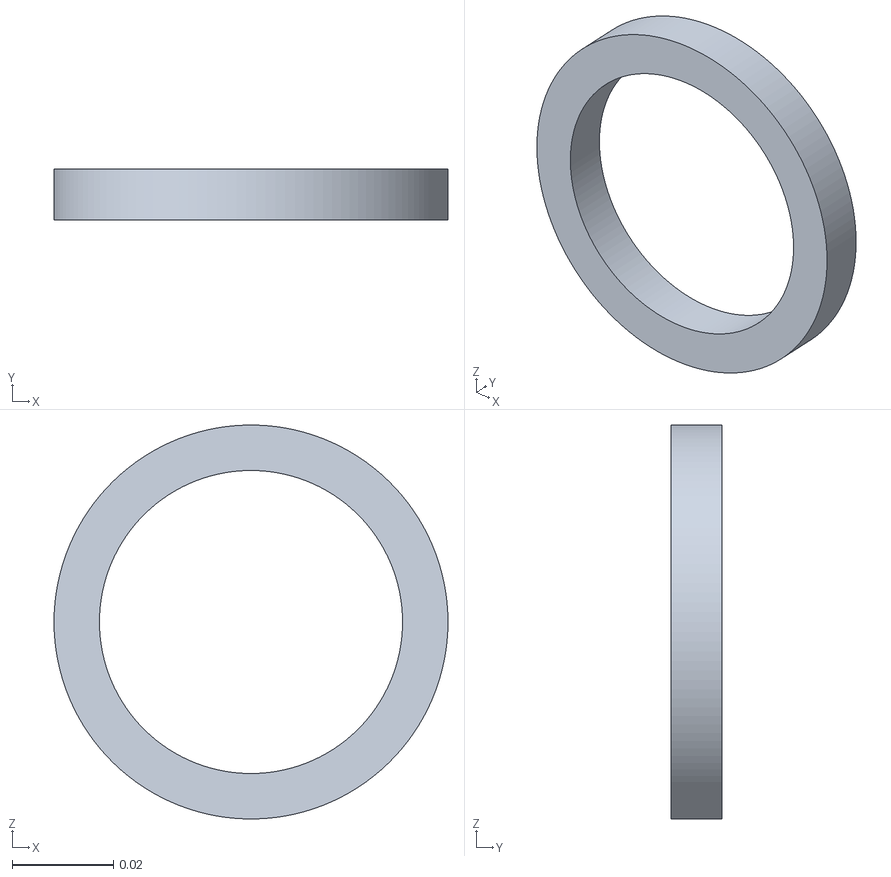
[picture p176: CAD file, 2026-08-21]
live mimic system/meshes36c/shoulder_v5/brg_pitch_r.stl
0.078 x 0.01 x 0.078
