danbita/real-steel/live mimic system/meshes36d/shoulder_v6/carrier_r.stl

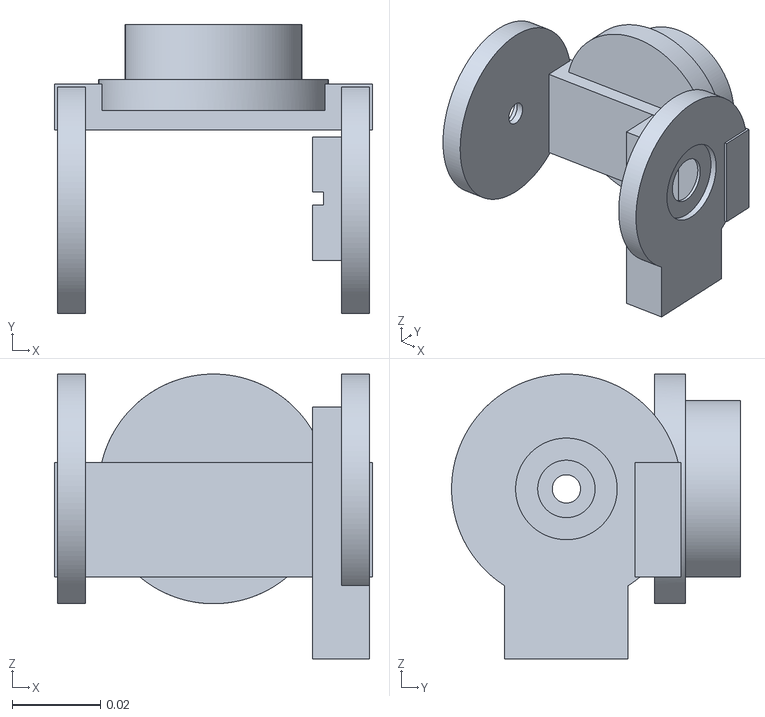
[picture p177: CAD file, 2026-08-21]
live mimic system/meshes36d/shoulder_v6/carrier_r.stl
0.072 x 0.0654 x 0.0645
