danbita/real-steel/cad/shoulder_v6/right/roll_idler.step

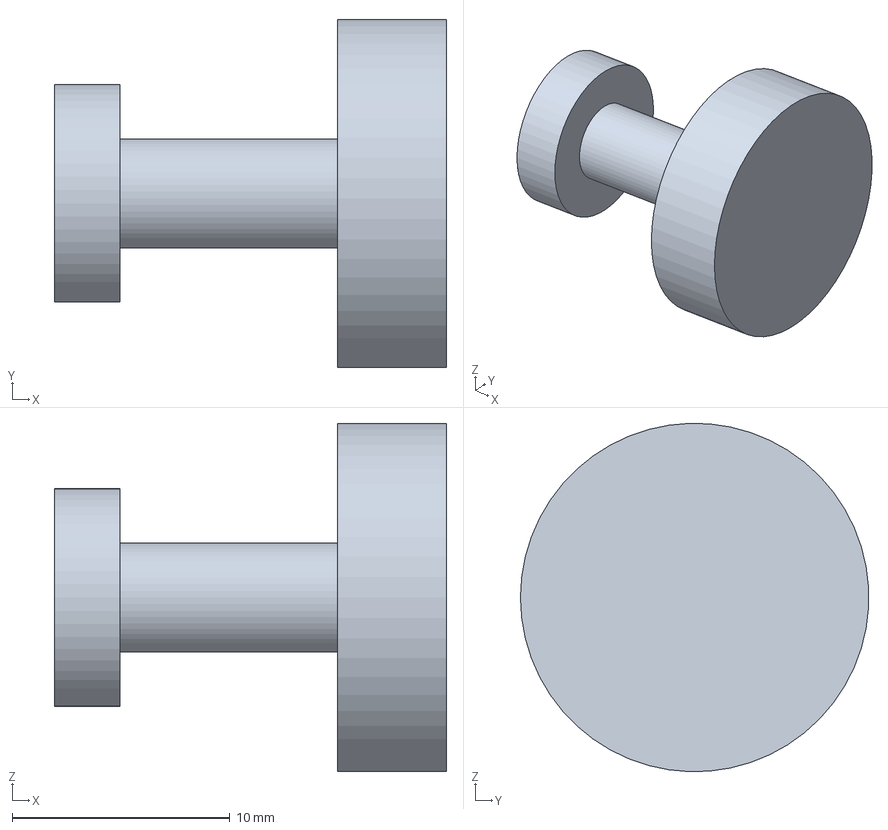
[picture p178: CAD file, 2026-08-21]
cad/shoulder_v6/right/roll_idler.step
18.0 x 16.0 x 16.0 mm
