danbita/real-steel/live mimic system/meshes/shoulder/balls.stl

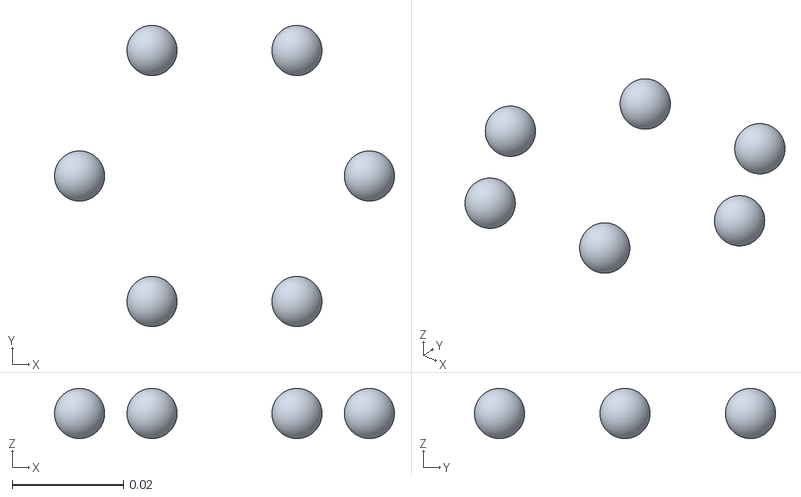
[picture p179: CAD file, 2026-08-21]
live mimic system/meshes/shoulder/balls.stl
0.061 x 0.054 x 0.009
