danbita/real-steel/live mimic system/meshes/shoulder_v3/race_cap.stl

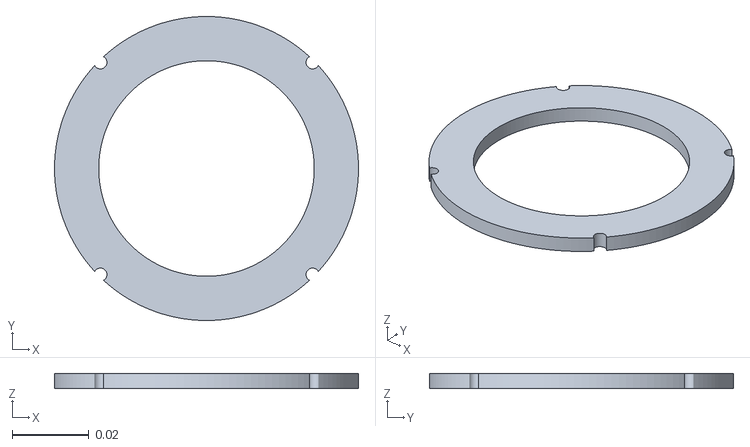
[picture p180: CAD file, 2026-08-21]
live mimic system/meshes/shoulder_v3/race_cap.stl
0.079 x 0.079 x 0.004
