danbita/real-steel/live mimic system/meshes36/shoulder_v3/mount_r.stl

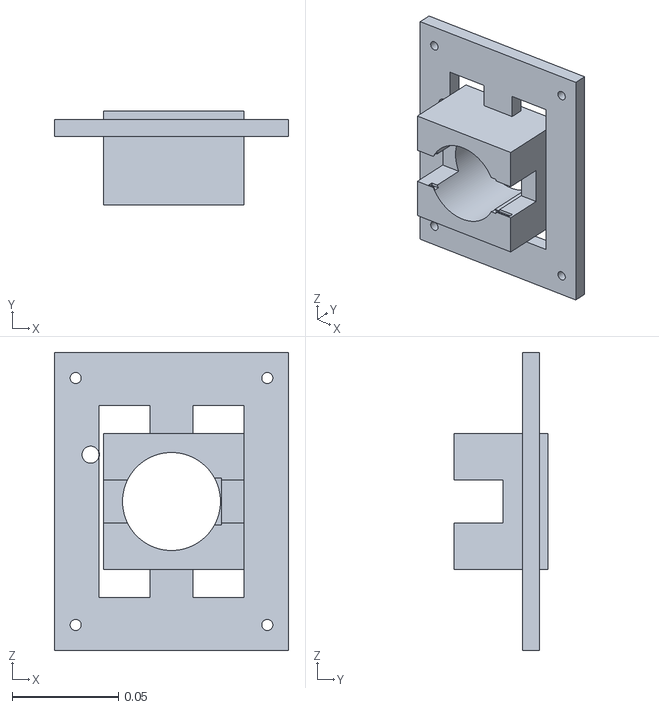
[picture p181: CAD file, 2026-08-21]
live mimic system/meshes36/shoulder_v3/mount_r.stl
0.11 x 0.044 x 0.14
