danbita/real-steel/live mimic system/meshes36b/shoulder_v4/yoke.stl

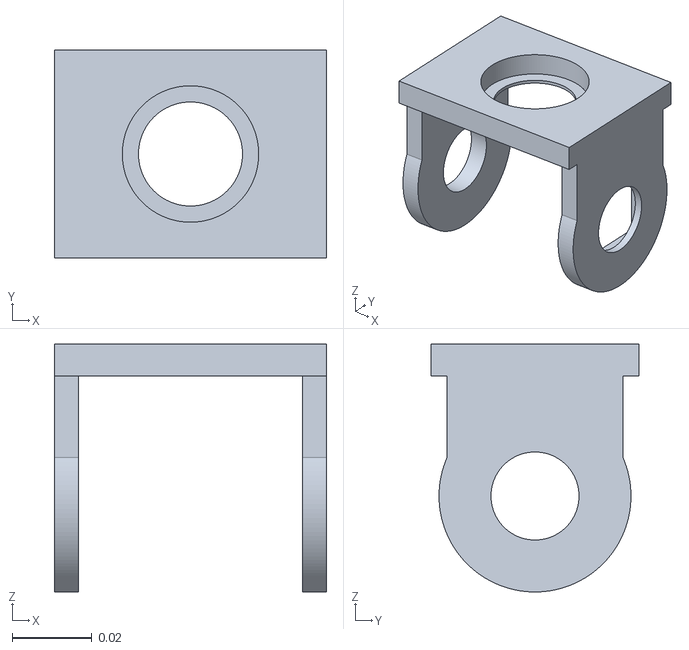
[picture p182: CAD file, 2026-08-21]
live mimic system/meshes36b/shoulder_v4/yoke.stl
0.068 x 0.052 x 0.062
