danbita/real-steel/live mimic system/meshes36d/shoulder_v6/hub_clamp_r.stl

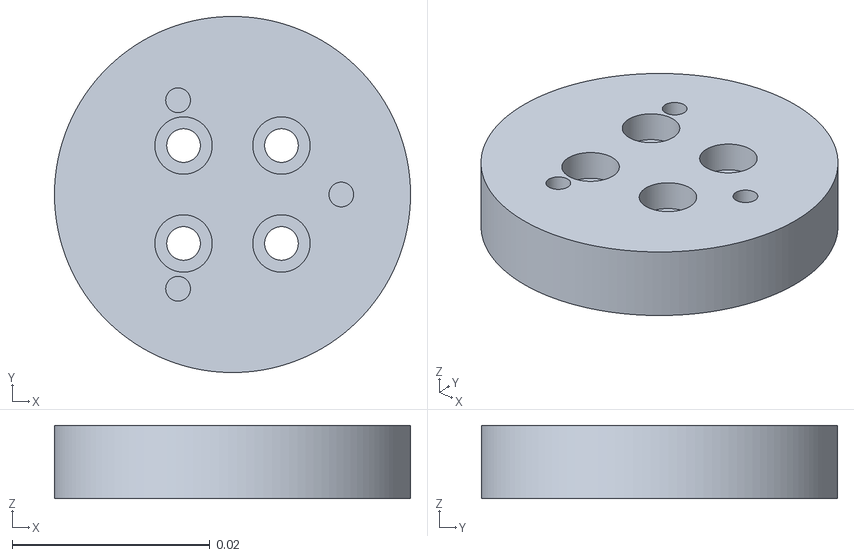
[picture p183: CAD file, 2026-08-21]
live mimic system/meshes36d/shoulder_v6/hub_clamp_r.stl
0.036 x 0.036 x 0.0074
