danbita/real-steel/cad/shoulder_v6/right/servoT_shaft.step

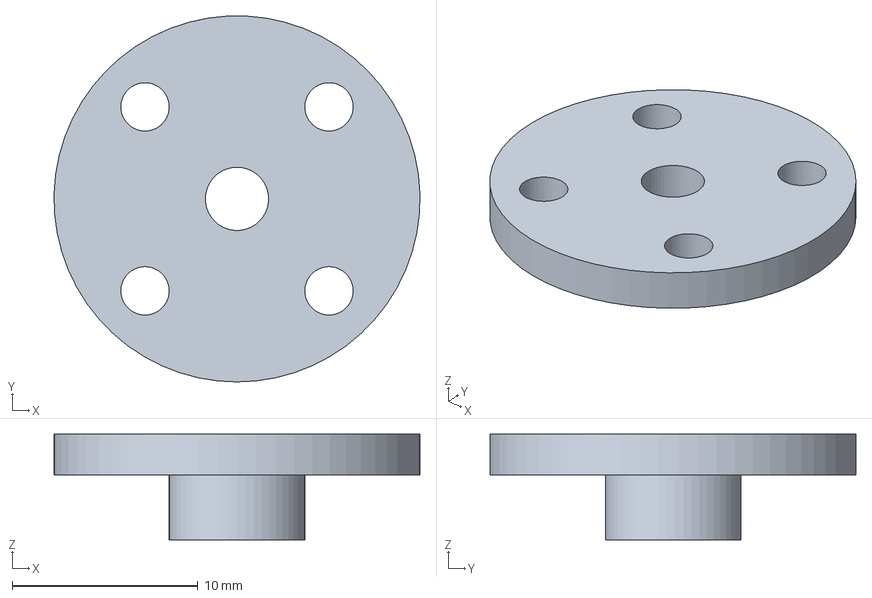
[picture p184: CAD file, 2026-08-21]
cad/shoulder_v6/right/servoT_shaft.step
19.7 x 19.7 x 5.70 mm
