danbita/real-steel/live mimic system/meshes/shoulder/idler_ball.stl

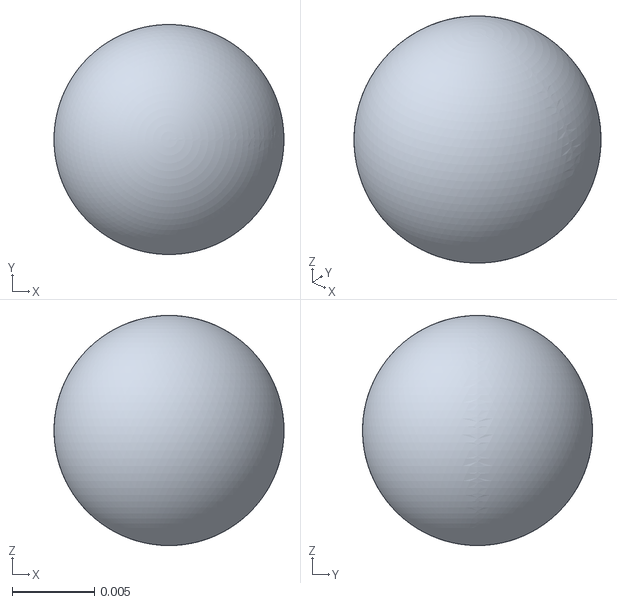
[picture p185: CAD file, 2026-08-21]
live mimic system/meshes/shoulder/idler_ball.stl
0.014 x 0.014 x 0.014
