danbita/real-steel/live mimic system/meshes36c/shoulder_v5/carrier_r.stl

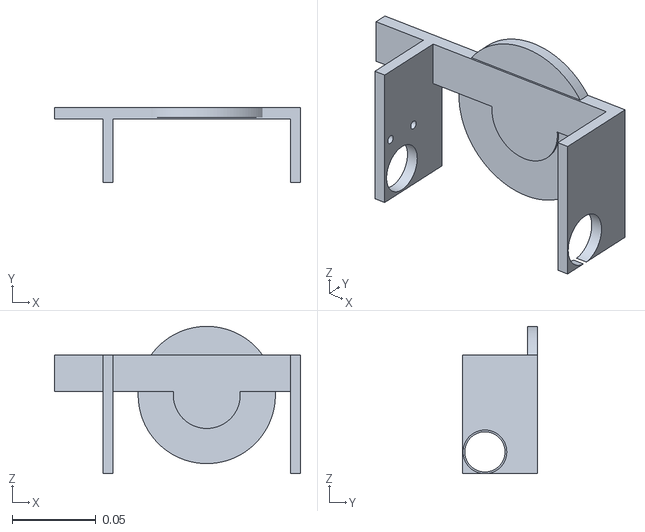
[picture p186: CAD file, 2026-08-21]
live mimic system/meshes36c/shoulder_v5/carrier_r.stl
0.147 x 0.045 x 0.088
