danbita/real-steel/live mimic system/meshes36/shoulder_v3/interface_plate.stl

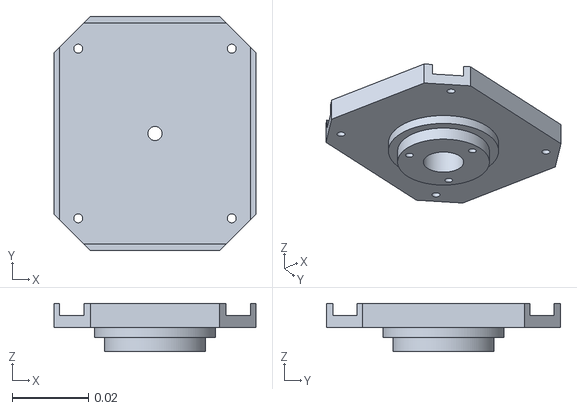
[picture p187: CAD file, 2026-08-21]
live mimic system/meshes36/shoulder_v3/interface_plate.stl
0.0531 x 0.0616 x 0.0127
