danbita/real-steel/live mimic system/meshes36b/shoulder_v4/brg_twist.stl

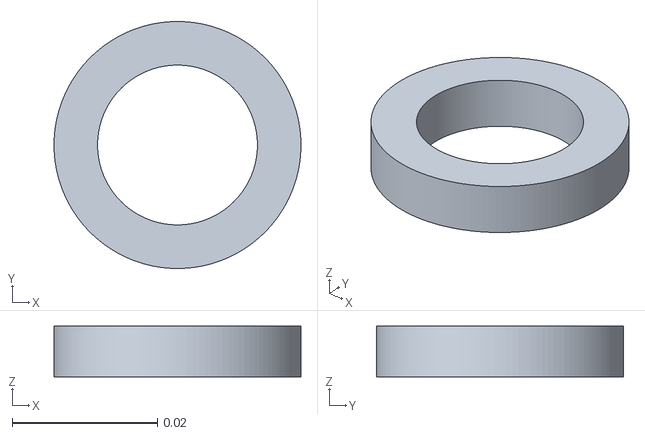
[picture p188: CAD file, 2026-08-21]
live mimic system/meshes36b/shoulder_v4/brg_twist.stl
0.034 x 0.034 x 0.007
