danbita/real-steel/cad/shoulder_v6/right/pitch_retainer.step

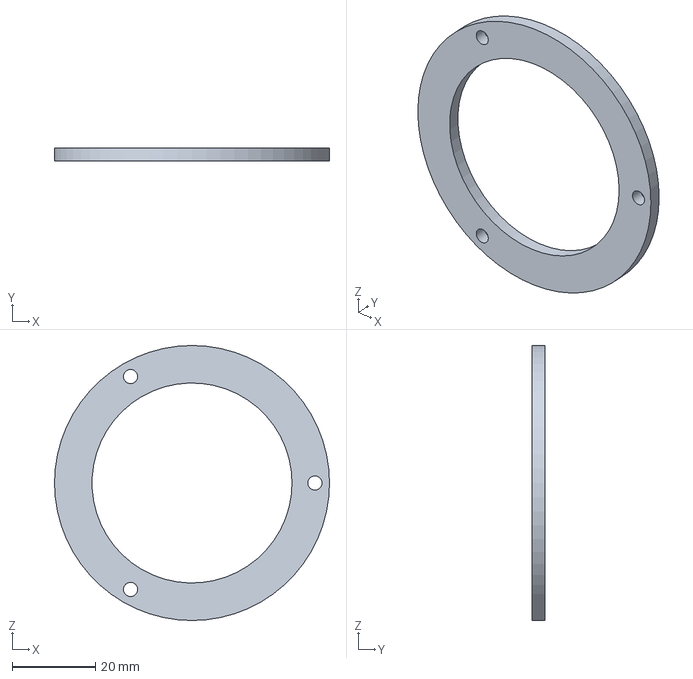
[picture p189: CAD file, 2026-08-21]
cad/shoulder_v6/right/pitch_retainer.step
66.0 x 3.00 x 66.0 mm
