danbita/real-steel/live mimic system/meshes36c/shoulder_v5/yoke.stl

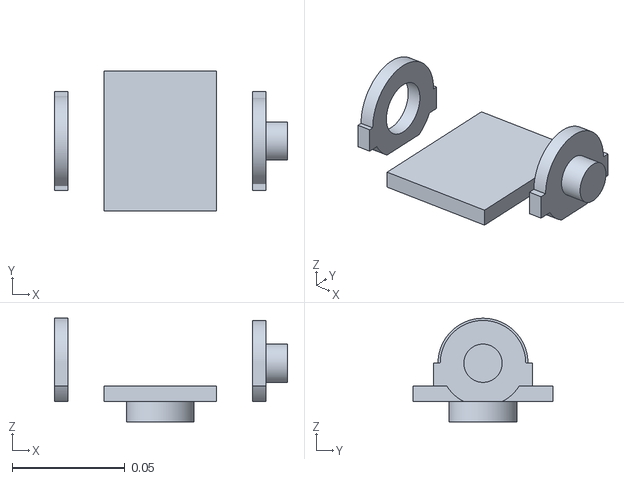
[picture p190: CAD file, 2026-08-21]
live mimic system/meshes36c/shoulder_v5/yoke.stl
0.103 x 0.062 x 0.046
