danbita/real-steel/live mimic system/meshes36d/shoulder_v6/servoT_shaft.stl

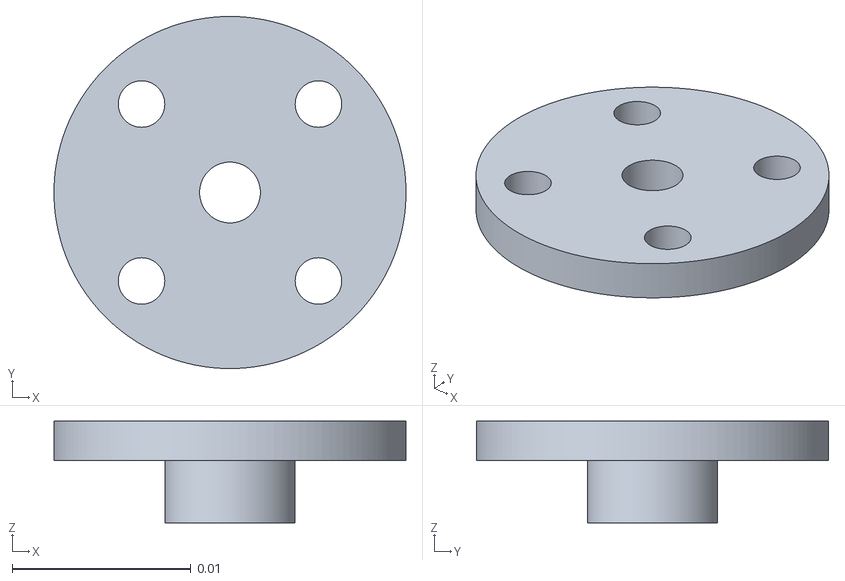
[picture p191: CAD file, 2026-08-21]
live mimic system/meshes36d/shoulder_v6/servoT_shaft.stl
0.0197 x 0.0197 x 0.0057
