danbita/real-steel/live mimic system/meshes36b/shoulder_v4/interface_plate_r.stl

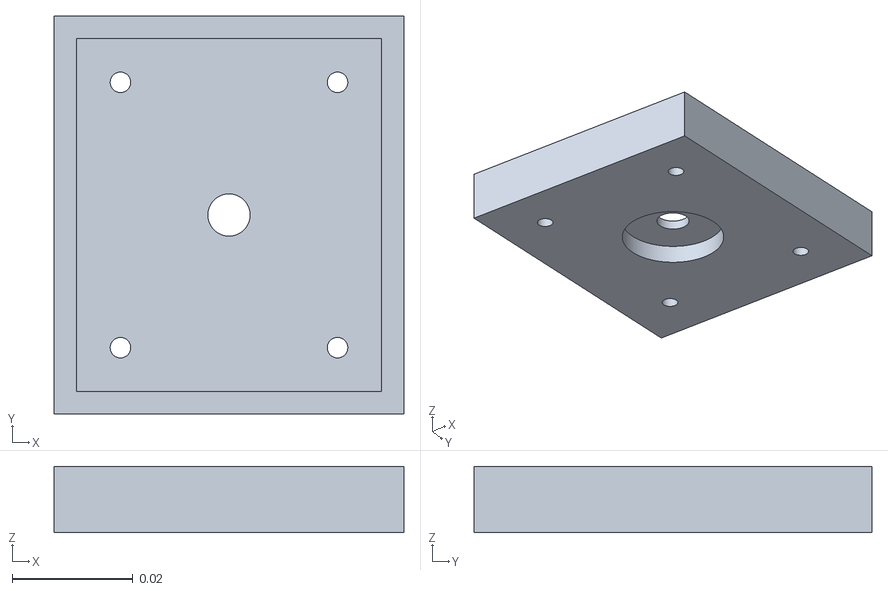
[picture p192: CAD file, 2026-08-21]
live mimic system/meshes36b/shoulder_v4/interface_plate_r.stl
0.058 x 0.066 x 0.011
