danbita/real-steel/live mimic system/meshes36c/shoulder_v5/interface_plate_r.stl

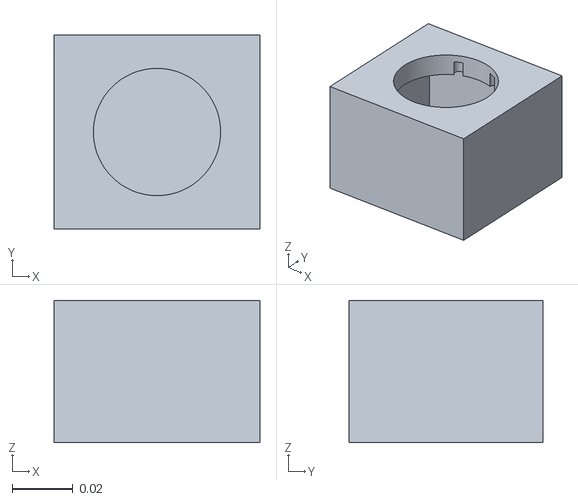
[picture p193: CAD file, 2026-08-21]
live mimic system/meshes36c/shoulder_v5/interface_plate_r.stl
0.068 x 0.064 x 0.047
