danbita/real-steel/(list of files, cad)

Other CAD files:
cad/shoulder_v6/shoulder_assembly.step
live mimic system/meshes36b/shoulder_v4/servoP_body.stl
live mimic system/meshes36c/shoulder_v5/servoP_shaft.stl
cad/shoulder_v6/right/brg_twist.step
live mimic system/meshes/shoulder_v3/servoT_body_r.stl
live mimic system/meshes36/shoulder_v3/servoR_shaft.stl
cad/shoulder_v6/servoR_shaft.step
live mimic system/meshes/shoulder/servoB_body.stl
live mimic system/meshes/shoulder_v3/servoP_shaft.stl
live mimic system/meshes36b/shoulder_v4/servoT_body.stl
live mimic system/meshes36c/shoulder_v5/servoR_body_r.stl
cad/shoulder_v6/right/servoR_shaft.step
live mimic system/meshes/shoulder/servoA_body.stl
live mimic system/meshes36/shoulder_v3/carrier.stl
live mimic system/meshes36b/shoulder_v4/servoR_body_r.stl
live mimic system/meshes36c/shoulder_v5/servoR_body.stl
live mimic system/meshes36d/shoulder_v6/brg_twist.stl
cad/shoulder_v6/right/interface_plate.step
live mimic system/meshes36/shoulder_v3/hub_collar.stl
cad/shoulder_v6/yoke.step
live mimic system/meshes/shoulder_v3/yoke_r.stl
live mimic system/meshes36b/shoulder_v4/servoP_shaft_r.stl
live mimic system/meshes36c/shoulder_v5/servoT_shaft.stl
cad/shoulder_v6/servoR_body.step
live mimic system/meshes/shoulder/servoA_shaft.stl
live mimic system/meshes/shoulder_v3/pitch_retainer.stl
live mimic system/meshes36/shoulder_v3/hub_clamp_r.stl
live mimic system/meshes36b/shoulder_v4/servoR_shaft_r.stl
cad/shoulder_v6/carrier.step
live mimic system/meshes36c/shoulder_v5/brg_twist.stl
cad/shoulder_v6/mount.step
live mimic system/meshes/shoulder_v3/servoR_shaft.stl
live mimic system/meshes36/shoulder_v3/brg_twist_r.stl
live mimic system/meshes36b/shoulder_v4/mount.stl
live mimic system/meshes36d/shoulder_v6/race_cap_r.stl
cad/shoulder_v6/right/brg_pitch.step
cad/shoulder_v6/servoT_shaft.step
live mimic system/meshes/shoulder_v3/hub_clamp.stl
live mimic system/meshes36c/shoulder_v5/servoT_body.stl
cad/shoulder_v6/roll_idler.step
live mimic system/meshes/shoulder_v3/servoP_body_r.stl
live mimic system/meshes36/shoulder_v3/servoT_body_r.stl
live mimic system/meshes36b/shoulder_v4/brg_pitch_r.stl
cad/shoulder_v6/pitch_retainer.step
cad/shoulder_v6/right/idler625.step
live mimic system/meshes/shoulder_v3/servoT_shaft.stl
live mimic system/meshes36/shoulder_v3/servoP_shaft_r.stl
live mimic system/meshes36c/shoulder_v5/carrier.stl
live mimic system/meshes36d/shoulder_v6/servoR_shaft_r.stl
cad/shoulder_v6/right/servoP_body.step
cad/shoulder_v6/servoT_body.step
live mimic system/meshes/shoulder_v3/hub_collar_r.stl
live mimic system/meshes/shoulder_v3/right/hub_collar.stl
live mimic system/meshes36/shoulder_v3/servoT_shaft_r.stl
live mimic system/meshes36b/shoulder_v4/servoP_body_r.stl
live mimic system/meshes36d/shoulder_v6/servoP_body.stl
cad/shoulder_v6/bicep_ref.step
cad/shoulder_v6/right/servoT_body.step
live mimic system/meshes/shoulder_v3/mount.stl
live mimic system/meshes36/shoulder_v3/servoR_body_r.stl
live mimic system/meshes36b/shoulder_v4/servoT_shaft_r.stl
live mimic system/meshes36c/shoulder_v5/servoP_shaft_r.stl
cad/shoulder_v6/bicep_ref.stl
cad/shoulder_v6/brg_pitch.stl
cad/shoulder_v6/brg_twist.stl
cad/shoulder_v6/carrier.stl
cad/shoulder_v6/hub_clamp.step
cad/shoulder_v6/hub_clamp.stl
cad/shoulder_v6/idler625.stl
cad/shoulder_v6/interface_plate.stl
cad/shoulder_v6/mount.stl
cad/shoulder_v6/pitch_retainer.stl
cad/shoulder_v6/race_cap.stl
cad/shoulder_v6/right/bicep_ref.stl
cad/shoulder_v6/right/brg_pitch.stl
cad/shoulder_v6/right/brg_twist.stl
cad/shoulder_v6/right/carrier.stl
cad/shoulder_v6/right/hub_clamp.step
cad/shoulder_v6/right/hub_clamp.stl
cad/shoulder_v6/right/idler625.stl
cad/shoulder_v6/right/interface_plate.stl
cad/shoulder_v6/right/mount.stl
cad/shoulder_v6/right/pitch_retainer.stl
cad/shoulder_v6/right/race_cap.step
cad/shoulder_v6/right/race_cap.stl
cad/shoulder_v6/right/roll_idler.stl
cad/shoulder_v6/right/servoP_body.stl
cad/shoulder_v6/right/servoP_shaft.stl
cad/shoulder_v6/right/servoR_body.step
cad/shoulder_v6/right/servoR_body.stl
cad/shoulder_v6/right/servoR_shaft.stl
cad/shoulder_v6/right/servoT_body.stl
cad/shoulder_v6/right/servoT_shaft.stl
cad/shoulder_v6/right/yoke.stl
cad/shoulder_v6/roll_idler.stl
cad/shoulder_v6/servoP_body.stl
cad/shoulder_v6/servoP_shaft.step
cad/shoulder_v6/servoP_shaft.stl
cad/shoulder_v6/servoR_body.stl
cad/shoulder_v6/servoR_shaft.stl
cad/shoulder_v6/servoT_body.stl
cad/shoulder_v6/servoT_shaft.stl
cad/shoulder_v6/yoke.stl
live mimic system/meshes/shoulder_v2/balls.stl
live mimic system/meshes/shoulder_v2/carrier.stl
live mimic system/meshes/shoulder_v2/interface_plate.stl
live mimic system/meshes/shoulder_v2/mount.stl
live mimic system/meshes/shoulder_v2/roll_idler.stl
live mimic system/meshes/shoulder_v2/servoP_body.stl
live mimic system/meshes/shoulder_v2/servoP_shaft.stl
live mimic system/meshes/shoulder_v2/servoR_body.stl
live mimic system/meshes/shoulder_v2/servoR_shaft.stl
live mimic system/meshes/shoulder_v2/servoT_body.stl
live mimic system/meshes/shoulder_v2/servoT_shaft.stl
live mimic system/meshes/shoulder_v2/yoke.stl
live mimic system/meshes/shoulder_v3/brg_twist.stl
live mimic system/meshes/shoulder_v3/brg_twist_r.stl
live mimic system/meshes/shoulder_v3/carrier.stl
live mimic system/meshes/shoulder_v3/interface_plate.stl
live mimic system/meshes/shoulder_v3/interface_plate_r.stl
live mimic system/meshes/shoulder_v3/mount_r.stl
live mimic system/meshes/shoulder_v3/pitch_retainer_r.stl
live mimic system/meshes/shoulder_v3/race_cap_r.stl
live mimic system/meshes/shoulder_v3/right/brg_twist.stl
live mimic system/meshes/shoulder_v3/right/interface_plate.stl
live mimic system/meshes/shoulder_v3/right/mount.stl
live mimic system/meshes/shoulder_v3/right/pitch_retainer.stl
live mimic system/meshes/shoulder_v3/right/race_cap.stl
live mimic system/meshes/shoulder_v3/right/roll_idler.stl
live mimic system/meshes/shoulder_v3/right/servoP_body.stl
live mimic system/meshes/shoulder_v3/right/servoP_shaft.stl
live mimic system/meshes/shoulder_v3/right/servoR_body.stl
live mimic system/meshes/shoulder_v3/right/servoR_shaft.stl
live mimic system/meshes/shoulder_v3/right/servoT_body.stl
live mimic system/meshes/shoulder_v3/right/yoke.stl
live mimic system/meshes/shoulder_v3/roll_idler.stl
live mimic system/meshes/shoulder_v3/roll_idler_r.stl
live mimic system/meshes/shoulder_v3/servoP_body.stl
live mimic system/meshes/shoulder_v3/servoR_body.stl
live mimic system/meshes/shoulder_v3/servoR_body_r.stl
live mimic system/meshes/shoulder_v3/servoR_shaft_r.stl
live mimic system/meshes/shoulder_v3/servoT_body.stl
live mimic system/meshes/shoulder_v3/yoke.stl
live mimic system/meshes36/shoulder_v3/carrier_r.stl
live mimic system/meshes36/shoulder_v3/hub_clamp.stl
live mimic system/meshes36/shoulder_v3/hub_collar_r.stl
live mimic system/meshes36/shoulder_v3/interface_plate_r.stl
live mimic system/meshes36/shoulder_v3/mount.stl
live mimic system/meshes36/shoulder_v3/pitch_retainer.stl
live mimic system/meshes36/shoulder_v3/race_cap.stl
live mimic system/meshes36/shoulder_v3/race_cap_r.stl
live mimic system/meshes36/shoulder_v3/roll_idler.stl
live mimic system/meshes36/shoulder_v3/roll_idler_r.stl
live mimic system/meshes36/shoulder_v3/servoP_body.stl
live mimic system/meshes36/shoulder_v3/servoP_body_r.stl
live mimic system/meshes36/shoulder_v3/servoP_shaft.stl
live mimic system/meshes36/shoulder_v3/servoT_body.stl
live mimic system/meshes36/shoulder_v3/servoT_shaft.stl
live mimic system/meshes36/shoulder_v3/yoke_r.stl
live mimic system/meshes36b/shoulder_v4/brg_twist_r.stl
live mimic system/meshes36b/shoulder_v4/carrier.stl
live mimic system/meshes36b/shoulder_v4/interface_plate.stl
live mimic system/meshes36b/shoulder_v4/servoP_shaft.stl
live mimic system/meshes36b/shoulder_v4/servoR_shaft.stl
live mimic system/meshes36b/shoulder_v4/servoT_body_r.stl
live mimic system/meshes36b/shoulder_v4/servoT_shaft.stl
live mimic system/meshes36b/shoulder_v4/yoke_r.stl
live mimic system/meshes36c/shoulder_v5/brg_pitch.stl
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
