danbita/real-steel/live mimic system/humanoid_v11_atom.urdf

<?xml version="1.0"?>
<!-- GENERATED by sim/gen_humanoid_v11.py . Do not hand-edit; edit the generator.

     humanoid_v11_atom.urdf : shoulder_v6 (3 DOF, real bearings) + the ATOM arm.

     v3 exports a genuinely mirrored right-hand module, so both shoulders mount
     unrotated and share sign conventions. v6 had to rotate the right module 180
     deg about Z, which flipped the arm fore/aft and needed a patched elbow axis.

     Module mass 933.5 g/side (was 771 g for v2) - the pitch and twist bearings
     and their retainers. ATOM arm 586 g/side.

     SERVOS ARE NOW REAL PARTS, NOT PLACEHOLDERS:
       shoulder pitch/roll/twist : Dynamixel XH540-W270, 10.6 Nm stall, 3.14 rad/s
       elbow                     : Dynamixel XH430-W350,  4.8 Nm stall, 3.40 rad/s
     Earlier versions used the MG996R's 9 Nm STALL figure as if it were a working
     limit. It is not - hobby servos should run near 1/3 of stall continuously.
     The CAD (cad/shoulder_v6) still has MG996R-sized pockets; the servo envelope
     is parameterised there and needs re-exporting for the 65x30x48 Dynamixels.

     Travel limits below are SERVO limits and MUST be re-measured by collision
     sweep; v2's advertised figures did not survive that test.
-->
<robot name="humanoid_v8_atom">

  <mujoco>
    <compiler meshdir="meshes36d/" balanceinertia="true" discardvisual="false"/>
  </mujoco>

  <!-- ATOM PALETTE, sampled from the donor model's own BaseColor maps: torso,
       arms and upper leg all bucket to a neutral gunmetal 0.32, extremities run
       warmer/darker, and the only saturated colour on him is the emissive cyan
       of the chest light and eyes. blue/orange keep their NAMES so side() and
       legs() are untouched, but are weathered metal tints now, not primaries. -->
  <material name="gray"><color rgba="0.32 0.32 0.32 1"/></material>
  <material name="tan"><color rgba="0.30 0.29 0.27 1"/></material>
  <material name="blue"><color rgba="0.20 0.55 0.68 1"/></material>
  <material name="orange"><color rgba="0.72 0.42 0.18 1"/></material>
  <material name="dark"><color rgba="0.14 0.14 0.15 1"/></material>
  <material name="chest"><color rgba="0.22 0.23 0.25 1"/></material>

  <!-- SKELETON torso. The old solid 0.20x0.34x0.65 box was a placeholder that
       also happened to be structural in the sim. Real build is a narrow spine
       with a shell over it, so the spine only has to reach the shoulder module's
       mounting plate: 118.4 mm axis - 89 mm standoff = 29.4 mm half-width. -->
  <link name="torso">
    <visual><geometry><box size="0.050 0.059 0.2634"/></geometry><origin xyz="0 0 0.6163"/><material name="gray"/></visual>
    <collision><geometry><box size="0.050 0.059 0.2634"/></geometry><origin xyz="0 0 0.6163"/></collision>
    <inertial><mass value="0.90"/><origin xyz="0 0 0.6163"/><inertia ixx="0.006" iyy="0.006" izz="0.001" ixy="0" ixz="0" iyz="0"/></inertial>
    <visual><geometry><box size="0.070 0.175 0.055"/></geometry><origin xyz="0 0 0.4846"/><material name="gray"/></visual>
    <collision><geometry><box size="0.070 0.175 0.055"/></geometry><origin xyz="0 0 0.4846"/></collision>
    <visual><geometry><cylinder radius="0.012" length="0.048"/></geometry><origin xyz="0 0 0.772"/><material name="gray"/></visual>
    <!-- HEAD. Atom head lifted from Atom_Real_Steel_Model.obj (Material.005).
         Source is Y-up facing -Z, so +90 about X then +90 about Z into REP-103.
         Scaled to 143.7 mm = the DONOR's own head/stature ratio 0.1572, not the
         0.130 human figure in docs/proportions.md; at 118.9 it read small.
         Centred on its own bbox; z 0.84208 holds the crown at 0.9144.
         Nudged 20 mm FORWARD because the model's neck stub hangs off the REAR
         of the skull - at x=0 the head floated above the neck cylinder.
         PITCHED -12 deg (nose up): the mesh leans forward, and -12 is where the
         crown band reads level against a true horizontal.
         atom_head.png is BaseColor + Emissive baked in - MuJoCo ignores map_Ke,
         and that bake is what makes the eyes glow. The texture carries the
         grille face, so the old dark marker spheres are gone.
         Material is assigned in build_humanoid_v11_scene.py, not here: URDF
         materials cannot carry a texture MuJoCo will pick up.
         Visual only and MASSLESS - the torso inertial above is untouched. -->
    <visual><geometry><mesh filename="atom_head.obj"/></geometry><origin xyz="0.020 0 0.84208" rpy="0 -0.209440 0"/><material name="tan"/></visual>
    <visual><origin xyz="0.027 0 0.660"/><geometry><box size="0.004 0.050 0.090"/></geometry><material name="chest"/></visual>
  </link>

  <!-- ################### LEFT SHOULDER (v3 module) ################## -->
  <joint name="L_shoulder_mount" type="fixed">
    <parent link="torso"/><child link="L_shoulder_base"/>
    <origin xyz="0 0.1184 0.748" rpy="0 3.1415927 0"/>
  </joint>

  <link name="L_shoulder_base">
    <inertial>
      <origin xyz="0.000000 -0.068431 0.003471"/>
      <mass value="0.234859"/>
      <inertia ixx="0.000179494" ixy="-0.000000000" ixz="-0.000000000" iyy="0.000170123" iyz="-0.000006131" izz="0.000201799"/>
    </inertial>
    <visual><origin xyz="0 0 -0.1"/><geometry><mesh filename="shoulder_v6/mount.stl"/></geometry></visual>
    <visual><origin xyz="0 0 -0.1"/><geometry><mesh filename="shoulder_v6/servoP_body.stl"/></geometry></visual>
    <visual><origin xyz="0 0 -0.1"/><geometry><mesh filename="shoulder_v6/pitch_retainer.stl"/></geometry></visual>
    <collision><origin xyz="0.0000 -0.1097 0.0005"/><geometry><box size="0.0620 0.0174 0.0770"/></geometry></collision>
    <collision><origin xyz="0.0000 -0.0923 0.0005"/><geometry><box size="0.0680 0.0174 0.0770"/></geometry></collision>
    <collision><origin xyz="0.0000 -0.0750 0.0005"/><geometry><box size="0.0680 0.0174 0.0770"/></geometry></collision>
    <collision><origin xyz="0.0000 -0.0576 0.0100"/><geometry><box size="0.0232 0.0174 0.0580"/></geometry></collision>
    <collision><origin xyz="0.0000 -0.0402 0.0030"/><geometry><box size="0.0680 0.0174 0.0720"/></geometry></collision>
    <collision><origin xyz="0.0000 -0.0660 -0.0082"/><geometry><box size="0.0200 0.0419 0.0181"/></geometry></collision>
    <collision><origin xyz="0.0000 -0.0458 0.0100"/><geometry><box size="0.0123 0.0020 0.0181"/></geometry></collision>
    <collision><origin xyz="0.0000 -0.0668 0.0281"/><geometry><box size="0.0200 0.0404 0.0181"/></geometry></collision>
  </link>

  <joint name="L_shoulder_pitch" type="revolute">
    <parent link="L_shoulder_base"/><child link="L_shoulder_carrier"/>
    <origin xyz="0 0 0"/><axis xyz="0 -1 0"/>
    <limit lower="-1.0472" upper="3.1416" effort="3.0" velocity="4.2"/>
    <dynamics damping="0.06" friction="0.02"/>
  </joint>

  <link name="L_shoulder_carrier">
    <inertial>
      <origin xyz="0.002497 -0.008889 -0.004951"/>
      <mass value="0.153571"/>
      <inertia ixx="0.000061856" ixy="-0.000003409" ixz="0.000008073" iyy="0.000102863" iyz="0.000004852" izz="0.000110884"/>
    </inertial>
    <visual><origin xyz="0 0 -0.1"/><geometry><mesh filename="shoulder_v6/servoP_shaft.stl"/></geometry></visual>
    <visual><origin xyz="0 0 -0.1"/><geometry><mesh filename="shoulder_v6/carrier.stl"/></geometry></visual>
    <visual><origin xyz="0 0 -0.1"/><geometry><mesh filename="shoulder_v6/servoR_body.stl"/></geometry></visual>
    <visual><origin xyz="0 0 -0.1"/><geometry><mesh filename="shoulder_v6/roll_idler.stl"/></geometry></visual>
    <collision><origin xyz="-0.0270 -0.0067 -0.0000"/><geometry><box size="0.0180 0.0654 0.0520"/></geometry></collision>
    <collision><origin xyz="-0.0090 -0.0297 0.0000"/><geometry><box size="0.0180 0.0194 0.0520"/></geometry></collision>
    <collision><origin xyz="0.0090 -0.0297 0.0000"/><geometry><box size="0.0180 0.0194 0.0520"/></geometry></collision>
    <collision><origin xyz="0.0270 -0.0067 -0.0063"/><geometry><box size="0.0180 0.0654 0.0645"/></geometry></collision>
    <collision><origin xyz="0.0117 0.0000 -0.0281"/><geometry><box size="0.0404 0.0200 0.0181"/></geometry></collision>
    <collision><origin xyz="0.0327 0.0000 -0.0100"/><geometry><box size="0.0020 0.0123 0.0181"/></geometry></collision>
    <collision><origin xyz="0.0125 0.0000 0.0082"/><geometry><box size="0.0419 0.0200 0.0181"/></geometry></collision>
  </link>

  <!-- roll = abduction. 0 arm up, 1.5708 straight out, 3.1416 hanging. -->
  <joint name="L_shoulder_roll" type="revolute">
    <parent link="L_shoulder_carrier"/><child link="L_shoulder_yoke"/>
    <origin xyz="0 0 0"/><axis xyz="-1 0 0"/>
    <limit lower="-0.4363" upper="2.6180" effort="3.0" velocity="4.2"/>
    <dynamics damping="0.06" friction="0.02"/>
  </joint>

  <link name="L_shoulder_yoke">
    <inertial>
      <origin xyz="0.000429 0.002949 0.061150"/>
      <mass value="0.248273"/>
      <inertia ixx="0.000285351" ixy="-0.000000319" ixz="0.000004431" iyy="0.000413733" iyz="0.000005057" izz="0.000264074"/>
    </inertial>
    <visual><origin xyz="0 0 -0.1"/><geometry><mesh filename="shoulder_v6/servoR_shaft.stl"/></geometry></visual>
    <visual><origin xyz="0 0 -0.1"/><geometry><mesh filename="shoulder_v6/yoke.stl"/></geometry></visual>
    <visual><origin xyz="0 0 -0.1"/><geometry><mesh filename="shoulder_v6/servoT_body.stl"/></geometry></visual>
    <visual><origin xyz="0 0 -0.1"/><geometry><mesh filename="shoulder_v6/brg_twist.stl"/></geometry></visual>
    <visual><origin xyz="0 0 -0.1"/><geometry><mesh filename="shoulder_v6/race_cap.stl"/></geometry></visual>
    <collision><origin xyz="0.0000 0.0000 -0.0144"/><geometry><box size="0.0920 0.0467 0.0192"/></geometry></collision>
    <collision><origin xyz="0.0000 0.0000 0.0049"/><geometry><box size="0.0920 0.0480 0.0192"/></geometry></collision>
    <collision><origin xyz="0.0000 0.0000 0.0434"/><geometry><box size="0.0920 0.0240 0.0192"/></geometry></collision>
    <collision><origin xyz="0.0000 0.0100 0.0626"/><geometry><box size="0.0920 0.0570 0.0192"/></geometry></collision>
    <collision><origin xyz="0.0000 0.0032 0.0819"/><geometry><box size="0.0920 0.0705 0.0192"/></geometry></collision>
    <collision><origin xyz="0.0000 -0.0082 0.0504"/><geometry><box size="0.0200 0.0181 0.0419"/></geometry></collision>
    <collision><origin xyz="0.0000 0.0100 0.0706"/><geometry><box size="0.0123 0.0181 0.0020"/></geometry></collision>
    <collision><origin xyz="0.0000 0.0281 0.0497"/><geometry><box size="0.0200 0.0181 0.0404"/></geometry></collision>
  </link>

  <joint name="L_shoulder_twist" type="revolute">
    <parent link="L_shoulder_yoke"/><child link="L_shoulder_plate"/>
    <origin xyz="0 0 0"/><axis xyz="0 0 1"/>
    <!-- +/-90, which is what sim36/interference_check.py has actually
         swept. With the twist zero corrected the solved range is only
         -43..+35 deg, so this costs nothing and keeps the live receiver
         inside verified travel. No slip ring: leave a service loop. -->
    <limit lower="-1.5708" upper="1.5708" effort="3.0" velocity="4.2"/>
    <dynamics damping="0.04" friction="0.02"/>
  </joint>

  <link name="L_shoulder_plate">
    <inertial>
      <origin xyz="0.000000 0.000000 0.093989"/>
      <mass value="0.050993"/>
      <inertia ixx="0.000016039" ixy="-0.000000000" ixz="0.000000000" iyy="0.000013838" iyz="0.000000000" izz="0.000022592"/>
    </inertial>
    <visual><origin xyz="0 0 -0.1"/><geometry><mesh filename="shoulder_v6/servoT_shaft.stl"/></geometry></visual>
    <visual><origin xyz="0 0 -0.1"/><geometry><mesh filename="shoulder_v6/interface_plate.stl"/></geometry></visual>
    <visual><origin xyz="0 0 -0.1"/><geometry><mesh filename="shoulder_v6/hub_clamp.stl"/></geometry></visual>
    <collision><origin xyz="0.0000 -0.0247 0.0997"/><geometry><box size="0.0580 0.0165 0.0165"/></geometry></collision>
    <collision><origin xyz="0.0000 -0.0082 0.0933"/><geometry><box size="0.0344 0.0165 0.0175"/></geometry></collision>
    <collision><origin xyz="0.0000 0.0082 0.0933"/><geometry><box size="0.0344 0.0165 0.0175"/></geometry></collision>
    <collision><origin xyz="0.0000 0.0247 0.0997"/><geometry><box size="0.0580 0.0165 0.0165"/></geometry></collision>
  </link>

  <!-- ATOM arm, unchanged below the adapter -->
  <joint name="L_arm_adapter" type="fixed">
    <parent link="L_shoulder_plate"/><child link="L_bicep"/>
    <origin xyz="-0.018392 -0.0093 0.102305" rpy="3.1415927 0 -4.304096299999999"/>
  </joint>

  <link name="L_bicep">
    <inertial>
      <origin xyz="-0.000395 0.018929 -0.038795"/>
      <mass value="0.012476492"/>
      <inertia ixx="0.00000449966" ixy="0.00000005644" ixz="0.00000014778" iyy="0.00000551217" iyz="0.00000028248" izz="0.00000730659"/>
    </inertial>
    <visual><geometry><mesh filename="bicep_Link.STL"/></geometry><material name="blue"/></visual>
    <collision><geometry><mesh filename="bicep_Link.STL"/></geometry></collision>
  </link>

  <joint name="L_elbow_bracket_fixed" type="fixed">
    <parent link="L_bicep"/><child link="L_elbow_bracket"/>
    <origin xyz="-0.000015060 -0.000182015 -0.066715451"/>
  </joint>
  <link name="L_elbow_bracket">
    <inertial>
      <origin xyz="-0.000322 0.020961 -0.005702"/>
      <mass value="0.023682739"/>
      <inertia ixx="0.00001026139" ixy="-0.00000000731" ixz="0.00000010830" iyy="0.00001401984" iyz="0.00000017752" izz="0.00001338420"/>
    </inertial>
    <visual><geometry><mesh filename="elbow_Link.STL"/></geometry><material name="blue"/></visual>
    <collision><geometry><mesh filename="elbow_Link.STL"/></geometry></collision>
  </link>

  <joint name="L_small_gear_fixed" type="fixed">
    <parent link="L_bicep"/><child link="L_small_gear"/>
    <origin xyz="0.012251040 0.020049085 -0.074446811"/>
  </joint>
  <link name="L_small_gear">
    <inertial><origin xyz="-0.004779000 0 0"/><mass value="0.000942778"/>
      <inertia ixx="4.33270428790079E-07" ixy="0" ixz="0" iyy="3.86651069848133E-07" iyz="0" izz="3.86651069848133E-07"/>
    </inertial>
    <visual><geometry><mesh filename="small_gear_Link.STL"/></geometry></visual>
  </link>

  <joint name="L_elbow" type="revolute">
    <parent link="L_bicep"/><child link="L_forearm"/>
    <origin xyz="-0.000015060 0.020049616 -0.094646582" rpy="1.5707963 0 0"/>
    <axis xyz="-1 0 0"/>
    <limit lower="0" upper="2.0944" effort="3.0" velocity="4.2"/>
    <dynamics damping="0.15" friction="0.05"/>
  </joint>
  <link name="L_forearm">
    <inertial>
      <origin xyz="-0.000000 -0.003004 -0.012485"/>
      <mass value="0.020699741"/>
      <inertia ixx="0.00001097382" ixy="-0.00000000326" ixz="-0.00000000008" iyy="0.00000405101" iyz="-0.00000024760" izz="0.00001202303"/>
    </inertial>
    <visual><origin xyz="0.000071897 -0.066235683 0.013072476"/><geometry><mesh filename="short_arm_link.STL"/></geometry><material name="blue"/></visual>
    <collision><origin xyz="0.000071897 -0.066235683 0.013072476"/><geometry><mesh filename="short_arm_link.STL"/></geometry></collision>
  </link>

  <joint name="L_big_gear_fixed" type="fixed">
    <parent link="L_forearm"/><child link="L_big_gear"/>
    <origin xyz="0.012266100 0 0"/>
  </joint>
  <link name="L_big_gear">
    <inertial><origin xyz="-0.004779000 0 0"/><mass value="0.005722263"/>
      <inertia ixx="1.45911616699868E-05" ixy="0" ixz="0" iyy="8.32211862139204E-06" iyz="0" izz="8.33289258825403E-06"/>
    </inertial>
    <visual><geometry><mesh filename="big_gear_Link.STL"/></geometry></visual>
  </link>

  <!-- ################### RIGHT SHOULDER (v3 module) ################## -->
  <joint name="R_shoulder_mount" type="fixed">
    <parent link="torso"/><child link="R_shoulder_base"/>
    <origin xyz="0 -0.1184 0.748" rpy="0 3.1415927 0"/>
  </joint>

  <link name="R_shoulder_base">
    <inertial>
      <origin xyz="0.000000 0.068431 0.003471"/>
      <mass value="0.234859"/>
      <inertia ixx="0.000179494" ixy="0.000000000" ixz="-0.000000000" iyy="0.000170123" iyz="0.000006131" izz="0.000201799"/>
    </inertial>
    <visual><origin xyz="0 0 -0.1"/><geometry><mesh filename="shoulder_v6/mount_r.stl"/></geometry></visual>
    <visual><origin xyz="0 0 -0.1"/><geometry><mesh filename="shoulder_v6/servoP_body_r.stl"/></geometry></visual>
    <visual><origin xyz="0 0 -0.1"/><geometry><mesh filename="shoulder_v6/pitch_retainer_r.stl"/></geometry></visual>
    <collision><origin xyz="0.0 0.1097 0.0005"/><geometry><box size="0.0620 0.0174 0.0770"/></geometry></collision>
    <collision><origin xyz="0.0 0.0923 0.0005"/><geometry><box size="0.0680 0.0174 0.0770"/></geometry></collision>
    <collision><origin xyz="0.0 0.075 0.0005"/><geometry><box size="0.0680 0.0174 0.0770"/></geometry></collision>
    <collision><origin xyz="0.0 0.0576 0.01"/><geometry><box size="0.0232 0.0174 0.0580"/></geometry></collision>
    <collision><origin xyz="0.0 0.0402 0.003"/><geometry><box size="0.0680 0.0174 0.0720"/></geometry></collision>
    <collision><origin xyz="0.0 0.066 -0.0082"/><geometry><box size="0.0200 0.0419 0.0181"/></geometry></collision>
    <collision><origin xyz="0.0 0.0458 0.01"/><geometry><box size="0.0123 0.0020 0.0181"/></geometry></collision>
    <collision><origin xyz="0.0 0.0668 0.0281"/><geometry><box size="0.0200 0.0404 0.0181"/></geometry></collision>
  </link>

  <joint name="R_shoulder_pitch" type="revolute">
    <parent link="R_shoulder_base"/><child link="R_shoulder_carrier"/>
    <origin xyz="0 0 0"/><axis xyz="0 -1 0"/>
    <limit lower="-1.0472" upper="3.1416" effort="3.0" velocity="4.2"/>
    <dynamics damping="0.06" friction="0.02"/>
  </joint>

  <link name="R_shoulder_carrier">
    <inertial>
      <origin xyz="0.002497 0.008889 -0.004951"/>
      <mass value="0.153571"/>
      <inertia ixx="0.000061856" ixy="0.000003409" ixz="0.000008073" iyy="0.000102863" iyz="-0.000004852" izz="0.000110884"/>
    </inertial>
    <visual><origin xyz="0 0 -0.1"/><geometry><mesh filename="shoulder_v6/servoP_shaft_r.stl"/></geometry></visual>
    <visual><origin xyz="0 0 -0.1"/><geometry><mesh filename="shoulder_v6/carrier_r.stl"/></geometry></visual>
    <visual><origin xyz="0 0 -0.1"/><geometry><mesh filename="shoulder_v6/servoR_body_r.stl"/></geometry></visual>
    <visual><origin xyz="0 0 -0.1"/><geometry><mesh filename="shoulder_v6/roll_idler_r.stl"/></geometry></visual>
    <collision><origin xyz="-0.027 0.0067 -0.0"/><geometry><box size="0.0180 0.0654 0.0520"/></geometry></collision>
    <collision><origin xyz="-0.009 0.0297 0.0"/><geometry><box size="0.0180 0.0194 0.0520"/></geometry></collision>
    <collision><origin xyz="0.009 0.0297 0.0"/><geometry><box size="0.0180 0.0194 0.0520"/></geometry></collision>
    <collision><origin xyz="0.027 0.0067 -0.0063"/><geometry><box size="0.0180 0.0654 0.0645"/></geometry></collision>
    <collision><origin xyz="0.0117 -0.0 -0.0281"/><geometry><box size="0.0404 0.0200 0.0181"/></geometry></collision>
    <collision><origin xyz="0.0327 -0.0 -0.01"/><geometry><box size="0.0020 0.0123 0.0181"/></geometry></collision>
    <collision><origin xyz="0.0125 -0.0 0.0082"/><geometry><box size="0.0419 0.0200 0.0181"/></geometry></collision>
  </link>

  <!-- roll = abduction. 0 arm up, 1.5708 straight out, 3.1416 hanging. -->
  <joint name="R_shoulder_roll" type="revolute">
    <parent link="R_shoulder_carrier"/><child link="R_shoulder_yoke"/>
    <origin xyz="0 0 0"/><axis xyz="1 0 0"/>
    <limit lower="-0.4363" upper="2.6180" effort="3.0" velocity="4.2"/>
    <dynamics damping="0.06" friction="0.02"/>
  </joint>

  <link name="R_shoulder_yoke">
    <inertial>
      <origin xyz="0.000429 -0.002949 0.061150"/>
      <mass value="0.248273"/>
      <inertia ixx="0.000285351" ixy="0.000000319" ixz="0.000004431" iyy="0.000413733" iyz="-0.000005057" izz="0.000264074"/>
    </inertial>
    <visual><origin xyz="0 0 -0.1"/><geometry><mesh filename="shoulder_v6/servoR_shaft_r.stl"/></geometry></visual>
    <visual><origin xyz="0 0 -0.1"/><geometry><mesh filename="shoulder_v6/yoke_r.stl"/></geometry></visual>
    <visual><origin xyz="0 0 -0.1"/><geometry><mesh filename="shoulder_v6/servoT_body_r.stl"/></geometry></visual>
    <visual><origin xyz="0 0 -0.1"/><geometry><mesh filename="shoulder_v6/brg_twist_r.stl"/></geometry></visual>
    <visual><origin xyz="0 0 -0.1"/><geometry><mesh filename="shoulder_v6/race_cap_r.stl"/></geometry></visual>
    <collision><origin xyz="0.0 -0.0 -0.0144"/><geometry><box size="0.0920 0.0467 0.0192"/></geometry></collision>
    <collision><origin xyz="0.0 -0.0 0.0049"/><geometry><box size="0.0920 0.0480 0.0192"/></geometry></collision>
    <collision><origin xyz="0.0 -0.0 0.0434"/><geometry><box size="0.0920 0.0240 0.0192"/></geometry></collision>
    <collision><origin xyz="0.0 -0.01 0.0626"/><geometry><box size="0.0920 0.0570 0.0192"/></geometry></collision>
    <collision><origin xyz="0.0 -0.0032 0.0819"/><geometry><box size="0.0920 0.0705 0.0192"/></geometry></collision>
    <collision><origin xyz="0.0 0.0082 0.0504"/><geometry><box size="0.0200 0.0181 0.0419"/></geometry></collision>
    <collision><origin xyz="0.0 -0.01 0.0706"/><geometry><box size="0.0123 0.0181 0.0020"/></geometry></collision>
    <collision><origin xyz="0.0 -0.0281 0.0497"/><geometry><box size="0.0200 0.0181 0.0404"/></geometry></collision>
  </link>

  <joint name="R_shoulder_twist" type="revolute">
    <parent link="R_shoulder_yoke"/><child link="R_shoulder_plate"/>
    <origin xyz="0 0 0"/><axis xyz="0 0 1"/>
    <!-- +/-90, which is what sim36/interference_check.py has actually
         swept. With the twist zero corrected the solved range is only
         -43..+35 deg, so this costs nothing and keeps the live receiver
         inside verified travel. No slip ring: leave a service loop. -->
    <limit lower="-1.5708" upper="1.5708" effort="3.0" velocity="4.2"/>
    <dynamics damping="0.04" friction="0.02"/>
  </joint>

  <link name="R_shoulder_plate">
    <inertial>
      <origin xyz="0.000000 -0.000000 0.093989"/>
      <mass value="0.050993"/>
      <inertia ixx="0.000016039" ixy="0.000000000" ixz="0.000000000" iyy="0.000013838" iyz="-0.000000000" izz="0.000022592"/>
    </inertial>
    <visual><origin xyz="0 0 -0.1"/><geometry><mesh filename="shoulder_v6/servoT_shaft_r.stl"/></geometry></visual>
    <visual><origin xyz="0 0 -0.1"/><geometry><mesh filename="shoulder_v6/interface_plate_r.stl"/></geometry></visual>
    <visual><origin xyz="0 0 -0.1"/><geometry><mesh filename="shoulder_v6/hub_clamp_r.stl"/></geometry></visual>
    <collision><origin xyz="0.0 0.0247 0.0997"/><geometry><box size="0.0580 0.0165 0.0165"/></geometry></collision>
    <collision><origin xyz="0.0 0.0082 0.0933"/><geometry><box size="0.0344 0.0165 0.0175"/></geometry></collision>
    <collision><origin xyz="0.0 -0.0082 0.0933"/><geometry><box size="0.0344 0.0165 0.0175"/></geometry></collision>
    <collision><origin xyz="0.0 -0.0247 0.0997"/><geometry><box size="0.0580 0.0165 0.0165"/></geometry></collision>
  </link>

  <!-- ATOM arm, unchanged below the adapter -->
  <joint name="R_arm_adapter" type="fixed">
    <parent link="R_shoulder_plate"/><child link="R_bicep"/>
    <origin xyz="-0.018392 0.0068 0.102305" rpy="3.1415927 0 1.1625036999999998"/>
  </joint>

  <link name="R_bicep">
    <inertial>
      <origin xyz="-0.000395 0.018929 -0.038795"/>
      <mass value="0.012476492"/>
      <inertia ixx="0.00000449966" ixy="0.00000005644" ixz="0.00000014778" iyy="0.00000551217" iyz="0.00000028248" izz="0.00000730659"/>
    </inertial>
    <visual><geometry><mesh filename="bicep_Link.STL"/></geometry><material name="orange"/></visual>
    <collision><geometry><mesh filename="bicep_Link.STL"/></geometry></collision>
  </link>

  <joint name="R_elbow_bracket_fixed" type="fixed">
    <parent link="R_bicep"/><child link="R_elbow_bracket"/>
    <origin xyz="-0.000015060 -0.000182015 -0.066715451"/>
  </joint>
  <link name="R_elbow_bracket">
    <inertial>
      <origin xyz="-0.000322 0.020961 -0.005702"/>
      <mass value="0.023682739"/>
      <inertia ixx="0.00001026139" ixy="-0.00000000731" ixz="0.00000010830" iyy="0.00001401984" iyz="0.00000017752" izz="0.00001338420"/>
    </inertial>
    <visual><geometry><mesh filename="elbow_Link.STL"/></geometry><material name="orange"/></visual>
    <collision><geometry><mesh filename="elbow_Link.STL"/></geometry></collision>
  </link>

  <joint name="R_small_gear_fixed" type="fixed">
    <parent link="R_bicep"/><child link="R_small_gear"/>
    <origin xyz="0.012251040 0.020049085 -0.074446811"/>
  </joint>
  <link name="R_small_gear">
    <inertial><origin xyz="-0.004779000 0 0"/><mass value="0.000942778"/>
      <inertia ixx="4.33270428790079E-07" ixy="0" ixz="0" iyy="3.86651069848133E-07" iyz="0" izz="3.86651069848133E-07"/>
    </inertial>
    <visual><geometry><mesh filename="small_gear_Link.STL"/></geometry></visual>
  </link>

  <joint name="R_elbow" type="revolute">
    <parent link="R_bicep"/><child link="R_forearm"/>
    <origin xyz="-0.000015060 0.020049616 -0.094646582" rpy="1.5707963 0 0"/>
    <axis xyz="-1 0 0"/>
    <limit lower="0" upper="2.0944" effort="3.0" velocity="4.2"/>
    <dynamics damping="0.15" friction="0.05"/>
  </joint>
  <link name="R_forearm">
    <inertial>
      <origin xyz="-0.000000 -0.003004 -0.012485"/>
      <mass value="0.020699741"/>
      <inertia ixx="0.00001097382" ixy="-0.00000000326" ixz="-0.00000000008" iyy="0.00000405101" iyz="-0.00000024760" izz="0.00001202303"/>
    </inertial>
    <visual><origin xyz="0.000071897 -0.066235683 0.013072476"/><geometry><mesh filename="short_arm_link.STL"/></geometry><material name="orange"/></visual>
    <collision><origin xyz="0.000071897 -0.066235683 0.013072476"/><geometry><mesh filename="short_arm_link.STL"/></geometry></collision>
  </link>

  <joint name="R_big_gear_fixed" type="fixed">
    <parent link="R_forearm"/><child link="R_big_gear"/>
    <origin xyz="0.012266100 0 0"/>
  </joint>
  <link name="R_big_gear">
    <inertial><origin xyz="-0.004779000 0 0"/><mass value="0.005722263"/>
      <inertia ixx="1.45911616699868E-05" ixy="0" ixz="0" iyy="8.32211862139204E-06" iyz="0" izz="8.33289258825403E-06"/>
    </inertial>
    <visual><geometry><mesh filename="big_gear_Link.STL"/></geometry></visual>
  </link>

  <joint name="L_hip_flex" type="revolute">
    <parent link="torso"/><child link="L_hip_link"/>
    <origin xyz="0 0.065 0.4846"/><axis xyz="0 -1 0"/>
    <limit lower="-1.0" upper="2.1" effort="3.0" velocity="4.2"/>
  </joint>
  <link name="L_hip_link"><inertial><mass value="0.05"/><inertia ixx="1e-4" iyy="1e-4" izz="1e-4" ixy="0" ixz="0" iyz="0"/></inertial></link>
  <joint name="L_hip_abd" type="revolute">
    <parent link="L_hip_link"/><child link="L_thigh"/>
    <origin xyz="0 0 0"/><axis xyz="1 0 0"/>
    <limit lower="-0.4" upper="1.2" effort="3.0" velocity="4.2"/>
  </joint>
  <link name="L_thigh">
    <visual><geometry><box size="0.032 0.032 0.224"/></geometry><origin xyz="0 0 -0.112"/><material name="blue"/></visual>
    <collision><geometry><box size="0.032 0.032 0.224"/></geometry><origin xyz="0 0 -0.112"/></collision>
    <inertial><mass value="0.16"/><origin xyz="0 0 -0.112"/><inertia ixx="0.0007" iyy="0.0007" izz="0.00003" ixy="0" ixz="0" iyz="0"/></inertial>
  </link>
  <joint name="L_knee" type="revolute">
    <parent link="L_thigh"/><child link="L_shin"/>
    <origin xyz="0 0 -0.224"/><axis xyz="0 1 0"/>
    <limit lower="0" upper="2.4" effort="3.0" velocity="4.2"/>
  </joint>
  <link name="L_shin">
    <visual><geometry><box size="0.026 0.026 0.2249"/></geometry><origin xyz="0 0 -0.11245"/><material name="blue"/></visual>
    <collision><geometry><box size="0.026 0.026 0.2249"/></geometry><origin xyz="0 0 -0.11245"/></collision>
    <!-- foot: 139 mm long x 35.7 mm tall, so the robot stands at the full 36 in
         (stature is measured to the floor, and the leg chain ends at the ankle) -->
    <visual><geometry><box size="0.139 0.050 0.0357"/></geometry><origin xyz="0.030 0 -0.24275"/><material name="blue"/></visual>
    <collision><geometry><box size="0.139 0.050 0.0357"/></geometry><origin xyz="0.030 0 -0.24275"/></collision>
    <inertial><mass value="0.11"/><origin xyz="0 0 -0.112"/><inertia ixx="0.0005" iyy="0.0005" izz="0.00002" ixy="0" ixz="0" iyz="0"/></inertial>
  </link>

  <joint name="R_hip_flex" type="revolute">
    <parent link="torso"/><child link="R_hip_link"/>
    <origin xyz="0 -0.065 0.4846"/><axis xyz="0 -1 0"/>
    <limit lower="-1.0" upper="2.1" effort="3.0" velocity="4.2"/>
  </joint>
  <link name="R_hip_link"><inertial><mass value="0.05"/><inertia ixx="1e-4" iyy="1e-4" izz="1e-4" ixy="0" ixz="0" iyz="0"/></inertial></link>
  <joint name="R_hip_abd" type="revolute">
    <parent link="R_hip_link"/><child link="R_thigh"/>
    <origin xyz="0 0 0"/><axis xyz="-1 0 0"/>
    <limit lower="-0.4" upper="1.2" effort="3.0" velocity="4.2"/>
  </joint>
  <link name="R_thigh">
    <visual><geometry><box size="0.032 0.032 0.224"/></geometry><origin xyz="0 0 -0.112"/><material name="orange"/></visual>
    <collision><geometry><box size="0.032 0.032 0.224"/></geometry><origin xyz="0 0 -0.112"/></collision>
    <inertial><mass value="0.16"/><origin xyz="0 0 -0.112"/><inertia ixx="0.0007" iyy="0.0007" izz="0.00003" ixy="0" ixz="0" iyz="0"/></inertial>
  </link>
  <joint name="R_knee" type="revolute">
    <parent link="R_thigh"/><child link="R_shin"/>
    <origin xyz="0 0 -0.224"/><axis xyz="0 1 0"/>
    <limit lower="0" upper="2.4" effort="3.0" velocity="4.2"/>
  </joint>
  <link name="R_shin">
    <visual><geometry><box size="0.026 0.026 0.2249"/></geometry><origin xyz="0 0 -0.11245"/><material name="orange"/></visual>
    <collision><geometry><box size="0.026 0.026 0.2249"/></geometry><origin xyz="0 0 -0.11245"/></collision>
    <!-- foot: 139 mm long x 35.7 mm tall, so the robot stands at the full 36 in
         (stature is measured to the floor, and the leg chain ends at the ankle) -->
    <visual><geometry><box size="0.139 0.050 0.0357"/></geometry><origin xyz="0.030 0 -0.24275"/><material name="orange"/></visual>
    <collision><geometry><box size="0.139 0.050 0.0357"/></geometry><origin xyz="0.030 0 -0.24275"/></collision>
    <inertial><mass value="0.11"/><origin xyz="0 0 -0.112"/><inertia ixx="0.0005" iyy="0.0005" izz="0.00002" ixy="0" ixz="0" iyz="0"/></inertial>
  </link>

</robot>
