danbita/real-steel/random files/humanoid_full.urdf

<?xml version="1.0"?>
<!-- humanoid_full.urdf  (generated) — torso, neck+head, arms with 5-finger
     hands, legs with feet. All joints hinge about Y (forward/back). -->
<robot name="humanoid_full">
  <material name="gray"><color rgba="0.45 0.47 0.52 1"/></material>
  <material name="blue"><color rgba="0.2 0.5 0.9 1"/></material>
  <material name="orange"><color rgba="0.95 0.55 0.2 1"/></material>
  <material name="tan"><color rgba="0.85 0.72 0.6 1"/></material>
  <material name="dark"><color rgba="0.25 0.27 0.32 1"/></material>
  <link name="torso">
    <visual><geometry><box size="0.20 0.34 0.65"/></geometry><origin xyz="0 0 0.325"/><material name="gray"/></visual>
    <collision><geometry><box size="0.20 0.34 0.65"/></geometry><origin xyz="0 0 0.325"/></collision>
    <inertial><mass value="8.0"/><inertia ixx="0.1" iyy="0.1" izz="0.05" ixy="0" ixz="0" iyz="0"/></inertial>
  </link>
  <joint name="neck" type="revolute">
    <parent link="torso"/><child link="head"/>
    <origin xyz="0 0 0.66"/><axis xyz="0 1 0"/>
    <limit lower="-0.6" upper="0.6" effort="30" velocity="6"/>
  </joint>
  <link name="head">
    <visual><geometry><sphere radius="0.12"/></geometry><origin xyz="0 0 0.12"/><material name="tan"/></visual>
    <collision><geometry><sphere radius="0.12"/></geometry><origin xyz="0 0 0.12"/></collision>
    <inertial><mass value="1.0"/><origin xyz="0 0 0.12"/><inertia ixx="0.005" iyy="0.005" izz="0.005" ixy="0" ixz="0" iyz="0"/></inertial>
  </link>
  <joint name="L_shoulder" type="revolute">
    <parent link="torso"/><child link="L_uparm"/>
    <origin xyz="0 0.2 0.6"/><axis xyz="0 1 0"/>
    <limit lower="-1.5" upper="1.5" effort="30" velocity="6"/>
  </joint>
  <link name="L_uparm">
    <visual><geometry><box size="0.06 0.06 0.3"/></geometry><origin xyz="0 0 -0.15"/><material name="blue"/></visual>
    <collision><geometry><box size="0.06 0.06 0.3"/></geometry><origin xyz="0 0 -0.15"/></collision>
    <inertial><mass value="0.8"/><origin xyz="0 0 -0.15"/><inertia ixx="0.006" iyy="0.006" izz="0.006" ixy="0" ixz="0" iyz="0"/></inertial>
  </link>
  <joint name="L_elbow" type="revolute">
    <parent link="L_uparm"/><child link="L_forearm"/>
    <origin xyz="0 0 -0.3"/><axis xyz="0 -1 0"/>
    <limit lower="0.0" upper="2.5" effort="30" velocity="6"/>
  </joint>
  <link name="L_forearm">
    <visual><geometry><box size="0.05 0.05 0.28"/></geometry><origin xyz="0 0 -0.14"/><material name="blue"/></visual>
    <collision><geometry><box size="0.05 0.05 0.28"/></geometry><origin xyz="0 0 -0.14"/></collision>
    <inertial><mass value="0.6"/><origin xyz="0 0 -0.14"/><inertia ixx="0.004" iyy="0.004" izz="0.004" ixy="0" ixz="0" iyz="0"/></inertial>
  </link>
  <joint name="L_wrist" type="revolute">
    <parent link="L_forearm"/><child link="L_palm"/>
    <origin xyz="0 0 -0.28"/><axis xyz="0 1 0"/>
    <limit lower="-0.8" upper="0.8" effort="30" velocity="6"/>
  </joint>
  <link name="L_palm">
    <visual><geometry><box size="0.05 0.1 0.06"/></geometry><origin xyz="0 0 -0.03"/><material name="blue"/></visual>
    <collision><geometry><box size="0.05 0.1 0.06"/></geometry><origin xyz="0 0 -0.03"/></collision>
    <inertial><mass value="0.25"/><origin xyz="0 0 -0.03"/><inertia ixx="0.0004" iyy="0.0004" izz="0.0004" ixy="0" ixz="0" iyz="0"/></inertial>
  </link>
  <joint name="L_index_mcp" type="revolute">
    <parent link="L_palm"/><child link="L_index_prox"/>
    <origin xyz="0 0.036 -0.06"/><axis xyz="0 1 0"/>
    <limit lower="0.0" upper="1.6" effort="30" velocity="6"/>
  </joint>
  <link name="L_index_prox">
    <visual><geometry><box size="0.016 0.016 0.045"/></geometry><origin xyz="0 0 -0.0225"/><material name="blue"/></visual>
    <collision><geometry><box size="0.016 0.016 0.045"/></geometry><origin xyz="0 0 -0.0225"/></collision>
    <inertial><mass value="0.02"/><origin xyz="0 0 -0.0225"/><inertia ixx="1e-05" iyy="1e-05" izz="1e-05" ixy="0" ixz="0" iyz="0"/></inertial>
  </link>
  <joint name="L_index_pip" type="revolute">
    <parent link="L_index_prox"/><child link="L_index_dist"/>
    <origin xyz="0 0 -0.045"/><axis xyz="0 1 0"/>
    <limit lower="0.0" upper="1.6" effort="30" velocity="6"/>
  </joint>
  <link name="L_index_dist">
    <visual><geometry><box size="0.014 0.014 0.035"/></geometry><origin xyz="0 0 -0.0175"/><material name="blue"/></visual>
    <collision><geometry><box size="0.014 0.014 0.035"/></geometry><origin xyz="0 0 -0.0175"/></collision>
    <inertial><mass value="0.015"/><origin xyz="0 0 -0.0175"/><inertia ixx="1e-05" iyy="1e-05" izz="1e-05" ixy="0" ixz="0" iyz="0"/></inertial>
  </link>
  <joint name="L_middle_mcp" type="revolute">
    <parent link="L_palm"/><child link="L_middle_prox"/>
    <origin xyz="0 0.012 -0.06"/><axis xyz="0 1 0"/>
    <limit lower="0.0" upper="1.6" effort="30" velocity="6"/>
  </joint>
  <link name="L_middle_prox">
    <visual><geometry><box size="0.016 0.016 0.045"/></geometry><origin xyz="0 0 -0.0225"/><material name="blue"/></visual>
    <collision><geometry><box size="0.016 0.016 0.045"/></geometry><origin xyz="0 0 -0.0225"/></collision>
    <inertial><mass value="0.02"/><origin xyz="0 0 -0.0225"/><inertia ixx="1e-05" iyy="1e-05" izz="1e-05" ixy="0" ixz="0" iyz="0"/></inertial>
  </link>
  <joint name="L_middle_pip" type="revolute">
    <parent link="L_middle_prox"/><child link="L_middle_dist"/>
    <origin xyz="0 0 -0.045"/><axis xyz="0 1 0"/>
    <limit lower="0.0" upper="1.6" effort="30" velocity="6"/>
  </joint>
  <link name="L_middle_dist">
    <visual><geometry><box size="0.014 0.014 0.035"/></geometry><origin xyz="0 0 -0.0175"/><material name="blue"/></visual>
    <collision><geometry><box size="0.014 0.014 0.035"/></geometry><origin xyz="0 0 -0.0175"/></collision>
    <inertial><mass value="0.015"/><origin xyz="0 0 -0.0175"/><inertia ixx="1e-05" iyy="1e-05" izz="1e-05" ixy="0" ixz="0" iyz="0"/></inertial>
  </link>
  <joint name="L_ring_mcp" type="revolute">
    <parent link="L_palm"/><child link="L_ring_prox"/>
    <origin xyz="0 -0.012 -0.06"/><axis xyz="0 1 0"/>
    <limit lower="0.0" upper="1.6" effort="30" velocity="6"/>
  </joint>
  <link name="L_ring_prox">
    <visual><geometry><box size="0.016 0.016 0.045"/></geometry><origin xyz="0 0 -0.0225"/><material name="blue"/></visual>
    <collision><geometry><box size="0.016 0.016 0.045"/></geometry><origin xyz="0 0 -0.0225"/></collision>
    <inertial><mass value="0.02"/><origin xyz="0 0 -0.0225"/><inertia ixx="1e-05" iyy="1e-05" izz="1e-05" ixy="0" ixz="0" iyz="0"/></inertial>
  </link>
  <joint name="L_ring_pip" type="revolute">
    <parent link="L_ring_prox"/><child link="L_ring_dist"/>
    <origin xyz="0 0 -0.045"/><axis xyz="0 1 0"/>
    <limit lower="0.0" upper="1.6" effort="30" velocity="6"/>
  </joint>
  <link name="L_ring_dist">
    <visual><geometry><box size="0.014 0.014 0.035"/></geometry><origin xyz="0 0 -0.0175"/><material name="blue"/></visual>
    <collision><geometry><box size="0.014 0.014 0.035"/></geometry><origin xyz="0 0 -0.0175"/></collision>
    <inertial><mass value="0.015"/><origin xyz="0 0 -0.0175"/><inertia ixx="1e-05" iyy="1e-05" izz="1e-05" ixy="0" ixz="0" iyz="0"/></inertial>
  </link>
  <joint name="L_pinky_mcp" type="revolute">
    <parent link="L_palm"/><child link="L_pinky_prox"/>
    <origin xyz="0 -0.036 -0.06"/><axis xyz="0 1 0"/>
    <limit lower="0.0" upper="1.6" effort="30" velocity="6"/>
  </joint>
  <link name="L_pinky_prox">
    <visual><geometry><box size="0.016 0.016 0.045"/></geometry><origin xyz="0 0 -0.0225"/><material name="blue"/></visual>
    <collision><geometry><box size="0.016 0.016 0.045"/></geometry><origin xyz="0 0 -0.0225"/></collision>
    <inertial><mass value="0.02"/><origin xyz="0 0 -0.0225"/><inertia ixx="1e-05" iyy="1e-05" izz="1e-05" ixy="0" ixz="0" iyz="0"/></inertial>
  </link>
  <joint name="L_pinky_pip" type="revolute">
    <parent link="L_pinky_prox"/><child link="L_pinky_dist"/>
    <origin xyz="0 0 -0.045"/><axis xyz="0 1 0"/>
    <limit lower="0.0" upper="1.6" effort="30" velocity="6"/>
  </joint>
  <link name="L_pinky_dist">
    <visual><geometry><box size="0.014 0.014 0.035"/></geometry><origin xyz="0 0 -0.0175"/><material name="blue"/></visual>
    <collision><geometry><box size="0.014 0.014 0.035"/></geometry><origin xyz="0 0 -0.0175"/></collision>
    <inertial><mass value="0.015"/><origin xyz="0 0 -0.0175"/><inertia ixx="1e-05" iyy="1e-05" izz="1e-05" ixy="0" ixz="0" iyz="0"/></inertial>
  </link>
  <joint name="L_thumb_mcp" type="revolute">
    <parent link="L_palm"/><child link="L_thumb_prox"/>
    <origin xyz="0 0.05 -0.02"/><axis xyz="1 0 0"/>
    <limit lower="-1.2" upper="1.2" effort="30" velocity="6"/>
  </joint>
  <link name="L_thumb_prox">
    <visual><geometry><box size="0.018 0.018 0.04"/></geometry><origin xyz="0 0 -0.02"/><material name="blue"/></visual>
    <collision><geometry><box size="0.018 0.018 0.04"/></geometry><origin xyz="0 0 -0.02"/></collision>
    <inertial><mass value="0.02"/><origin xyz="0 0 -0.02"/><inertia ixx="1e-05" iyy="1e-05" izz="1e-05" ixy="0" ixz="0" iyz="0"/></inertial>
  </link>
  <joint name="L_thumb_ip" type="revolute">
    <parent link="L_thumb_prox"/><child link="L_thumb_dist"/>
    <origin xyz="0 0 -0.04"/><axis xyz="0 1 0"/>
    <limit lower="0.0" upper="1.4" effort="30" velocity="6"/>
  </joint>
  <link name="L_thumb_dist">
    <visual><geometry><box size="0.016 0.016 0.03"/></geometry><origin xyz="0 0 -0.015"/><material name="blue"/></visual>
    <collision><geometry><box size="0.016 0.016 0.03"/></geometry><origin xyz="0 0 -0.015"/></collision>
    <inertial><mass value="0.015"/><origin xyz="0 0 -0.015"/><inertia ixx="1e-05" iyy="1e-05" izz="1e-05" ixy="0" ixz="0" iyz="0"/></inertial>
  </link>
  <joint name="R_shoulder" type="revolute">
    <parent link="torso"/><child link="R_uparm"/>
    <origin xyz="0 -0.2 0.6"/><axis xyz="0 1 0"/>
    <limit lower="-1.5" upper="1.5" effort="30" velocity="6"/>
  </joint>
  <link name="R_uparm">
    <visual><geometry><box size="0.06 0.06 0.3"/></geometry><origin xyz="0 0 -0.15"/><material name="orange"/></visual>
    <collision><geometry><box size="0.06 0.06 0.3"/></geometry><origin xyz="0 0 -0.15"/></collision>
    <inertial><mass value="0.8"/><origin xyz="0 0 -0.15"/><inertia ixx="0.006" iyy="0.006" izz="0.006" ixy="0" ixz="0" iyz="0"/></inertial>
  </link>
  <joint name="R_elbow" type="revolute">
    <parent link="R_uparm"/><child link="R_forearm"/>
    <origin xyz="0 0 -0.3"/><axis xyz="0 -1 0"/>
    <limit lower="0.0" upper="2.5" effort="30" velocity="6"/>
  </joint>
  <link name="R_forearm">
    <visual><geometry><box size="0.05 0.05 0.28"/></geometry><origin xyz="0 0 -0.14"/><material name="orange"/></visual>
    <collision><geometry><box size="0.05 0.05 0.28"/></geometry><origin xyz="0 0 -0.14"/></collision>
    <inertial><mass value="0.6"/><origin xyz="0 0 -0.14"/><inertia ixx="0.004" iyy="0.004" izz="0.004" ixy="0" ixz="0" iyz="0"/></inertial>
  </link>
  <joint name="R_wrist" type="revolute">
    <parent link="R_forearm"/><child link="R_palm"/>
    <origin xyz="0 0 -0.28"/><axis xyz="0 1 0"/>
    <limit lower="-0.8" upper="0.8" effort="30" velocity="6"/>
  </joint>
  <link name="R_palm">
    <visual><geometry><box size="0.05 0.1 0.06"/></geometry><origin xyz="0 0 -0.03"/><material name="orange"/></visual>
    <collision><geometry><box size="0.05 0.1 0.06"/></geometry><origin xyz="0 0 -0.03"/></collision>
    <inertial><mass value="0.25"/><origin xyz="0 0 -0.03"/><inertia ixx="0.0004" iyy="0.0004" izz="0.0004" ixy="0" ixz="0" iyz="0"/></inertial>
  </link>
  <joint name="R_index_mcp" type="revolute">
    <parent link="R_palm"/><child link="R_index_prox"/>
    <origin xyz="0 0.036 -0.06"/><axis xyz="0 1 0"/>
    <limit lower="0.0" upper="1.6" effort="30" velocity="6"/>
  </joint>
  <link name="R_index_prox">
    <visual><geometry><box size="0.016 0.016 0.045"/></geometry><origin xyz="0 0 -0.0225"/><material name="orange"/></visual>
    <collision><geometry><box size="0.016 0.016 0.045"/></geometry><origin xyz="0 0 -0.0225"/></collision>
    <inertial><mass value="0.02"/><origin xyz="0 0 -0.0225"/><inertia ixx="1e-05" iyy="1e-05" izz="1e-05" ixy="0" ixz="0" iyz="0"/></inertial>
  </link>
  <joint name="R_index_pip" type="revolute">
    <parent link="R_index_prox"/><child link="R_index_dist"/>
    <origin xyz="0 0 -0.045"/><axis xyz="0 1 0"/>
    <limit lower="0.0" upper="1.6" effort="30" velocity="6"/>
  </joint>
  <link name="R_index_dist">
    <visual><geometry><box size="0.014 0.014 0.035"/></geometry><origin xyz="0 0 -0.0175"/><material name="orange"/></visual>
    <collision><geometry><box size="0.014 0.014 0.035"/></geometry><origin xyz="0 0 -0.0175"/></collision>
    <inertial><mass value="0.015"/><origin xyz="0 0 -0.0175"/><inertia ixx="1e-05" iyy="1e-05" izz="1e-05" ixy="0" ixz="0" iyz="0"/></inertial>
  </link>
  <joint name="R_middle_mcp" type="revolute">
    <parent link="R_palm"/><child link="R_middle_prox"/>
    <origin xyz="0 0.012 -0.06"/><axis xyz="0 1 0"/>
    <limit lower="0.0" upper="1.6" effort="30" velocity="6"/>
  </joint>
  <link name="R_middle_prox">
    <visual><geometry><box size="0.016 0.016 0.045"/></geometry><origin xyz="0 0 -0.0225"/><material name="orange"/></visual>
    <collision><geometry><box size="0.016 0.016 0.045"/></geometry><origin xyz="0 0 -0.0225"/></collision>
    <inertial><mass value="0.02"/><origin xyz="0 0 -0.0225"/><inertia ixx="1e-05" iyy="1e-05" izz="1e-05" ixy="0" ixz="0" iyz="0"/></inertial>
  </link>
  <joint name="R_middle_pip" type="revolute">
    <parent link="R_middle_prox"/><child link="R_middle_dist"/>
    <origin xyz="0 0 -0.045"/><axis xyz="0 1 0"/>
    <limit lower="0.0" upper="1.6" effort="30" velocity="6"/>
  </joint>
  <link name="R_middle_dist">
    <visual><geometry><box size="0.014 0.014 0.035"/></geometry><origin xyz="0 0 -0.0175"/><material name="orange"/></visual>
    <collision><geometry><box size="0.014 0.014 0.035"/></geometry><origin xyz="0 0 -0.0175"/></collision>
    <inertial><mass value="0.015"/><origin xyz="0 0 -0.0175"/><inertia ixx="1e-05" iyy="1e-05" izz="1e-05" ixy="0" ixz="0" iyz="0"/></inertial>
  </link>
  <joint name="R_ring_mcp" type="revolute">
    <parent link="R_palm"/><child link="R_ring_prox"/>
    <origin xyz="0 -0.012 -0.06"/><axis xyz="0 1 0"/>
    <limit lower="0.0" upper="1.6" effort="30" velocity="6"/>
  </joint>
  <link name="R_ring_prox">
    <visual><geometry><box size="0.016 0.016 0.045"/></geometry><origin xyz="0 0 -0.0225"/><material name="orange"/></visual>
    <collision><geometry><box size="0.016 0.016 0.045"/></geometry><origin xyz="0 0 -0.0225"/></collision>
    <inertial><mass value="0.02"/><origin xyz="0 0 -0.0225"/><inertia ixx="1e-05" iyy="1e-05" izz="1e-05" ixy="0" ixz="0" iyz="0"/></inertial>
  </link>
  <joint name="R_ring_pip" type="revolute">
    <parent link="R_ring_prox"/><child link="R_ring_dist"/>
    <origin xyz="0 0 -0.045"/><axis xyz="0 1 0"/>
    <limit lower="0.0" upper="1.6" effort="30" velocity="6"/>
  </joint>
  <link name="R_ring_dist">
    <visual><geometry><box size="0.014 0.014 0.035"/></geometry><origin xyz="0 0 -0.0175"/><material name="orange"/></visual>
    <collision><geometry><box size="0.014 0.014 0.035"/></geometry><origin xyz="0 0 -0.0175"/></collision>
    <inertial><mass value="0.015"/><origin xyz="0 0 -0.0175"/><inertia ixx="1e-05" iyy="1e-05" izz="1e-05" ixy="0" ixz="0" iyz="0"/></inertial>
  </link>
  <joint name="R_pinky_mcp" type="revolute">
    <parent link="R_palm"/><child link="R_pinky_prox"/>
    <origin xyz="0 -0.036 -0.06"/><axis xyz="0 1 0"/>
    <limit lower="0.0" upper="1.6" effort="30" velocity="6"/>
  </joint>
  <link name="R_pinky_prox">
    <visual><geometry><box size="0.016 0.016 0.045"/></geometry><origin xyz="0 0 -0.0225"/><material name="orange"/></visual>
    <collision><geometry><box size="0.016 0.016 0.045"/></geometry><origin xyz="0 0 -0.0225"/></collision>
    <inertial><mass value="0.02"/><origin xyz="0 0 -0.0225"/><inertia ixx="1e-05" iyy="1e-05" izz="1e-05" ixy="0" ixz="0" iyz="0"/></inertial>
  </link>
  <joint name="R_pinky_pip" type="revolute">
    <parent link="R_pinky_prox"/><child link="R_pinky_dist"/>
    <origin xyz="0 0 -0.045"/><axis xyz="0 1 0"/>
    <limit lower="0.0" upper="1.6" effort="30" velocity="6"/>
  </joint>
  <link name="R_pinky_dist">
    <visual><geometry><box size="0.014 0.014 0.035"/></geometry><origin xyz="0 0 -0.0175"/><material name="orange"/></visual>
    <collision><geometry><box size="0.014 0.014 0.035"/></geometry><origin xyz="0 0 -0.0175"/></collision>
    <inertial><mass value="0.015"/><origin xyz="0 0 -0.0175"/><inertia ixx="1e-05" iyy="1e-05" izz="1e-05" ixy="0" ixz="0" iyz="0"/></inertial>
  </link>
  <joint name="R_thumb_mcp" type="revolute">
    <parent link="R_palm"/><child link="R_thumb_prox"/>
    <origin xyz="0 -0.05 -0.02"/><axis xyz="1 0 0"/>
    <limit lower="-1.2" upper="1.2" effort="30" velocity="6"/>
  </joint>
  <link name="R_thumb_prox">
    <visual><geometry><box size="0.018 0.018 0.04"/></geometry><origin xyz="0 0 -0.02"/><material name="orange"/></visual>
    <collision><geometry><box size="0.018 0.018 0.04"/></geometry><origin xyz="0 0 -0.02"/></collision>
    <inertial><mass value="0.02"/><origin xyz="0 0 -0.02"/><inertia ixx="1e-05" iyy="1e-05" izz="1e-05" ixy="0" ixz="0" iyz="0"/></inertial>
  </link>
  <joint name="R_thumb_ip" type="revolute">
    <parent link="R_thumb_prox"/><child link="R_thumb_dist"/>
    <origin xyz="0 0 -0.04"/><axis xyz="0 1 0"/>
    <limit lower="0.0" upper="1.4" effort="30" velocity="6"/>
  </joint>
  <link name="R_thumb_dist">
    <visual><geometry><box size="0.016 0.016 0.03"/></geometry><origin xyz="0 0 -0.015"/><material name="orange"/></visual>
    <collision><geometry><box size="0.016 0.016 0.03"/></geometry><origin xyz="0 0 -0.015"/></collision>
    <inertial><mass value="0.015"/><origin xyz="0 0 -0.015"/><inertia ixx="1e-05" iyy="1e-05" izz="1e-05" ixy="0" ixz="0" iyz="0"/></inertial>
  </link>
  <joint name="L_hip" type="revolute">
    <parent link="torso"/><child link="L_thigh"/>
    <origin xyz="0 0.1 0"/><axis xyz="0 1 0"/>
    <limit lower="-1.2" upper="1.2" effort="30" velocity="6"/>
  </joint>
  <link name="L_thigh">
    <visual><geometry><box size="0.09 0.09 0.4"/></geometry><origin xyz="0 0 -0.2"/><material name="blue"/></visual>
    <collision><geometry><box size="0.09 0.09 0.4"/></geometry><origin xyz="0 0 -0.2"/></collision>
    <inertial><mass value="1.5"/><origin xyz="0 0 -0.2"/><inertia ixx="0.02" iyy="0.02" izz="0.02" ixy="0" ixz="0" iyz="0"/></inertial>
  </link>
  <joint name="L_knee" type="revolute">
    <parent link="L_thigh"/><child link="L_shin"/>
    <origin xyz="0 0 -0.4"/><axis xyz="0 1 0"/>
    <limit lower="0.0" upper="2.4" effort="30" velocity="6"/>
  </joint>
  <link name="L_shin">
    <visual><geometry><box size="0.07 0.07 0.4"/></geometry><origin xyz="0 0 -0.2"/><material name="blue"/></visual>
    <collision><geometry><box size="0.07 0.07 0.4"/></geometry><origin xyz="0 0 -0.2"/></collision>
    <inertial><mass value="1.0"/><origin xyz="0 0 -0.2"/><inertia ixx="0.014" iyy="0.014" izz="0.014" ixy="0" ixz="0" iyz="0"/></inertial>
  </link>
  <joint name="L_ankle" type="revolute">
    <parent link="L_shin"/><child link="L_foot"/>
    <origin xyz="0 0 -0.4"/><axis xyz="0 1 0"/>
    <limit lower="-0.7" upper="0.7" effort="30" velocity="6"/>
  </joint>
  <link name="L_foot">
    <visual><geometry><box size="0.22 0.09 0.05"/></geometry><origin xyz="0.06 0 -0.025"/><material name="dark"/></visual>
    <collision><geometry><box size="0.22 0.09 0.05"/></geometry><origin xyz="0.06 0 -0.025"/></collision>
    <inertial><mass value="0.4"/><origin xyz="0.06 0 -0.025"/><inertia ixx="0.002" iyy="0.002" izz="0.002" ixy="0" ixz="0" iyz="0"/></inertial>
  </link>
  <joint name="R_hip" type="revolute">
    <parent link="torso"/><child link="R_thigh"/>
    <origin xyz="0 -0.1 0"/><axis xyz="0 1 0"/>
    <limit lower="-1.2" upper="1.2" effort="30" velocity="6"/>
  </joint>
  <link name="R_thigh">
    <visual><geometry><box size="0.09 0.09 0.4"/></geometry><origin xyz="0 0 -0.2"/><material name="orange"/></visual>
    <collision><geometry><box size="0.09 0.09 0.4"/></geometry><origin xyz="0 0 -0.2"/></collision>
    <inertial><mass value="1.5"/><origin xyz="0 0 -0.2"/><inertia ixx="0.02" iyy="0.02" izz="0.02" ixy="0" ixz="0" iyz="0"/></inertial>
  </link>
  <joint name="R_knee" type="revolute">
    <parent link="R_thigh"/><child link="R_shin"/>
    <origin xyz="0 0 -0.4"/><axis xyz="0 1 0"/>
    <limit lower="0.0" upper="2.4" effort="30" velocity="6"/>
  </joint>
  <link name="R_shin">
    <visual><geometry><box size="0.07 0.07 0.4"/></geometry><origin xyz="0 0 -0.2"/><material name="orange"/></visual>
    <collision><geometry><box size="0.07 0.07 0.4"/></geometry><origin xyz="0 0 -0.2"/></collision>
    <inertial><mass value="1.0"/><origin xyz="0 0 -0.2"/><inertia ixx="0.014" iyy="0.014" izz="0.014" ixy="0" ixz="0" iyz="0"/></inertial>
  </link>
  <joint name="R_ankle" type="revolute">
    <parent link="R_shin"/><child link="R_foot"/>
    <origin xyz="0 0 -0.4"/><axis xyz="0 1 0"/>
    <limit lower="-0.7" upper="0.7" effort="30" velocity="6"/>
  </joint>
  <link name="R_foot">
    <visual><geometry><box size="0.22 0.09 0.05"/></geometry><origin xyz="0.06 0 -0.025"/><material name="dark"/></visual>
    <collision><geometry><box size="0.22 0.09 0.05"/></geometry><origin xyz="0.06 0 -0.025"/></collision>
    <inertial><mass value="0.4"/><origin xyz="0.06 0 -0.025"/><inertia ixx="0.002" iyy="0.002" izz="0.002" ixy="0" ixz="0" iyz="0"/></inertial>
  </link>
</robot>
