danbita/real-steel/(commit log)

2026-08-06 Real Steel: video and live webcam motion capture to MuJoCo humanoid
    [arm.urdf, humanoid.urdf, humanoid_full.urdf]
2026-08-09 v3: 3D retargeting with 12-joint humanoid (flexion+abduction), One Euro filtering, L/R swap guard, bone-length depth correction, knee gating fix
    lamens terms: updated urdf file for fuller motion replication, implemented fuller 3d movement capture and replication, improve motion capture to account for partial figure display, and improved implemention of capturing bending limbs
    [humanoid.urdf, humanoid_v3.urdf]
2026-08-21 Mechanically developed robot, Mediapipe updates relative to hip other updates
    [arm.stl, atom_head.obj, balls.stl, bicep_Link.STL, big_gear_Link.STL, brg_pitch.stl, brg_pitch_r.stl, brg_roll.stl]
2026-08-21 Atom: shoulder v6 CAD, assembly manual, sim chain, demo media
    The physical-robot work moves into the team repo:
    - cad/shoulder_v6: 3-DOF shoulder (3x HTS-35H), left+right, physics-
    verified (>=1mm running clearance full envelope, every screw corridor
    probed). Real 25T hub+disc horns, servo-first twist on the factory
    M3x6 centre screw, printed-in M3 threads (no inserts needed).
    - docs/: assembly manual at docs/assembly/ (self-contained HTML, ready
    for Pages from /docs) + browsable step animations, shopping decisions,
    design principles. Guide opens with the sim-driven module animation
    and a Part breakdown dropdown with print dims + order links.
    - sim36/ + tools/render/: the v11 cha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
    [bicep_ref.step, bicep_ref.stl, brg_pitch.step, brg_pitch.stl, brg_twist.step, brg_twist.stl, carrier.step, carrier.stl]
2026-08-21 started developement on dual camera setup
    [armRosFile.csv, armRosFile.urdf, arm_sim.urdf, humanoid_arm_v4.urdf]
